charlesh97/electric-longboard-bms/Graphics/ESC3.png

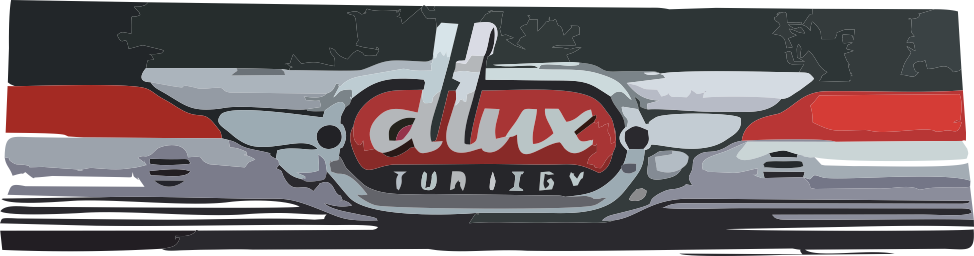
Graphics/ESC3.png
