charlesh97/electric-longboard-bms/Graphics/20160611_144058.jpg

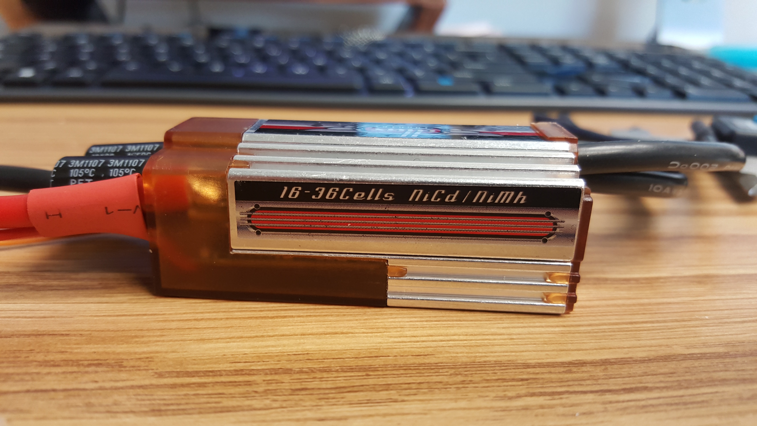
Graphics/20160611_144058.jpg
