charlesh97/electric-longboard-bms/README.md

# Electric Longboard

Archived project. 

Latest revision PDFs
[Schematic](https://gitlab.com/chood2/electric-longboard-bms/-/blob/main/HW/LongboardGaugev2%20SCH.pdf)
[PCB](https://gitlab.com/chood2/electric-longboard-bms/-/blob/main/HW/LongboardGaugev2%20PCB.pdf)
