charlesh97/electric-longboard-bms/Graphics/20160610_125514.jpg

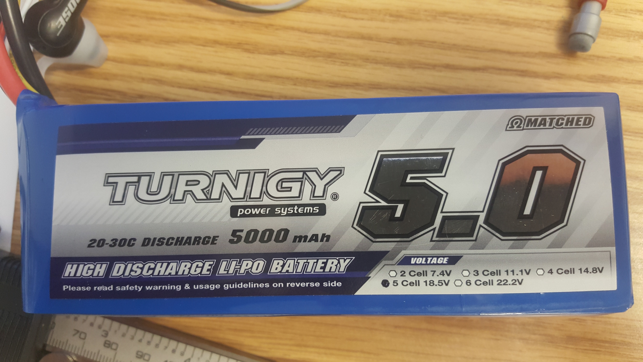
Graphics/20160610_125514.jpg
