charlesh97/electric-longboard-bms/Graphics/20160611_144035.jpg

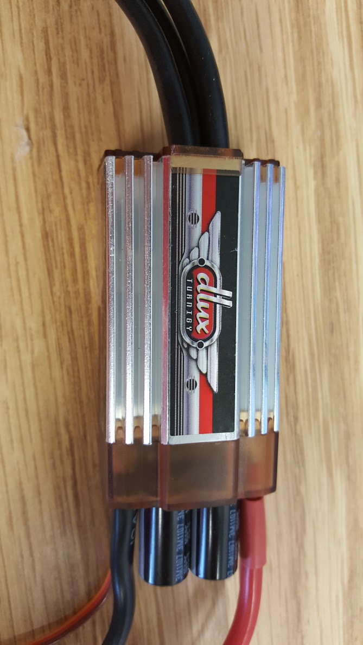
Graphics/20160611_144035.jpg
