charlesh97/electric-longboard-bms/Graphics/20160611_144050.jpg

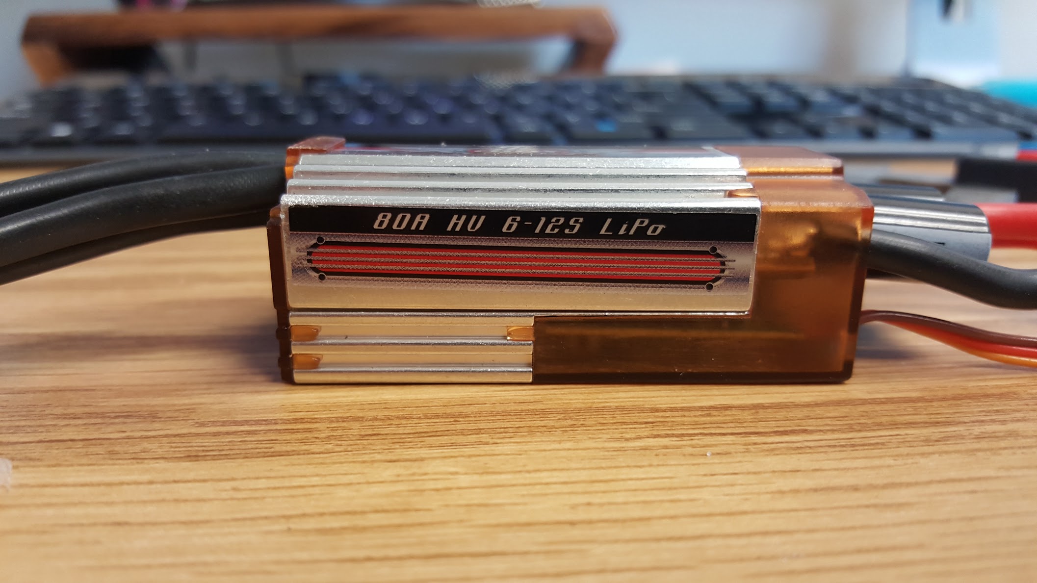
Graphics/20160611_144050.jpg
