charlesh97/electric-longboard-bms/Graphics/ESC1.png

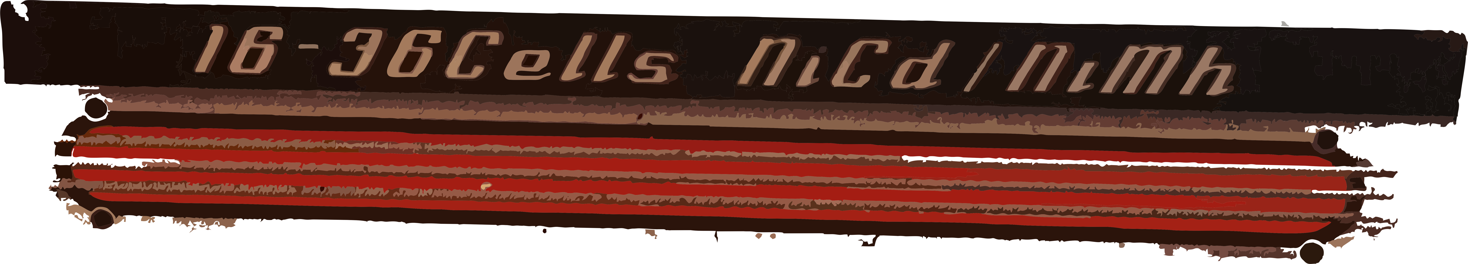
Graphics/ESC1.png
