charlesh97/electric-longboard-bms/Graphics/TurnigyBatteryGraphic.png

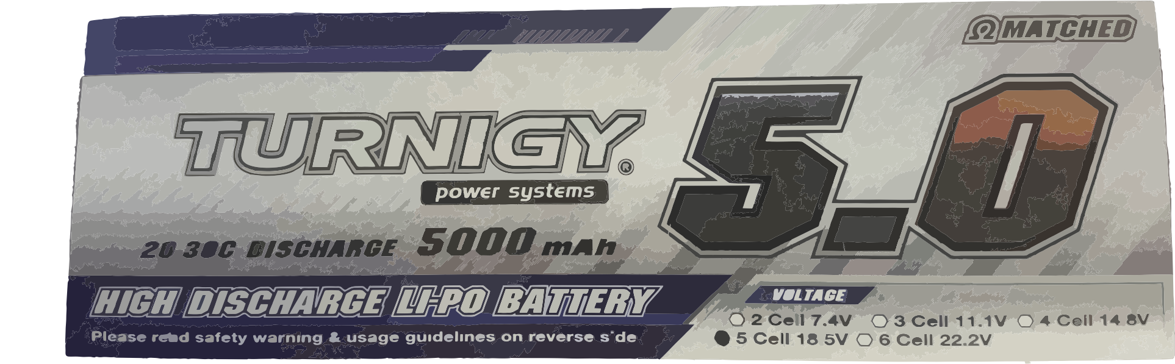
Graphics/TurnigyBatteryGraphic.png
