charlesh97/electric-longboard-bms/ElectricLongboardBOM.xlsx

Sheet: Sheet1
Part | Website | Quantity | Price | Subtotal | Notes | Bought?
Board | http://www.customskateboards.com/Blank-Podium | 1 | $48.00 | $48.00 |  | Y
Hardware | http://www.thelongboardstore.com/trucks/complete-kits/hardware-premium-assembly-kit/ | 1 | $20.00 | $20.00 |  | Y
Grip Tape | http://www.thelongboardstore.com/grip-tape/jessup/black-grip-tape-11-quot/ | 4 | $3.00 | $12.00 |  | Y
Speed Washers | http://www.thelongboardstore.com/hardware/speed-washers/speed-washers-8mm-black/ | 1 | $4.00 | $4.00 |  | Y
Trucks | http://www.amazon.com/Caliber-Fifty-Satin-Red-Trucks/dp/B00M6RWYB8?s=sporting-goods | 1 | $50.00 | $50.00 |  | Y
Wheels | http://www.amazon.com/Orangatang-Kegel-Orange-Longboard-Wheels/dp/B00EYDHWTQ | 1 | $60.00 | $60.00 | $194.00 | Y
Turnigy Aerodrive SK3 - 149kv | http://www.hobbyking.com/hobbyking/store/uh_viewItem.asp?idProduct=71864 | 1 | $67.70 | $45.92 |  | Y
80A ESC | http://www.hobbyking.com/hobbyking/store/__71036__Turnigy_dlux_80A_HV_Brushless_Speed_Controller_OPTO_AR_Warehouse_.html | 1 | $79.73 | $79.73 |  | Y
Shipping |  |  |  | $22.83 | $148.48 | Y
Gear (5mm Flange HTD 14tooth) | http://shop.sdp-si.com/catalog/product/?id=A_6A25M014DF1506 | 1 | $11.52 | $11.52
Gear (5mm HTD 36tooth) | http://shop.sdp-si.com/catalog/product/?id=A_6A25M036NF1510 | 1 | $21.47 | $21.47
Belt (15mm 49tooth 5mm HTD) | http://shop.sdp-si.com/catalog/product/?id=A_6R25M049150 | 1 | $11.16 | $11.16 | $44.15
Rubber Strip (2"x36"x3/16") 60A | https://www.grainger.com/product/GRAINGER-APPROVED-Rubber-Strip-WP165787/_/N-c1z?s_pp=false | 1 | $6.67 | $6.67
Braided Cable Sleeve (1/4"x10') | https://www.grainger.com/product/TECHFLEX-Expandable-Polyethylene-Terephthalate-WP5398576/_/N-rl1?s_pp=false | 1 | $3.92 | $3.92
Aluminum Plate (1/2"x6"x12") | https://www.grainger.com/product/GRAINGER-APPROVED-Bar-Stock-1ZCT6?functionCode=P2IDP2PCP | 1 | $23.05 | $23.05
Socket M10 20mm (pk of 10) Sale | https://www.grainger.com/product/GRAINGER-APPROVED-Metric-Socket-Head-Cap-Screw-6DA67?functionCode=P2IDP2PCP | 2 | $3.00 | $6.00
ABS Sheet 1/8"x48"x12" | http://www.grainger.com/product/GRAINGER-APPROVED-ABS-Sheet-Stock-WP143594/_/N-c1p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 | 2 | $13.54 | $27.08
Battery (Option 1: 5s 5Ah 20C) | http://www.hobbyking.com/hobbyking/store/uh_viewItem.asp?idProduct=9174 | 2 | $39.78 | $79.56
Compact Charger | http://www.hobbyking.com/hobbyking/store/__92016__Turnigy_B6_Compact_50W_5A_Automatic_Balance_Charger_2_6S_Lipoly_US_Warehouse_.html | 1 | $14.78 | $14.78
Turnigy Battery Charger 80W | http://www.hobbyking.com/hobbyking/store/__56900__Turnigy_Double_Tap_7A_80Wx2_6S_Balance_Charger_Discharger_US_Warehouse_.html | 1 | $61.06 | $61.06 | $155.40
El Wire | http://www.amazon.com/Blue-Neon-Glowing-Strobing-Electroluminescent/dp/B003J99JW4 | 1 | $3.78 | $3.78
LEDs | https://www.digikey.com/product-detail/en/cree-inc/XPEBTT-01-0000-00V80/XPEBTT-01-0000-00V80CT-ND/5725124 | 5 | $1.22 | $6.10
Components & PCB |  | 1 | $50.00 | $50.00
 |  |  |  | $618.63 | <--Total
Alternative
Gear (5mm Flange HTD 12tooth) | http://shop.sdp-si.com/catalog/product/?id=A_6A25M012DF1506 | 1 | $11.24
Gear (5mm HTD 40tooth) | http://shop.sdp-si.com/catalog/product/?id=A_6A25M040NF1510 | 1 | $24.95 | $24.95 | Tooth number TBD
Motor 236kV | http://www.hobbyking.com/hobbyking/store/__71859__Turnigy_Aerodrive_SK3_5065_236kv_Brushless_Outrunner_Motor_AR_Warehouse_.html | 1 | $58.14
LG HD2 18650 3.7V 2Ah 25A Cell | https://www.imrbatteries.com/lg-hd2-18650-2000mah-25a-flat-top-battery/ | 30 | $5.00 |  | $24.95
100A ESC | http://www.hobbyking.com/hobbyking/store/__38787__Turnigy_Sentilon_V4_100A_5_12s_HV_Bulletproof_Speed_Controller_w_RPM_Sensor.html | 1 | $85.58
Battery 10Ah | http://batterybuilding.en.made-in-china.com/product/eKEQsmVAvxpC/China-Rechargeable-LiFePO4-Prismatic-Battery-Pack-3-2V-20ah-for-EV-or-Power-Tools.html | 10 | $1.00
Sony VTC5 2600mAh 30A | http://www.dhgate.com/product/100-authentic-original-18650-rechargeable/214526805.html | 30 | $3.81
Sony VTC5 | http://www.aliexpress.com/item/16Pcs-Original-US18650VTC5-3-7V-2600mAh-18650-high-drain-30A-vtc5-battery-for-Sony-electonic-cigarette/32607288152.html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 | 1 | $94.63 | $154.63
Motor 192kV | http://www.hobbyking.com/hobbyking/store/__18129__Turnigy_Aerodrive_SK3_6374_192kv_Brushless_Outrunner_Motor.html
Power Plug (Female) | http://www.digikey.com/product-detail/en/switchcraft-inc/L712RAS/SC1394-ND/2238437 | 1 | $6.88 | $6.88
Cell Terminal Clip | http://www.digikey.com/product-detail/en/keystone-electronics/5231/36-5231-ND/316380 | 60 | $0.20 | $12.12
BQ76940 | http://www.digikey.com/product-detail/en/texas-instruments/BQ7694003DBT/296-37789-5-ND/4842191 | 1 | $10.15 | $10.15
BQ78350 | http://www.digikey.com/product-detail/en/texas-instruments/BQ78350DBT/296-38026-5-ND/4959466 | 1 | $6.45 | $6.45
Extra Circuit Components |  | 1 | $50.00 | $50.00 | Guess-timation
PCB |  | 1 | $15.00 | $15.00 | Might get free

Sheet: Sheet2
Index | Quantity | Part Number | Manufacturer Part Number | Description | Customer Reference | Backorder | Unit Price | Extended Price
1 | 10 | 490-12344-1-ND | GRT21BC81C106ME01L | CAP CER 10UF 16V X6S 0805 |  | 0 | 0.146 | $1.46
2 | 10 | 490-3338-1-ND | GRM21BR61C475KA88L | CAP CER 4.7UF 16V X5R 0805 |  | 0 | 0.12 | $1.20
3 | 50 | 1276-6495-1-ND | CL21F105ZBFNNNG | CAP CER 1UF 50V Y5V 0805 |  | 0 | 0.022 | $1.10
4 | 50 | 1276-1003-1-ND | CL21B104KBCNNNC | CAP CER 0.1UF 50V X7R 0805 |  | 0 | 0.026 | $1.30
5 | 10 | 490-1308-1-ND | GRM155R71H472KA01D | CAP CER 4700PF 50V X7R 0402 |  | 0 | 0.011 | $0.11
6 | 10 | 490-3248-1-ND | GRM155R71H332KA01D | CAP CER 3300PF 50V X7R 0402 |  | 0 | 0.011 | $0.11
7 | 10 | 490-1297-1-ND | GRM1555C1H471JA01D | CAP CER 470PF 50V NP0 0402 |  | 0 | 0.026 | $0.26
8 | 50 | P1.00MFCT-ND | ERJ-8ENF1004V | RES SMD 1M OHM 1% 1/4W 1206 |  | 0 | 0.0282 | $1.41
9 | 3 | P300KDACT-ND | ERA-6AEB304V | RES SMD 300K OHM 0.1% 1/8W 0805 |  | 0 | 0.63 | $1.89
10 | 50 | P221KCCT-ND | ERJ-6ENF2213V | RES SMD 221K OHM 1% 1/8W 0805 |  | 0 | 0.022 | $1.10
11 | 50 | P100KCCT-ND | ERJ-6ENF1003V | RES SMD 100K OHM 1% 1/8W 0805 |  | 0 | 0.022 | $1.10
12 | 3 | P13.7KDACT-ND | ERA-6AEB1372V | RES SMD 13.7K OHM 0.1% 1/8W 0805 |  | 0 | 0.63 | $1.89
13 | 50 | P3.01KCCT-ND | ERJ-6ENF3011V | RES SMD 3.01K OHM 1% 1/8W 0805 |  | 0 | 0.022 | $1.10
14 | 4 | 541-1.00KAFCT-ND | CRCW25121K00FKEG | RES SMD 1K OHM 1% 1W 2512 |  | 0 | 0.36 | $1.44
15 | 50 | P1.00KCCT-ND | ERJ-6ENF1001V | RES SMD 1K OHM 1% 1/8W 0805 |  | 0 | 0.022 | $1.10
16 | 50 | 1276-5671-1-ND | RC3216F101CS | RES SMD 100 OHM 1% 1/4W 1206 |  | 0 | 0.0184 | $0.92
17 | 50 | P100CCT-ND | ERJ-6ENF1000V | RES SMD 100 OHM 1% 1/8W 0805 |  | 0 | 0.022 | $1.10
18 | 10 | 490-4801-1-ND | NCP15XH103F03RC | THERMISTOR 10K OHM NTC 0402 SMD |  | 0 | 0.107 | $1.07
19 | 2 | SMCJ28AFSCT-ND | SMCJ28A | TVS DIODE 28VWM 45.4VC SMC |  | 0 | 0.46 | $0.92
20 | 10 | 1N4148W-FDICT-ND | 1N4148W-7-F | DIODE GEN PURP 100V 300MA SOD123 |  | 0 | 0.149 | $1.49
21 | 2 | MURS360T3GOSCT-ND | MURS360T3G | DIODE GEN PURP 600V 3A SMC |  | 0 | 0.65 | $1.30
22 | 10 | MMSZ5232BS-FDICT-ND | MMSZ5232BS-7-F | DIODE ZENER 5.6V 200MW SOD323 |  | 0 | 0.247 | $2.47
23 | 4 | MMSZ5246B-FDICT-ND | MMSZ5246B-7-F | DIODE ZENER 16V 500MW SOD123 |  | 0 | 0.2 | $0.80
24 | 2 | SMBJ30A-FDICT-ND | SMBJ30A-13-F | TVS DIODE 30VWM 48.4VC SMB |  | 0 | 0.36 | $0.72
25 | 2 | MUR860GOS-ND | MUR860G | DIODE GEN PURP 600V 8A TO220AC |  | 0 | 0.9 | $1.80
26 | 4 | 296-30572-1-ND | CSD18504Q5A | MOSFET N-CH 40V 8SON |  | 0 | 1.53 | $6.12
27 | 10 | BSS138CT-ND | BSS138 | MOSFET N-CH 50V 220MA SOT-23 |  | 0 | 0.178 | $1.78
28 | 10 | BSS84PH6433XTMA1CT-ND | BSS84PH6433XTMA1 | MOSFET P-CH 60V 170MA SOT-23 |  | 0 | 0.167 | $1.67
29 | 4 | MMBT3906FSCT-ND | MMBT3906 | TRANS PNP 40V 0.2A SOT-23 |  | 0 | 0.2 | $0.80
30 | 1 | SC1396-ND | JCAP | POWER JACK SEAL CAP |  | 0 | 1.65 | $1.65
31 | 1 | SC1390-ND | L712AS | CONN PWR JACK 2.5MM SEALED |  | 0 | 6.55 | $6.55
32 | 10 | 455-2271-ND | B6B-XH-A(LF)(SN) | CONN HEADER XH TOP 6POS 2.5MM |  | 0 | 0.258 | $2.58
33 | 2 | 497-13798-1-ND | STCC2540IQTR | IC USB CHARGING CTLR SW 16VFQFPN |  | 0 | 1.09 | $2.18
34 | 50 | P10.0KCCT-ND | ERJ-6ENF1002V | RES SMD 10K OHM 1% 1/8W 0805 |  | 0 | 0.022 | $1.10
35 | 50 | P499KCCT-ND | ERJ-6ENF4993V | RES SMD 499K OHM 1% 1/8W 0805 |  | 0 | 0.022 | $1.10
36 | 2 | 296-43798-1-ND | LDC0851HDSGT | INDUCTIVE PROXIMITY SWITCH 8WSON |  | 0 | 1.34 | $2.68
 |  |  |  |  |  |  | Subtotal | $57.37
