charlesh97/electric-longboard-bms/CAD/handheld_.SLDPRT

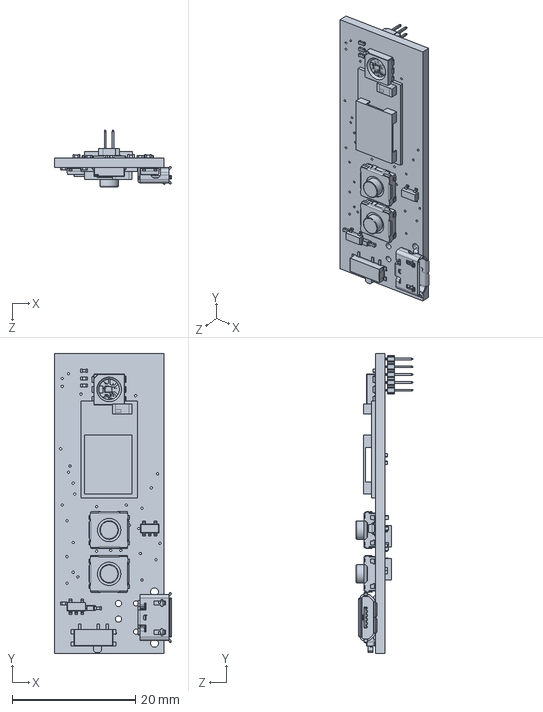
[picture p8: CAD file, 2022-02-06]
CAD/handheld_.SLDPRT
19.0 x 48.8 x 9.20 mm
