charlesh97/electric-longboard-bms/CAD/STP/34tooth.stp

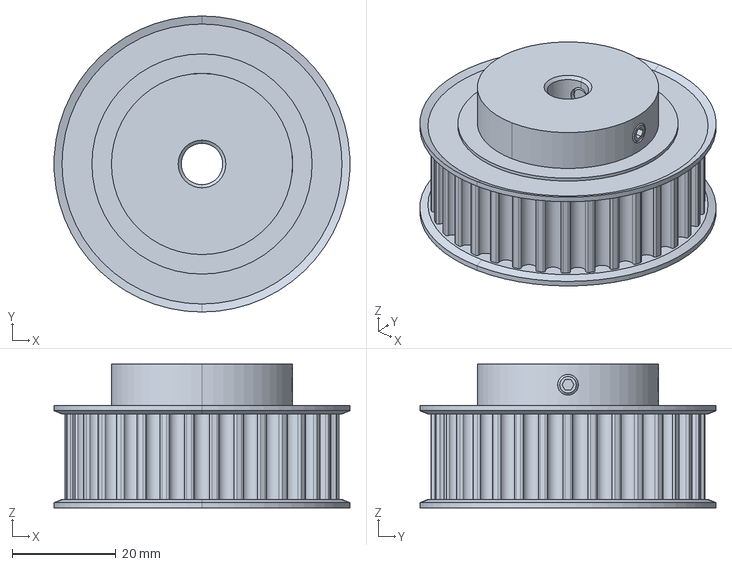
[picture p9: CAD file, 2022-02-06]
CAD/STP/34tooth.stp
57.1 x 57.2 x 27.8 mm
