charlesh97/electric-longboard-bms/HW/OldBoards/Breakout/test2.SLDASM

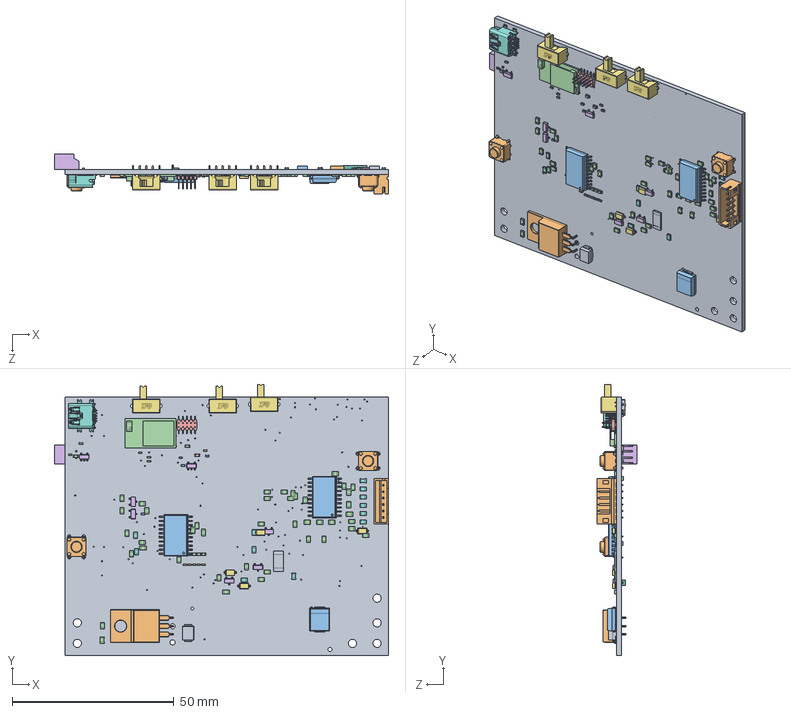
[picture p10: CAD file, 2022-02-06, an earlier design]
HW/OldBoards/Breakout/test2.SLDASM
103.3 x 83.9 x 12.4 mm
test2
Header Socket 2_0 6x
0402c_2320560 x 14
JST SxB-PH-K-S (RIGHT ANGLE)
SOD123 x 4
SOD 123 x 4
Diod SMD 10BF10
TO-220
SMC
SMD_LED_0603 x 7
STEP-WL-SMCW-0603-rev1
SOT 23 x 5
0402r_1430758 x 14
Resistor 0805 x 13
Tact DIP 6x6 x 2
SO_IC20 x 2
BLE113 v0
AmphenolConnHeader
SOT 23-5 x 2
CKN9559-ND x 3
USB_Mini_B_SMD_buchse
KXCJ9_KXCJ9
FXAS21002_FXAS21002
MLP3115A2_MLP3115A2
