charlesh97/electric-longboard-bms/HW/LongboardGaugev2 PCB.pdf

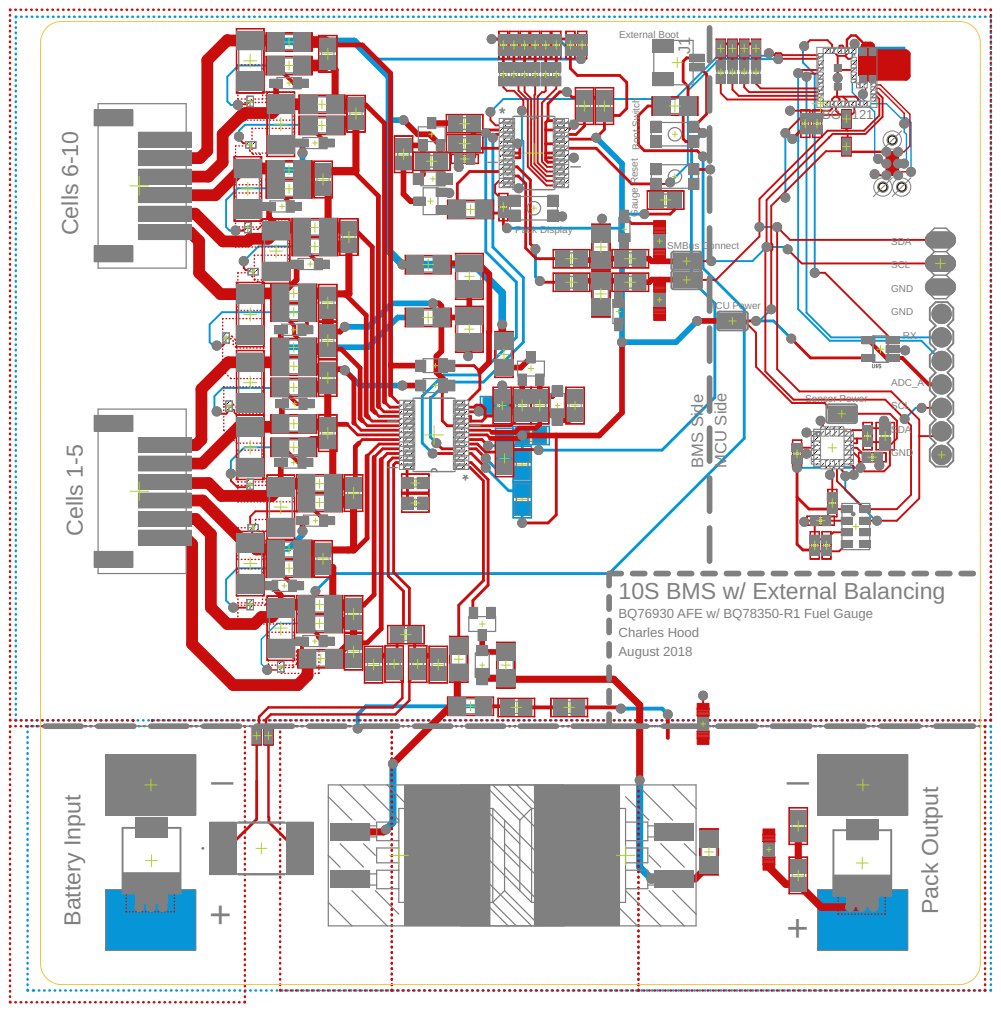
[picture p11: page 1]

Cells 1-5 Cells 6-10 10S BMS w/ External Balancing BQ76930 AFE w/ BQ78350-R1 Fuel Gauge Charles Hood August 2018 Battery Input Pack Output + _ _+ MCU Side BMS Side Gauge Reset Boot Switch External Boot Pack Display SDA SCL GND GNDRX ADC_A SCL SDA GND Sensor Power MCU Power SMBus Connect * -HEATSINK- -HEATSINK- * BGM121 J1 * *
