charlesh97/electric-longboard-bms/HW/LongboardGaugev2 SCH.pdf

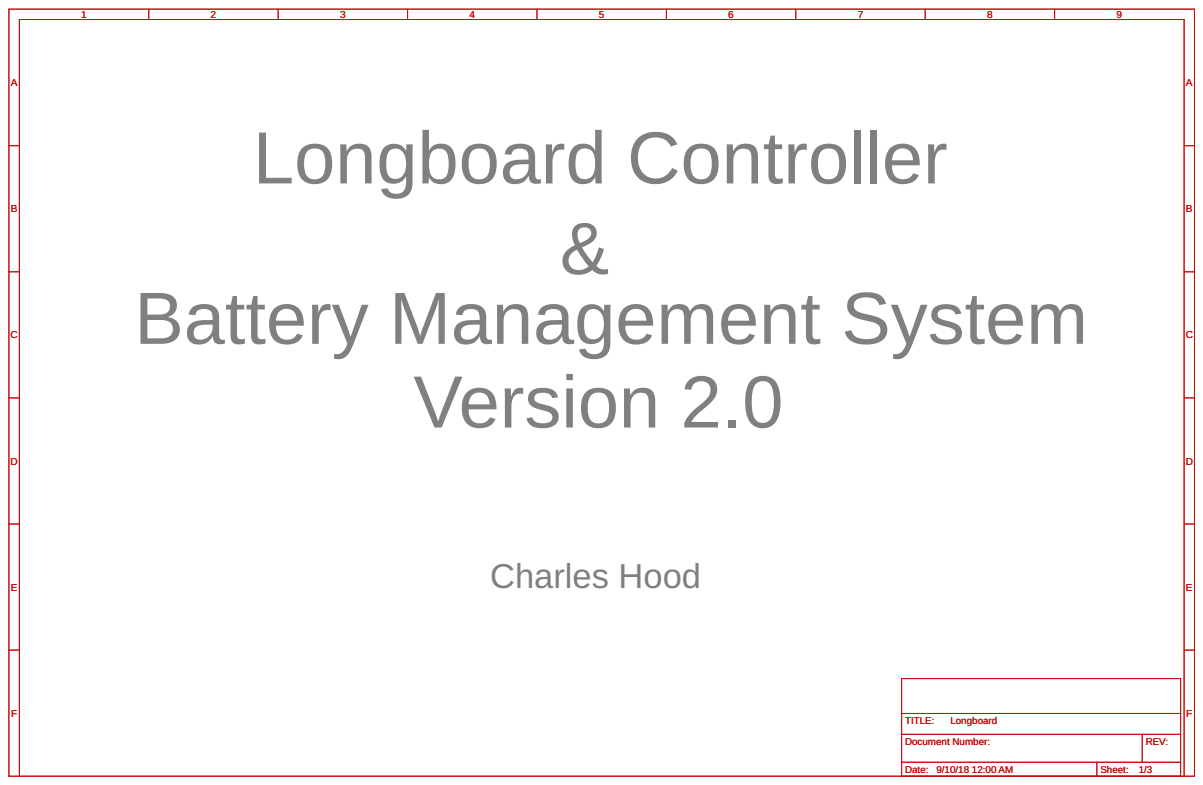
[picture p12: page 1]

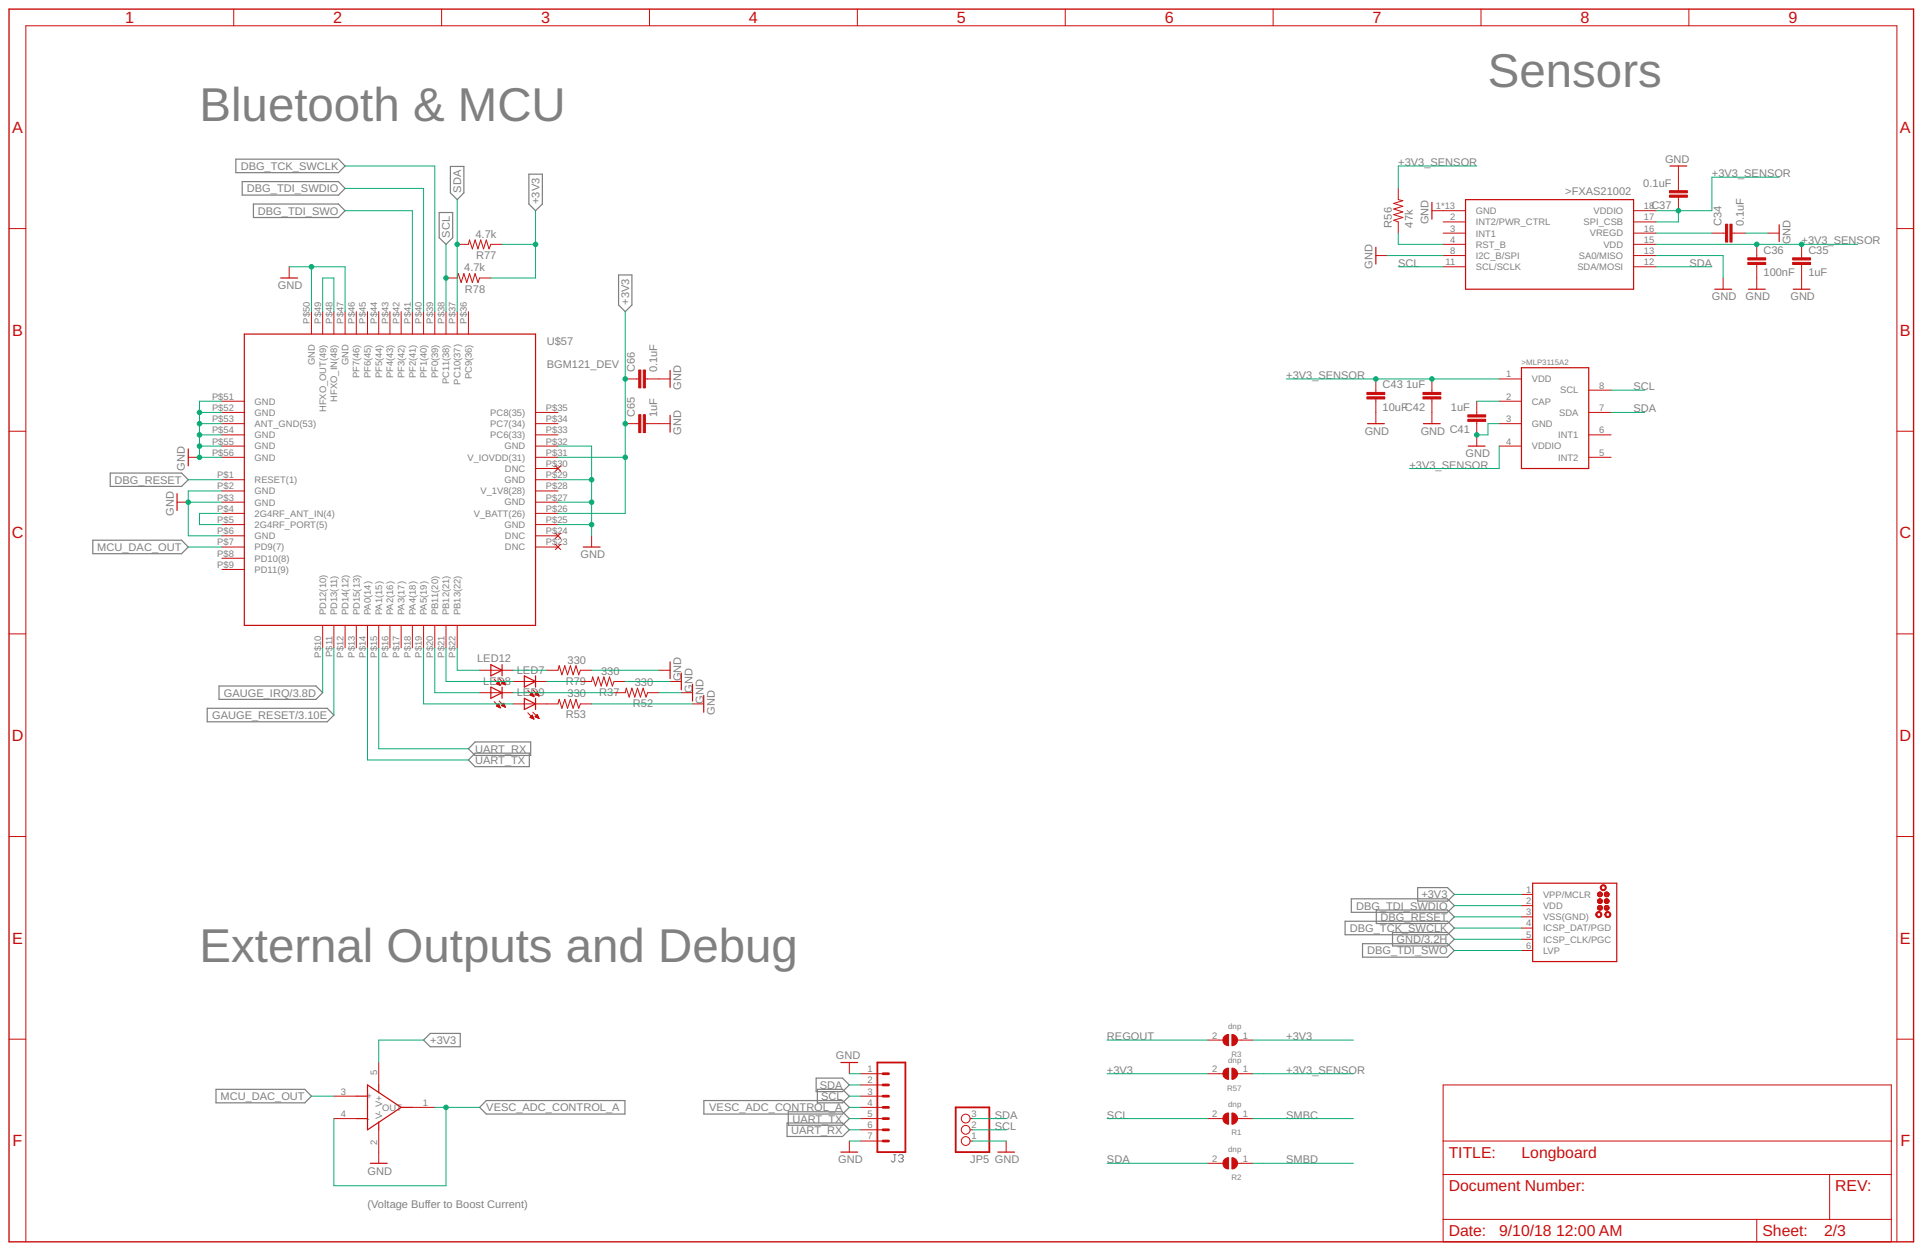
[picture p13: page 2]

External Outputs and Debug

(Voltage Buffer to Boost Current)

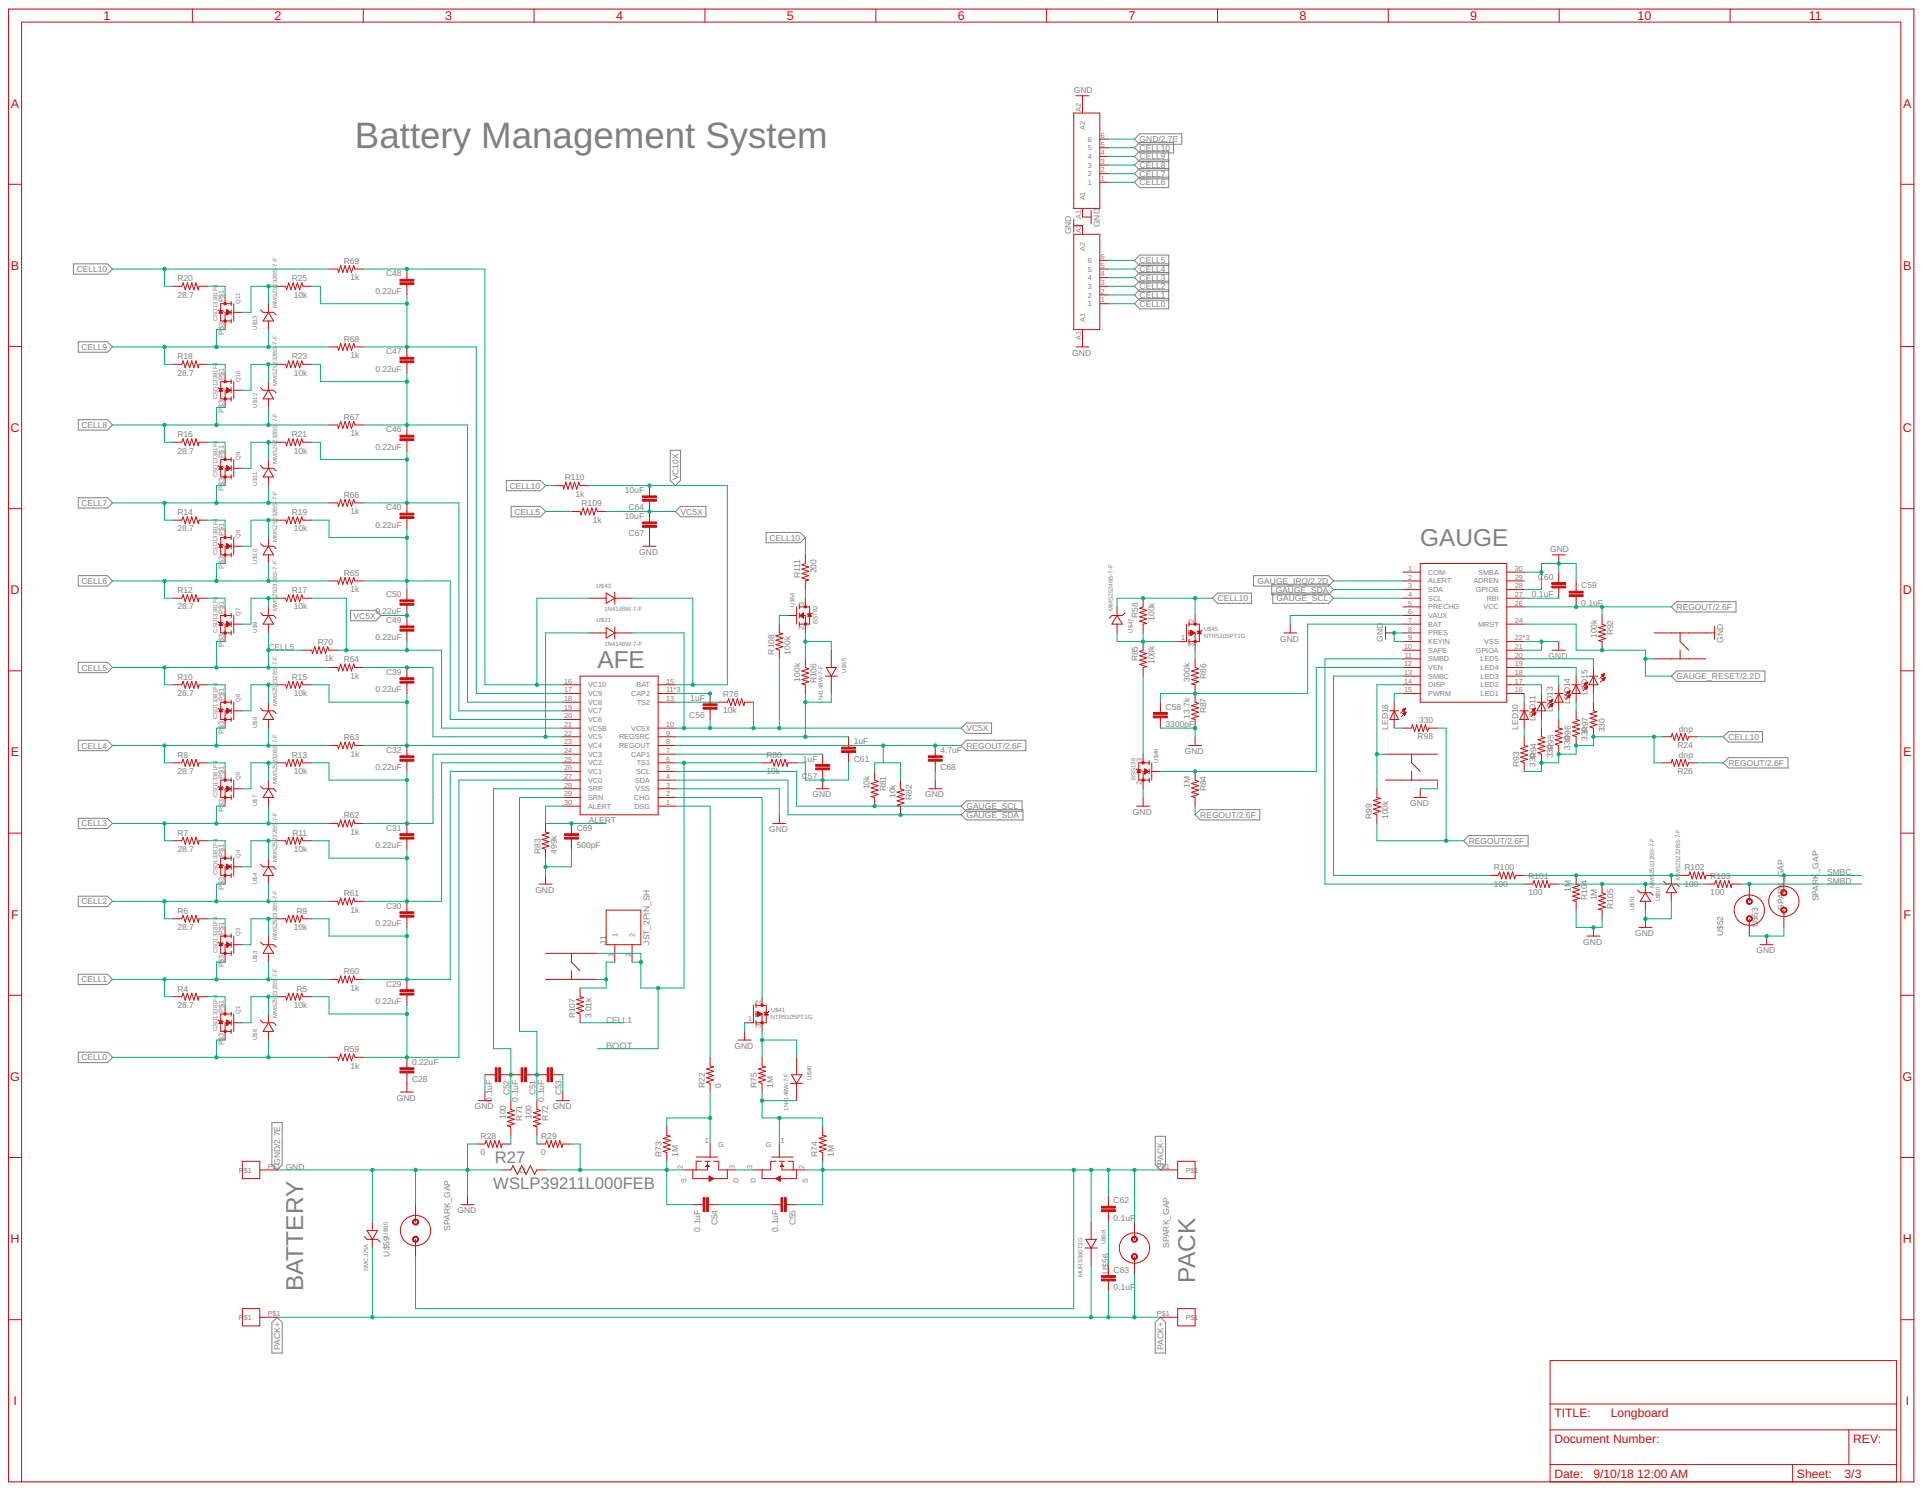
[picture p14: page 3]

BATTERY PACK GAUGE AFE Battery Management System BOOT 100k 1k 0.22uF 0.22uF 0.22uF 0.22uF 0.22uF 0.22uF 0.22uF 0.22uF 0.22uF 0.22uF 1k1k1k1k1k1k1k1k1k1k 0.22uF 1k 0.22uF 1N4148W-7-F 0.1uF 0.1uF 0.1uF GND GND 100 100 0.1uF 0.1uF 1M1M 1N4148W-7-F 1M NTR5105PT1G GND GND 1N4148W-7-F 1uF 10k 1uFGND 10k 10k 10k GND 499k GND NTR5105PT1G BSS138 1M GND 100k 300k 13.7k 3300pFGND MMSZ5246B-7-F GND 0.1uF 0.1uF 100k GND 33033033033033330 0 100kGND GND GND 100 100 100 100 1M 1M MMSZ5232BS-7-F MMSZ5232BS-7-F GND GND GND 1uF BST82 1N4148W-7-F 100k 3.01k 0.1uF 0.1uF MURS360T3G SMCJ75A 100k 1k 10uF 10uFGND 1k 200 4.7uF GND 500pF 10k GND 10k 10k 10k 10k 10k 10k 10k 10k 10k MMSZ5232BS-7-F CSD13381F4 CSD13381F4 CSD13381F4 CSD13381F4 CSD13381F4 CSD13381F4 CSD13381F4 CSD13381F4 CSD13381F4 CSD13381F4 28.7 28.7 MMSZ5232BS-7-F 28.7 MMSZ5232BS-7-F 28.7 MMSZ5232BS-7-F 28.7 MMSZ5232BS-7-F 28.7 MMSZ5232BS-7-F 28.7 MMSZ5232BS-7-F 28.7 MMSZ5232BS-7-F MMSZ5232BS-7-F MMSZ5232BS-7-F 28.7 28.7 0 dnp dnp GND WSLP39211L000FEB GND GNDGND GND 0 0 DSG 1 CHG 2 VSS 3 SDA 4 SCL 5 TS1 6 CAP1 7 REGOUT 8 REGSRC 9 VC5X 10 TS2 13 CAP2 11*3 BAT 15 VC10 16 VC9 17 VC8 18 VC7 19 VC6 20 VC5B 21 VC5 22 VC4 23 VC3 24 VC2 25 VC1 26 VC0 27 SRP 28 SRN 29 ALERT 30 R58 R59 C28 C29 C30 C31 C32 C39 C40 C46 C47 C48 R60 R61 R62 R63 R64 R65 R66 R67 R68 R69 C49 R70 C50 U$21 C51 C52 C53 R71 R72 D 3 S 2 G 1 D 3 S 2 G 1 C54 C55 R73 R74 U$40 R75 1 3 2 U$41 U$43 C56 R76 C57 R80 R81 R82 R83 COM 1 ALERT 2 SDA 3 SCL 4 PRECHG 5 VAUX 6 BAT 7 PRES 8 KEYIN 9 SAFE 10 SMBD 11 VEN 12 SMBC 13 DISP 14 PWRM 15 LED1 16 LED2 17 LED3 18 LED4 19 LED5 20 GPIOA 21 VSS 22*3 MRST 24 VCC 26 RBI 27 GPIOB 28 ADREN 29 SMBA 30 1 3 2 U$45 2 3U$46 R84 R85 R86 R87 C58 U$47 C59 C60 R92 LED10 LED11 LED13 LED14 LED15 R93R94R95R96R97 LED16 R98 R99 R100 R101 R102 R103 R104 R105 U$50 U$51 U$52 SPARK_GAP U$53 SPARK_GAP C61 2 U3$54 U$55 R106 R107 U$56 SPARK_GAC62 P C63 U$58 U$59 SPARK_GAP U$60 R108 R109 C64 C67 R110 R111 C68 C69 R5 R9 R11 R13 R15 R17 R19 R21 R23 R25 U$6 P$3 P$1 Q1 P$3 P$1 Q3 P$3 P$1 Q4 P$3 P$1 Q5 P$3 P$1 Q6 P$3 P$1 Q7 P$3 P$1 Q8 P$3 P$1 Q9 P$3 P$1 Q10 P$3 P$1 Q11 R4 R6 U$3 R7 U$4 R8 U$7 R10 U$8 R12 U$9 R14 U$10 R16 U$11 U$12 U$13 R18 R20 R22 R24 R26 1 1 2 2 J1JST_2PIN_SH P$1 P$1 P$1 P$1 P$1 P$1 P$1 P$1 11 R27 1 1 2 2 3 3 4 4 5 5 6 6 A1 A1 A2 A2 1 1 2 2 3 3 4 4 5 5 6 6 A1 A1 A2 A2 R28 R29 GND GND/2.7E GND/2.7E CELL1 CELL1 CELL1 CELL4 CELL4 CELL5 CELL5 CELL5 CELL5 CELL6 CELL6 CELL7 CELL7 CELL8 CELL8 CELL9 CELL9 VC5X VC5X VC5X PACK- VC10X REGOUT/2.6F REGOUT/2.6F REGOUT/2.6F REGOUT/2.6F REGOUT/2.6F ALERT CELL10 CELL10 CELL10 CELL10 CELL10 CELL10 GAUGE_RESET/2.2D SMBC SMBD PACK+ PACK+ GAUGE_SDA GAUGE_SDA GAUGE_SCL GAUGE_SCL GAUGE_IRQ/2.2D CELL2 CELL2 CELL3 CELL3 CELL0 CELL0 ABCDEFGHI ABCDEFGHI 1 2 3 4 5 6 7 8 9 10 11 Date: Sheet: REV: TITLE: Document Number: 9/10/18 12:00 AM 3/3 Longboard
