charlesh97/electric-longboard-bms/HW/OldBoards/Longboard AFE/AFE_Only_ReplacedDischarge.brd

## EAGLE design HW/OldBoards/Longboard AFE/AFE_Only_ReplacedDischarge.brd (2022-02-06, an earlier design)

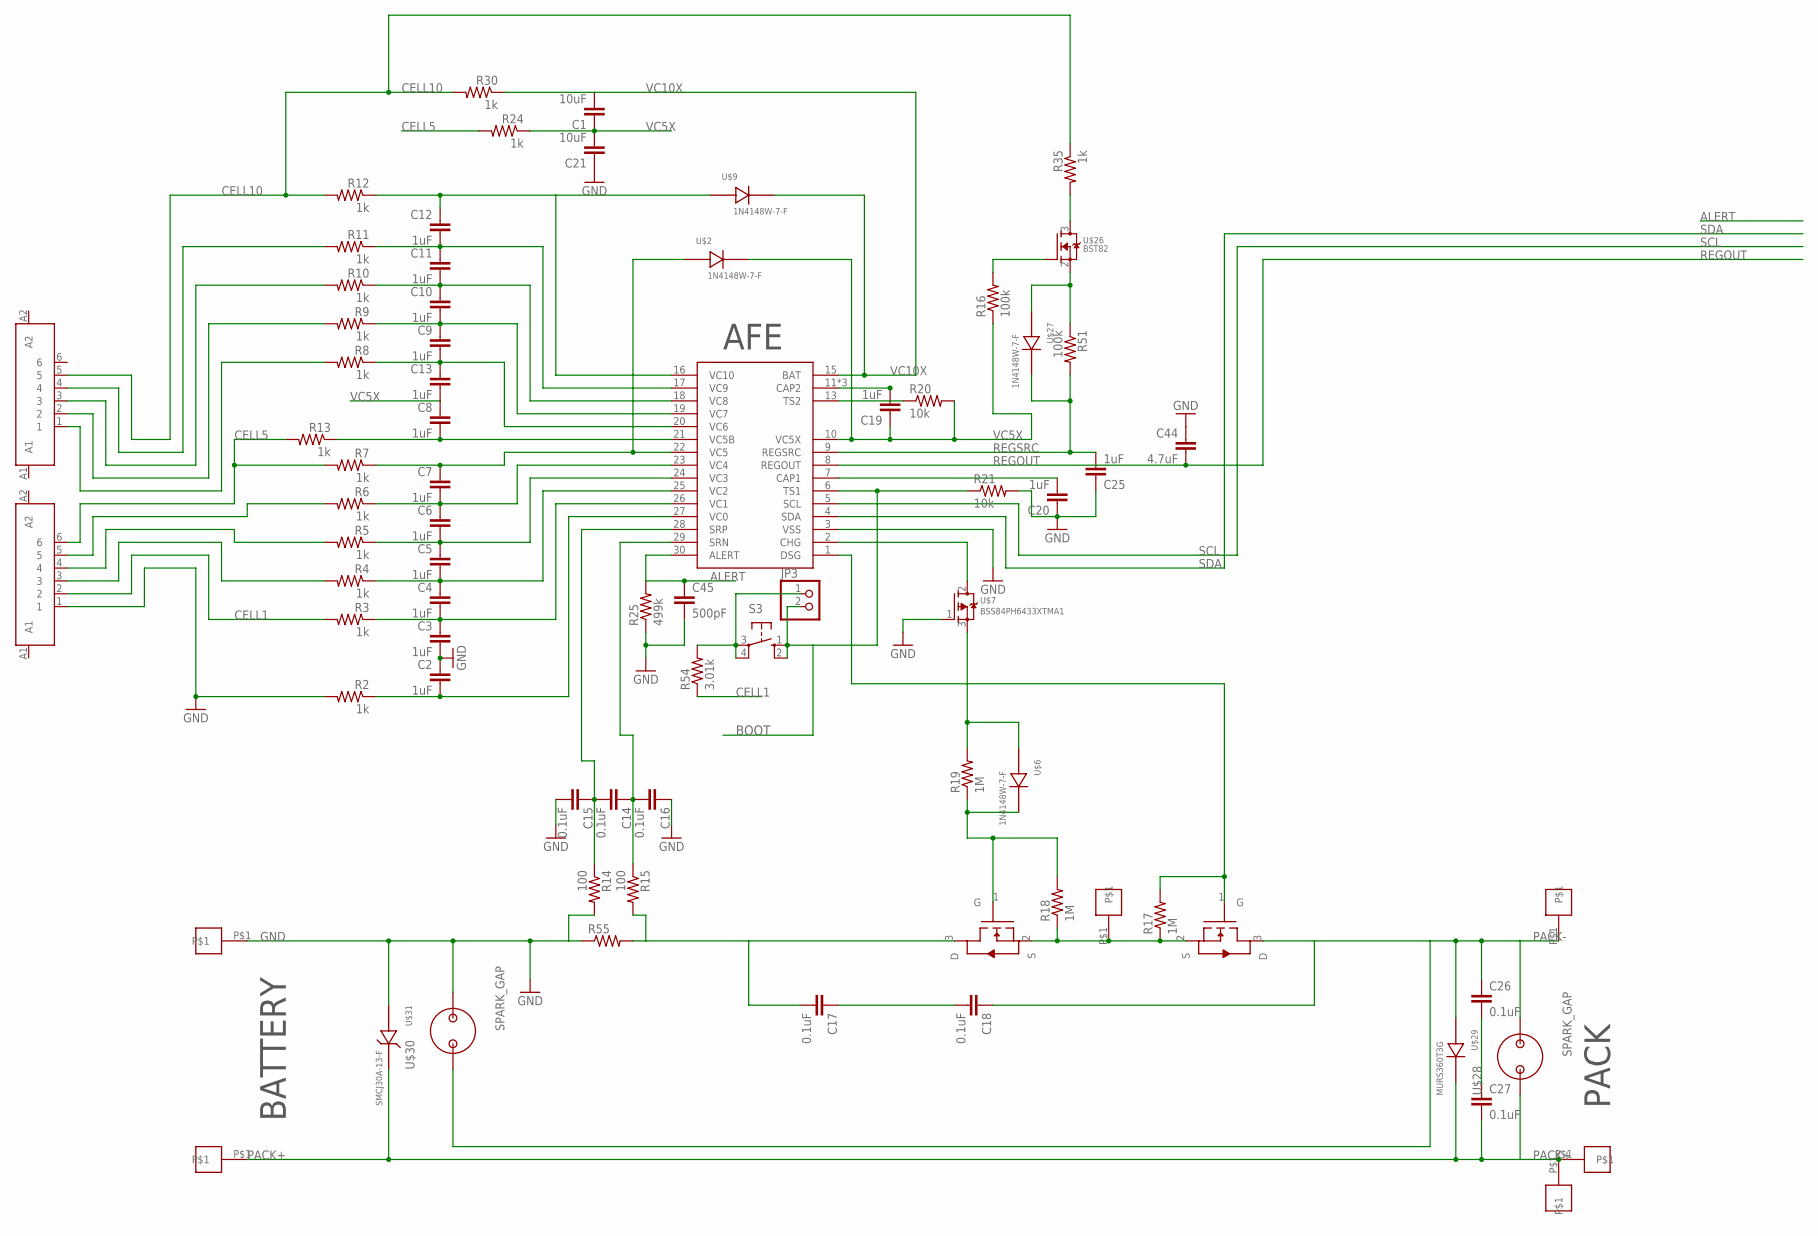
[picture p15: schematic AFE_Only_ReplacedDischarge.sch, sheet 1]

Parts:
C1, C21: 10uF; C1210
C2, C3, C4, C5, C6, C7, C8, C9, C10, C11, C12, C13, C19, C20, C25: 1uF; C0805
C14, C15, C16, C17, C18, C26, C27: 0.1uF; C0805
C44: 4.7uF; C0805
C45: 500pF; C0603
JP3: PINHD-1X2; 1X02
R2, R3, R4, R5, R6, R7, R8, R9, R10, R11, R12, R13, R24, R30, R35: 1k; R1206
R14, R15: 100; R0805
R16, R51: 100k; R0805
R17, R18, R19: 1M; R1206
R20, R21: 10k; R0805
R25: 499k; R0603
R54: 3.01k; R1206
R55: R-US_R2512; R2512
S3: 10-XX; B3F-10XX
U$1: BQ76930; SOIC-30
U$2, U$6, U$9, U$27: 1N4148W-7-F; SOD-123
U$3, U$35, U$36, U$37, U$38, U$39: PAD
U$4, U$5: AOB290L; TO-263
U$7: BSS84PH6433XTMA1; SOT23-3
U$24, U$33: JST_6PIN
U$26: BST82; SOT23-3
U$28, U$30: SPARK_GAP
U$29: MURS360T3G; SMC(DO-214AB)
U$31: SMCJ30A-13-F; SMB(DO-214AA)

Connections:
ALERT: C45.1, R25.2, U$1.30 (ALERT); also elsewhere on the board
BOOT: JP3.2, R21.1, S3.1 (S), S3.2 (S1), U$1.6 (TS1)
CELL1: R3.2, R54.1, U$33.2
CELL5: R7.2, R13.2, R24.2, U$33.6
CELL10: R12.2, R30.2, R35.1, U$24.5
CHARGE-: R17.1, R18.1, U$4.2 (S), U$5.2 (S), U$37.P$1
GND: C2.1, C3.2, C15.2, C16.1, C20.1, C21.1, C25.1, C44.1, C45.2, R2.2, R14.2, R21.2, R25.1, R55.1, U$1.3 (VSS), U$3.P$1, U$7.1 (G), U$30.P$2, U$31.P$1 (1), U$33.1; also elsewhere on the board
unnamed: C3.1, C4.2, R3.1, U$1.26 (VC1)
unnamed: C4.1, C5.2, R4.1, U$1.25 (VC2)
unnamed: C5.1, C6.2, R5.1, U$1.24 (VC3)
unnamed: C6.1, C7.2, R6.1, U$1.23 (VC4)
unnamed: C7.1, R7.1, U$1.22 (VC5), U$2.P$1
unnamed: C8.2, R13.1, U$1.21 (VC5B)
unnamed: C9.1, C10.2, R9.1, U$1.19 (VC7)
unnamed: C10.1, C11.2, R10.1, U$1.18 (VC8)
unnamed: C11.1, C12.2, R11.1, U$1.17 (VC9)
unnamed: C12.1, R12.1, U$1.16 (VC10), U$9.P$1
unnamed: R5.2, U$33.4
unnamed: C2.2, R2.1, U$1.27 (VC0)
unnamed: C26.2, C27.1
unnamed: R4.2, U$33.3
unnamed: R6.2, U$33.5
unnamed: R8.2, U$24.1
unnamed: R9.2, U$24.2
unnamed: R10.2, U$24.3
unnamed: R11.2, U$24.4
unnamed: C9.2, C13.1, R8.1, U$1.20 (VC6)
unnamed: R16.2, U$26.1 (G)
unnamed: C20.2, U$1.7 (CAP1)
unnamed: C14.1, C16.2, R15.1, U$1.29 (SRN)
unnamed: JP3.1, R54.2, S3.3, S3.4 (P1)
unnamed: C14.2, C15.1, R14.1, U$1.28 (SRP)
unnamed: R18.2, R19.1, U$5.1 (G), U$6.P$2
unnamed: R19.2, U$6.P$1, U$7.3 (D)
unnamed: U$1.2 (CHG), U$7.2 (S)
unnamed: C17.1, C18.2
unnamed: C19.2, U$1.11 (CAP2), U$1.12 (CAP2), U$1.14 (CAP2)
unnamed: R20.1, U$1.13 (TS2)
unnamed: C17.2, R15.2, R55.2, U$5.3 (D)
unnamed: R17.2, U$1.1 (DSG), U$4.1 (G)
unnamed: R51.1, U$26.2 (S), U$27.P$1
unnamed: R35.2, U$26.3 (D)
PACK+: C27.2, U$28.P$1, U$29.2, U$31.P$2 (2), U$35.P$1, U$36.P$1, U$39.P$1
PACK-: C18.1, C26.1, U$4.3 (D), U$28.P$2, U$29.1, U$30.P$1, U$38.P$1
REGOUT: C44.2, U$1.8 (REGOUT); also elsewhere on the board
REGSRC: C25.2, R51.2, U$1.9 (REGSRC), U$27.P$2
SCL: U$1.5 (SCL); also elsewhere on the board
SDA: U$1.4 (SDA); also elsewhere on the board
VC5X: C1.1, C8.1, C13.2, C19.1, C21.2, R16.1, R20.2, R24.1, U$1.10 (VC5X), U$2.P$2
VC10X: C1.2, R30.1, U$1.15 (BAT), U$9.P$2

Notes on the sheet:
BATTERY
PACK
AFE

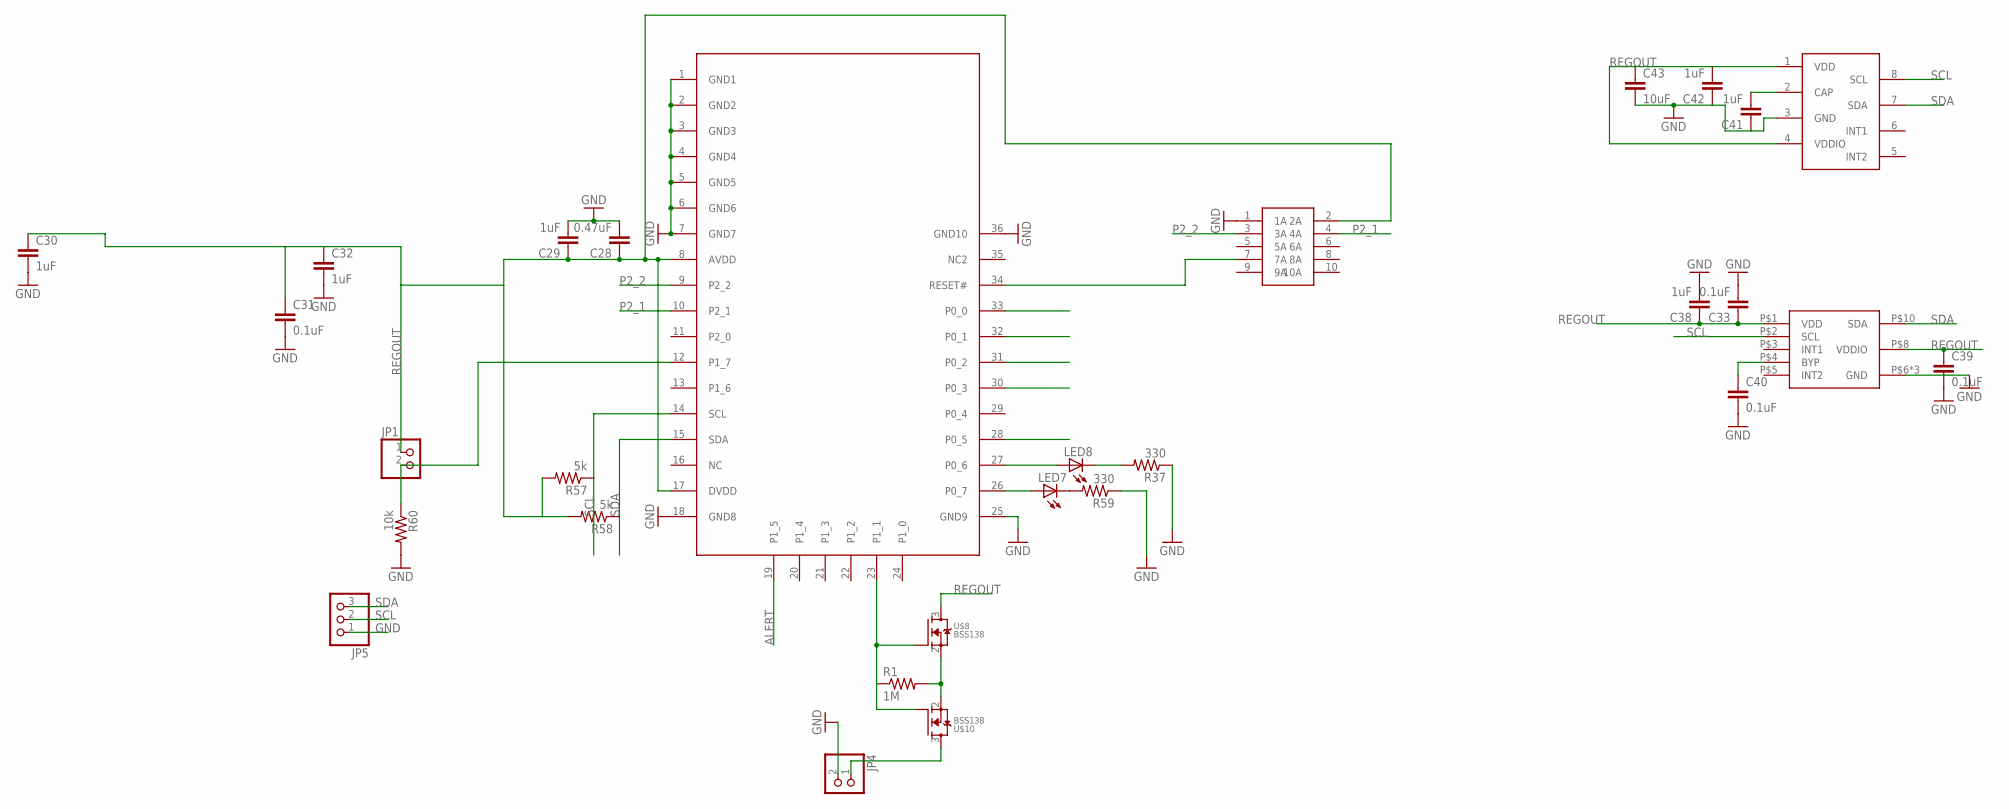
[picture p16: schematic AFE_Only_ReplacedDischarge.sch, sheet 2]

Parts:
C28: 0.47uF; C0402
C29, C30, C32, C38, C41, C42: 1uF; C0402
C31, C33, C39, C40: 0.1uF; C0402
C43: 10uF; C0603
JP1, JP4: PINHD-1X2; 1X02
JP5: PINHD-1X3; 1X03
LED7, LED8: LEDCHIP-LED0603; CHIP-LED0603
R1: 1M; R0402
R37, R59: 330; R0402
R57, R58: 5k; R0402
R60: 10k; R0402
U$8, U$10: BSS138; SOT23-3
U$20: BLE113; BLUEGIGA
U$22: RIBBON_10POS_MALE
U$25: MLP3115A2
U$32: MMA8653FC; 10-DFN2X2

Connections:
ALERT: U$20.19 (P1_5); also elsewhere on the board
CARD2: U$20.32 (P0_1)
CD: U$20.33 (P0_0)
CLK: U$20.28 (P0_5)
GND: C28.2, C29.2, C30.2, C31.2, C32.2, C33.2, C38.2, C39.2, C40.2, C41.1, C42.1, C43.2, JP4.2, JP5.1, R37.1, R59.1, R60.2, U$20.1 (GND1), U$20.2 (GND2), U$20.3 (GND3), U$20.4 (GND4), U$20.5 (GND5), U$20.6 (GND6), U$20.7 (GND7), U$20.18 (GND8), U$20.25 (GND9), U$20.36 (GND10), U$22.1 (1A), U$25.3 (GND), U$32.P$6 (GND), U$32.P$7 (GND), U$32.P$9 (GND); also elsewhere on the board
MISO: U$20.31 (P0_2)
MOSI: U$20.30 (P0_3)
unnamed: LED8.A, U$20.27 (P0_6)
unnamed: LED8.C, R37.2
unnamed: R1.1, U$8.1 (G), U$10.1 (G), U$20.23 (P1_1)
unnamed: JP4.1, U$10.3 (D)
unnamed: R1.2, U$8.2 (S), U$10.2 (S)
unnamed: LED7.A, U$20.26 (P0_7)
unnamed: JP1.2, R60.1, U$20.12 (P1_7)
unnamed: LED7.C, R59.2
unnamed: U$20.34 (RESET#), U$22.7 (7A)
unnamed: C41.2, U$25.2 (CAP)
unnamed: C40.1, U$32.P$4 (BYP)
P2_1: U$20.10 (P2_1), U$22.4 (4A)
P2_2: U$20.9 (P2_2), U$22.3 (3A)
REGOUT: C28.1, C29.1, C30.1, C31.1, C32.1, C33.1, C38.1, C39.1, C42.2, C43.1, JP1.1, R57.2, R58.2, U$8.3 (D), U$20.8 (AVDD), U$20.17 (DVDD), U$22.2 (2A), U$25.1 (VDD), U$25.4 (VDDIO), U$32.P$1 (VDD), U$32.P$8 (VDDIO); also elsewhere on the board
SCL: JP5.2, R57.1, U$20.14 (SCL), U$25.8 (SCL), U$32.P$2 (SCL); also elsewhere on the board
SDA: JP5.3, R58.1, U$20.15 (SDA), U$25.7 (SDA), U$32.P$10 (SDA); also elsewhere on the board

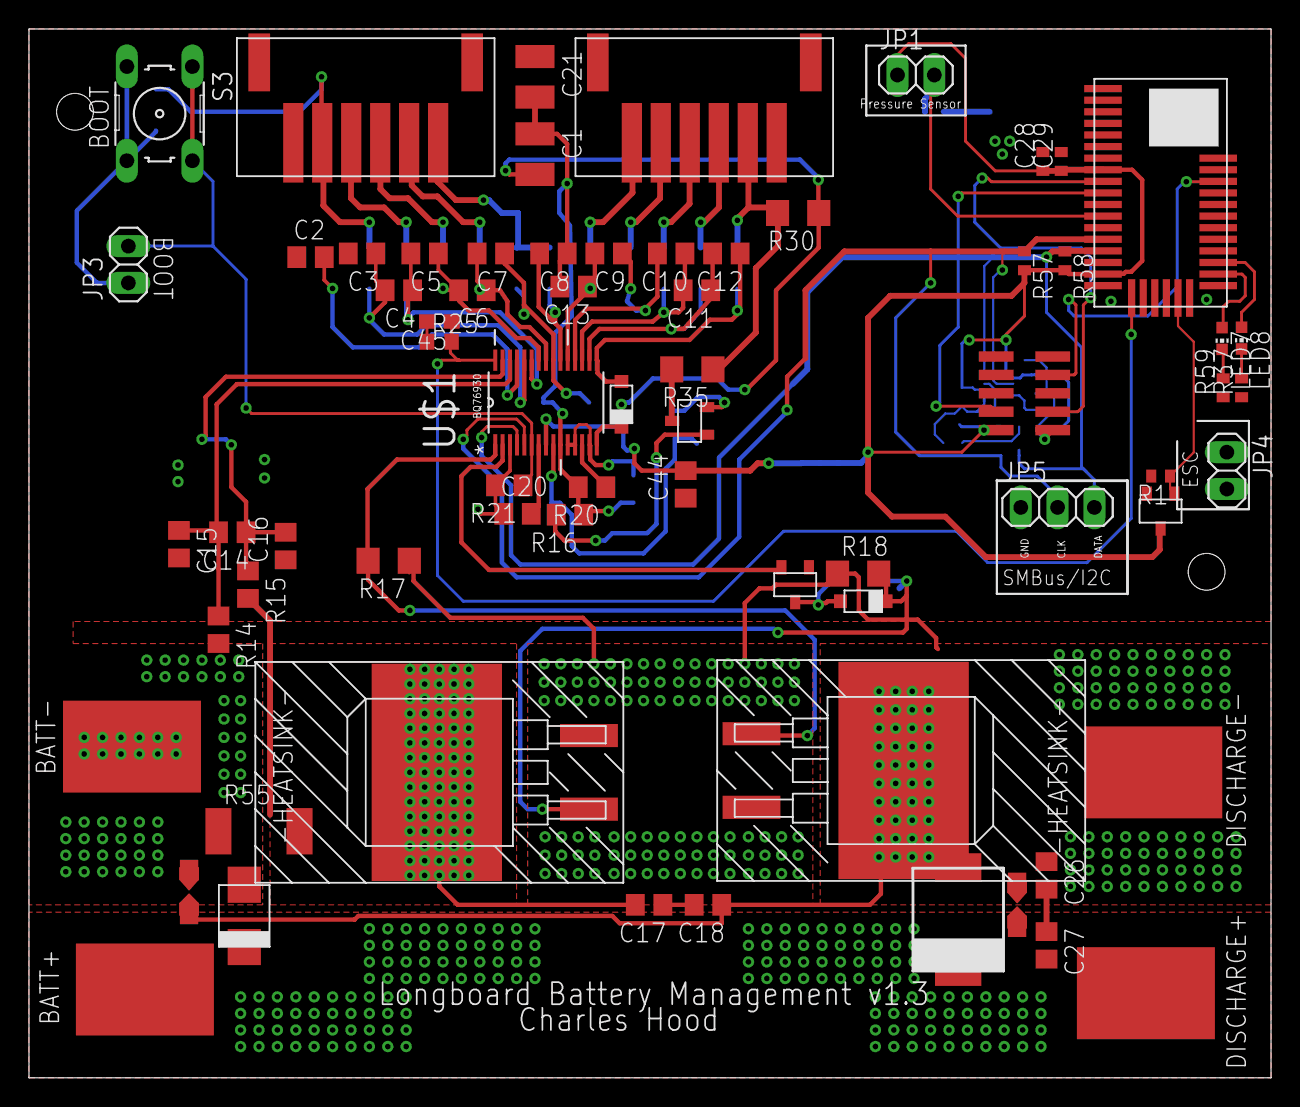
[picture p17: board AFE_Only_ReplacedDischarge.brd from above]

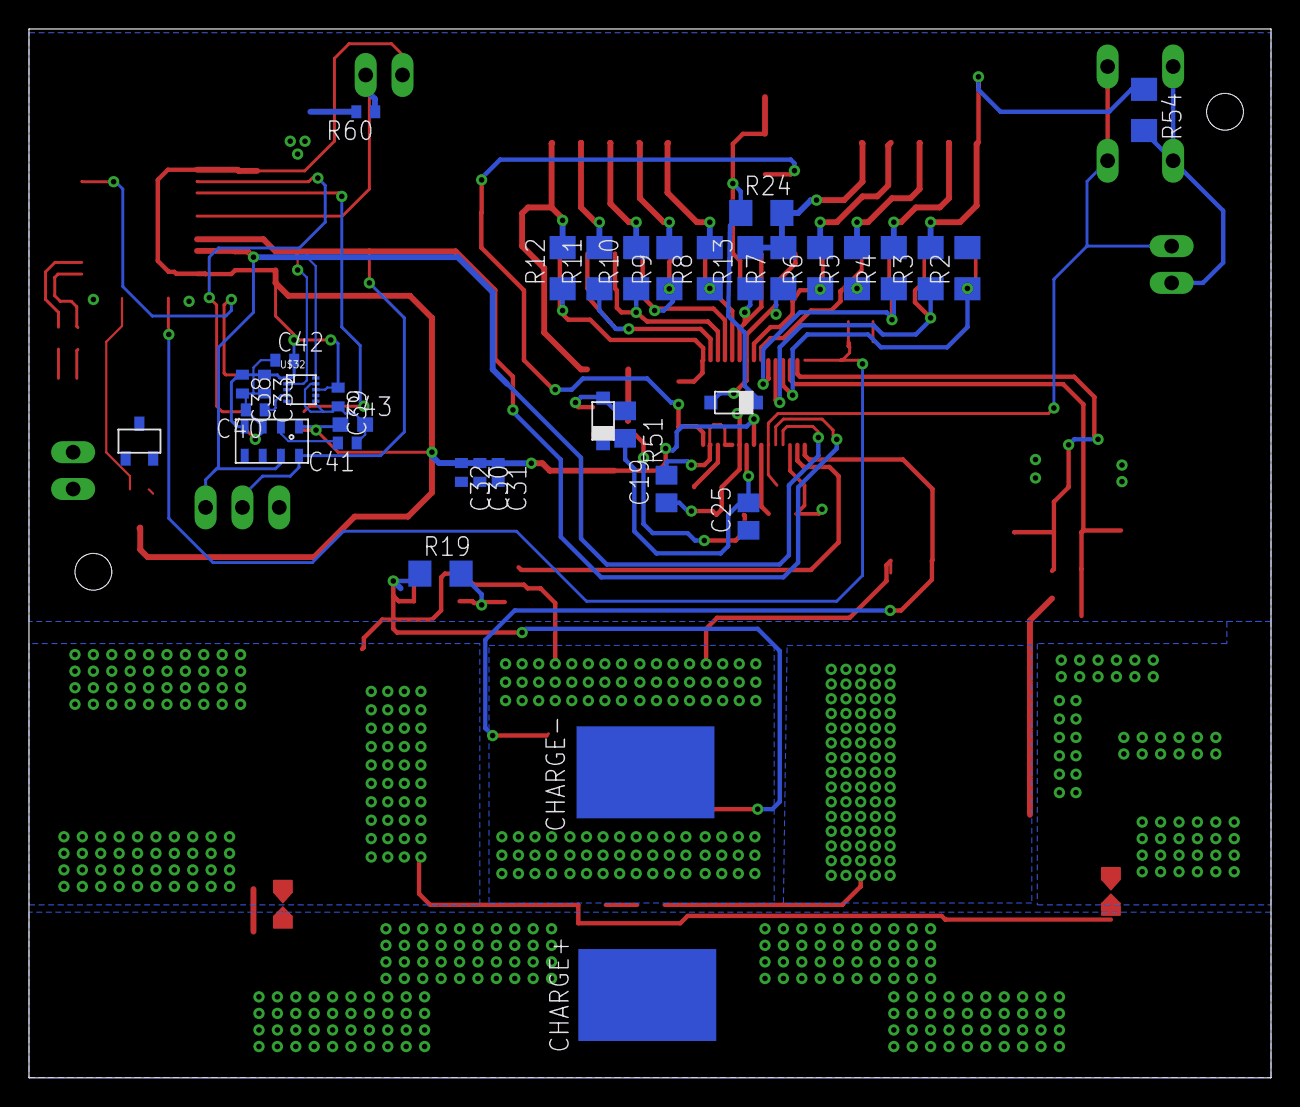
[picture p18: board AFE_Only_ReplacedDischarge.brd from below]

Board: 2 copper layers, 85.7 x 72.4 mm, 105 parts (36 on the bottom side), 63 nets.
