charlesh97/electric-longboard-bms/HW/OldBoards/Breakout/Test1.brd

## EAGLE design HW/OldBoards/Breakout/Test1.brd (2022-02-06, an earlier design)

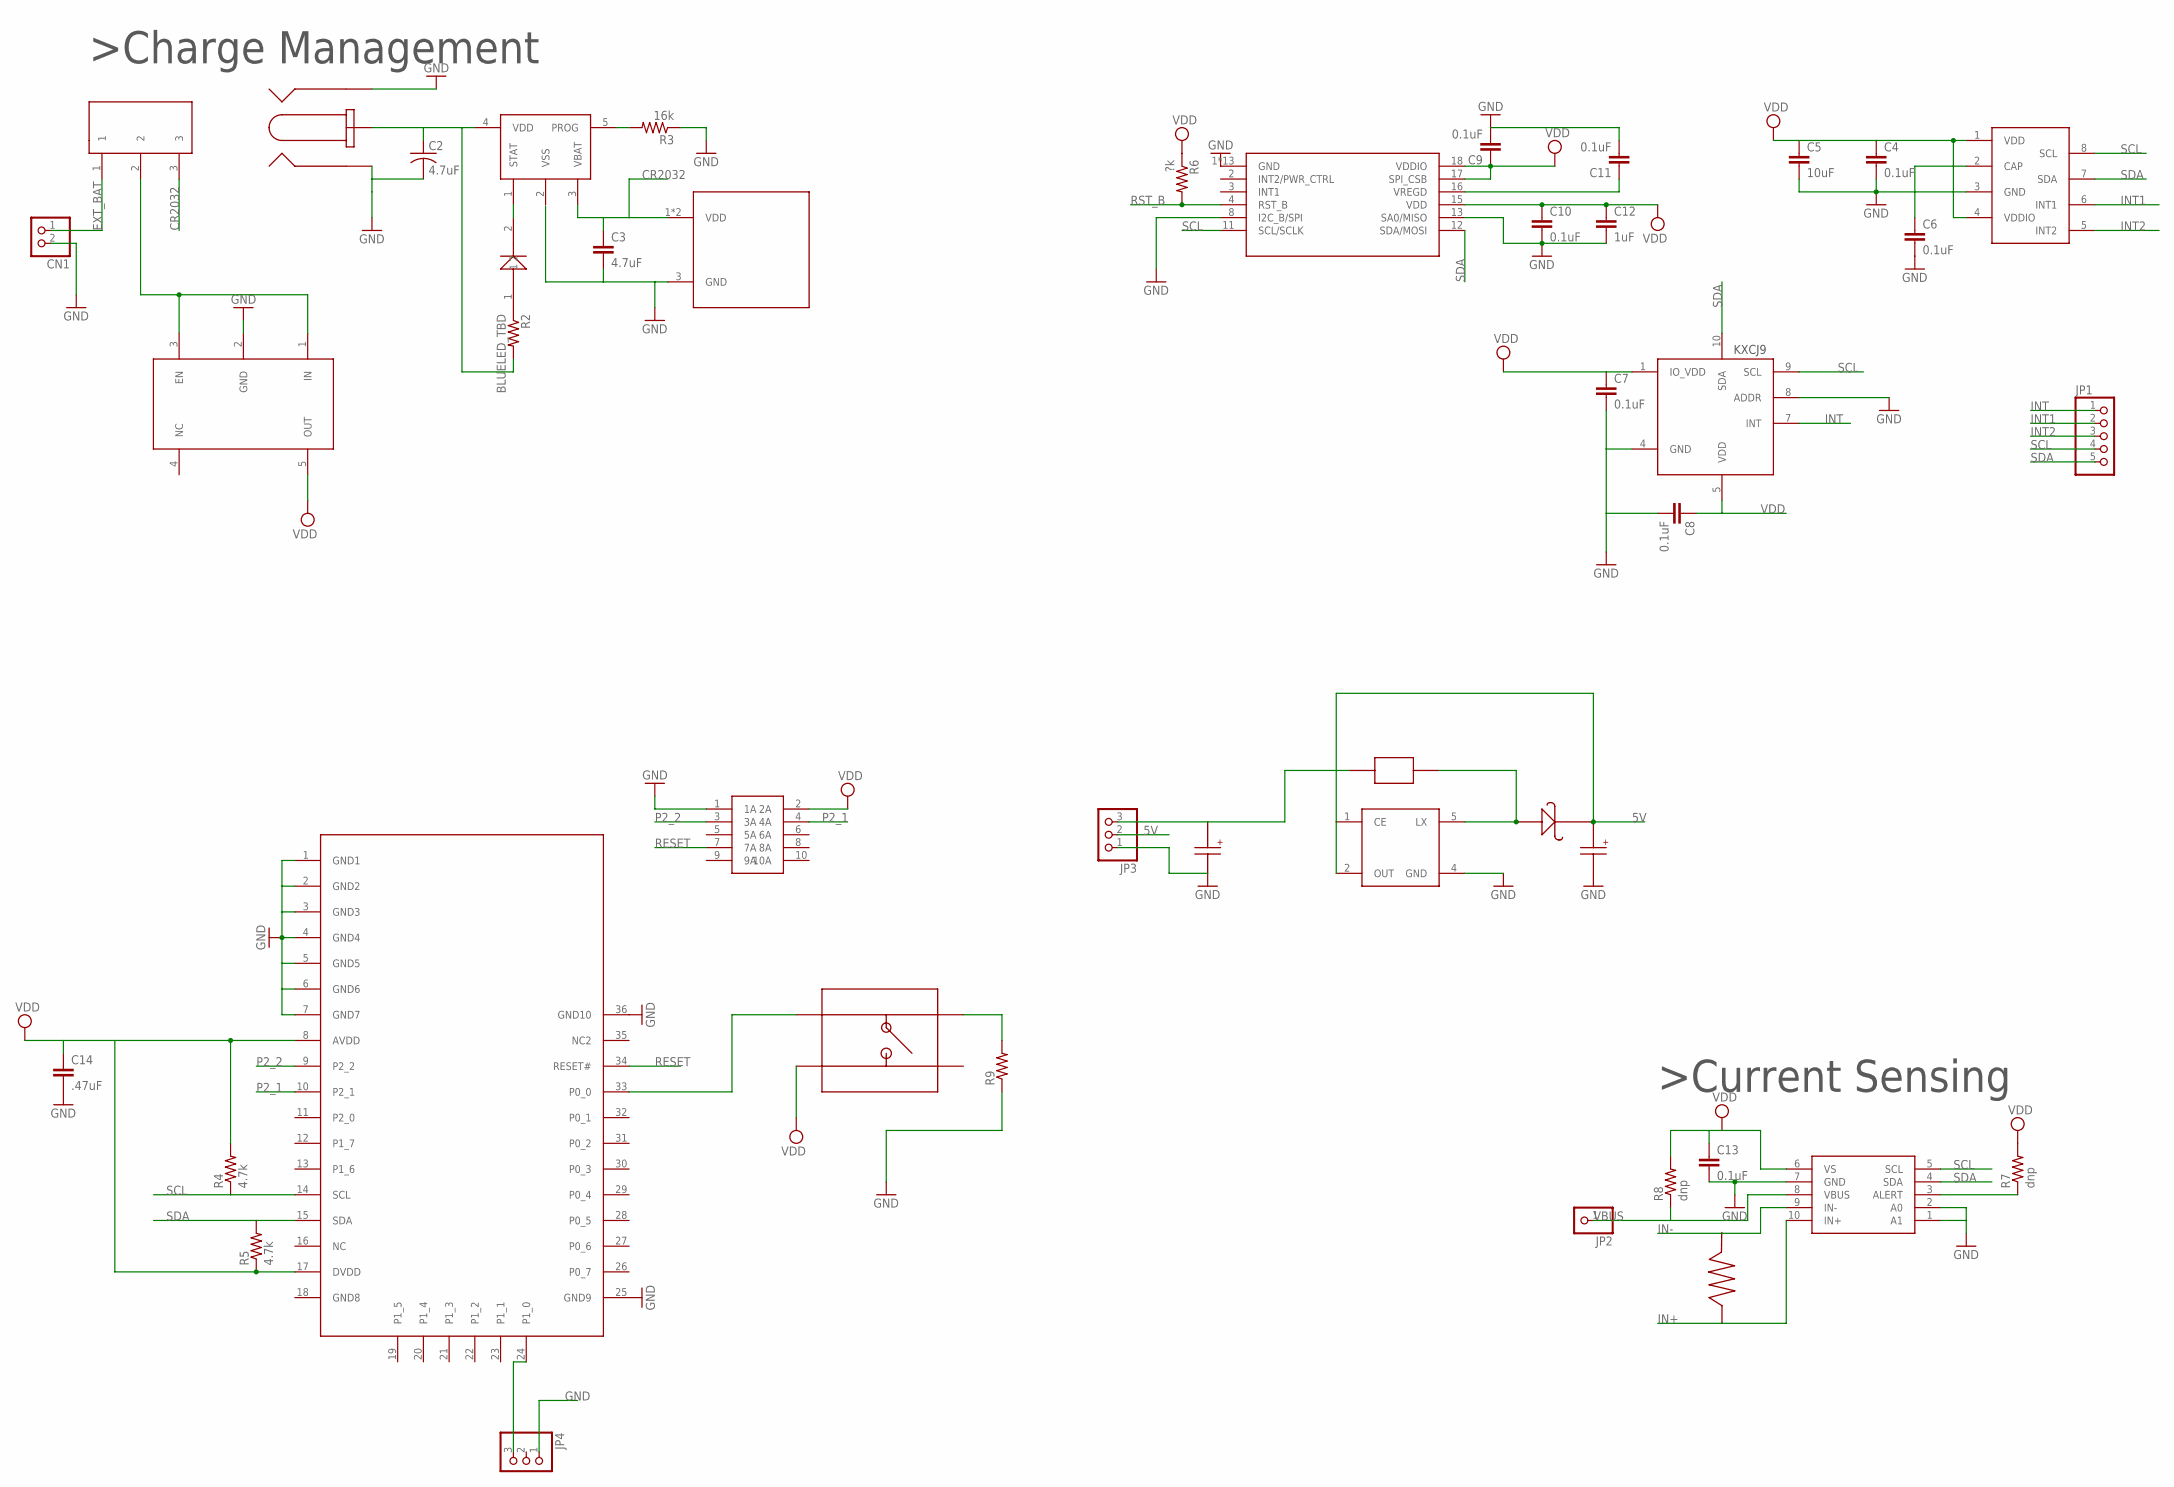
[picture p19: schematic Test1.sch]

Parts:
C2: 4.7uF; C0603
C3: 4.7uF; C0402
C4, C6, C7, C8, C9, C10, C11, C13: 0.1uF; C0402
C5: 10uF; C0402
C12: 1uF; C0402
C14: .47uF; C0402
CN1: JST_2PIN-THM; JST-PH-2-THM
JP1: PINHD-1X5; 1X05
JP2: PINHD-1X1; 1X01
JP3: PINHD-1X3; 1X03
JP4: PINHD-1X3/90; 1X03/90
R2: BLUELED_TBD; R0402
R3: 16k; R0402
R4, R5: 4.7k; R0402
R6: ?k; R0402
R7, R8: dnp; R0402
R9: R-US_R0402; R0402
U$1: BAT-HLD-001
U$2: INA226
U$3: FXAS21002
U$4: PJ-040
U$5: PTS840
U$6: CD54NP-470LC
U$7: MRB0520LT1G; SOD-323F
U$8: MIC5203; SOT23-5L
U$9: MLP3115A2
U$10: RIBBON_10POS_MALE
U$11: BLE113; BLUEGIGA
U$12: SPDT_THRU
U$13: KXCJ9
U$14: LTST-C190KRKT
U$15: ERJ-MS6SFM50U
U$16: MCP73831
U$17: NCP1402; SOT23-5L
U$18: 10uF; C2413
U$19: 68uF; C2413

Connections:
5V: JP3.2, U$7.2, U$17.1 (CE), U$17.2 (OUT), U$19.1
CR2032: C3.1, U$1.1 (VDD), U$1.2 (VDD), U$12.3, U$16.3 (VBAT)
EXT_BAT: CN1.1 (2), U$12.1
GND: C2.2, C3.2, C4.2, C5.2, C6.2, C7.2, C8.2, C9.2, C10.2, C11.2, C12.2, C13.2, C14.2, CN1.2 (1), JP3.1, JP4.1, R3.1, R9.1, U$1.3 (GND), U$2.1 (A1), U$2.2 (A0), U$2.7 (GND), U$3.1 (GND), U$3.5 (GND), U$3.6 (GND), U$3.7 (GND), U$3.8 (I2C_B/SPI), U$3.9 (GND), U$3.10 (GND), U$3.13 (SA0/MISO), U$3.14 (GND), U$3.19 (GND), U$3.20 (GND), U$3.21 (GND), U$3.22 (GND), U$3.23 (GND), U$3.24 (GND), U$4.2, U$4.3, U$8.2 (GND), U$9.3 (GND), U$10.1 (1A), U$11.1 (GND1), U$11.2 (GND2), U$11.3 (GND3), U$11.4 (GND4), U$11.5 (GND5), U$11.6 (GND6), U$11.7 (GND7), U$11.25 (GND9), U$11.36 (GND10), U$13.4 (GND), U$13.8 (ADDR), U$17.4 (GND), U$18.2, U$19.2
IN+: U$2.10 (IN+), U$15.1
IN-: U$2.9 (IN-), U$15.2
INT: JP1.1, U$13.7 (INT)
INT1: JP1.2, U$9.6 (INT1)
INT2: JP1.3, U$9.5 (INT2)
unnamed: JP4.3, U$11.24 (P1_0)
unnamed: C2.1, R2.2, U$4.1, U$16.4 (VDD)
unnamed: U$14.2, U$16.1 (STAT)
unnamed: R2.1, U$14.1
unnamed: R3.2, U$16.5 (PROG)
unnamed: C6.1, U$9.2 (CAP)
unnamed: C11.1, U$3.16 (VREGD)
unnamed: U$8.1 (IN), U$8.3 (EN), U$12.2
unnamed: U$5.4, U$11.33 (P0_0)
unnamed: R9.2, U$5.3
unnamed: R7.1, U$2.3 (ALERT)
unnamed: JP3.3, U$6.1, U$18.1
unnamed: U$6.2, U$7.1, U$17.5 (LX)
P2_1: U$10.4 (4A), U$11.10 (P2_1)
P2_2: U$10.3 (3A), U$11.9 (P2_2)
RESET: U$10.7 (7A), U$11.34 (RESET#)
RST_B: R6.2, U$3.4 (RST_B)
SCL: JP1.4, R4.1, U$2.5 (SCL), U$3.11 (SCL/SCLK), U$9.8 (SCL), U$11.14 (SCL), U$13.9 (SCL)
SDA: JP1.5, R5.2, U$2.4 (SDA), U$3.12 (SDA/MOSI), U$9.7 (SDA), U$11.15 (SDA), U$13.10 (SDA)
VBUS: JP2.1, R8.1, U$2.8 (VBUS)
VDD: C4.1, C5.1, C7.1, C8.1, C9.1, C10.1, C12.1, C13.1, C14.1, R4.2, R5.1, R6.1, R7.2, R8.2, U$2.6 (VS), U$3.15 (VDD), U$3.17 (SPI_CSB), U$3.18 (VDDIO), U$5.2, U$8.5 (OUT), U$9.1 (VDD), U$9.4 (VDDIO), U$10.2 (2A), U$11.8 (AVDD), U$11.17 (DVDD), U$13.1 (IO_VDD), U$13.5 (VDD)

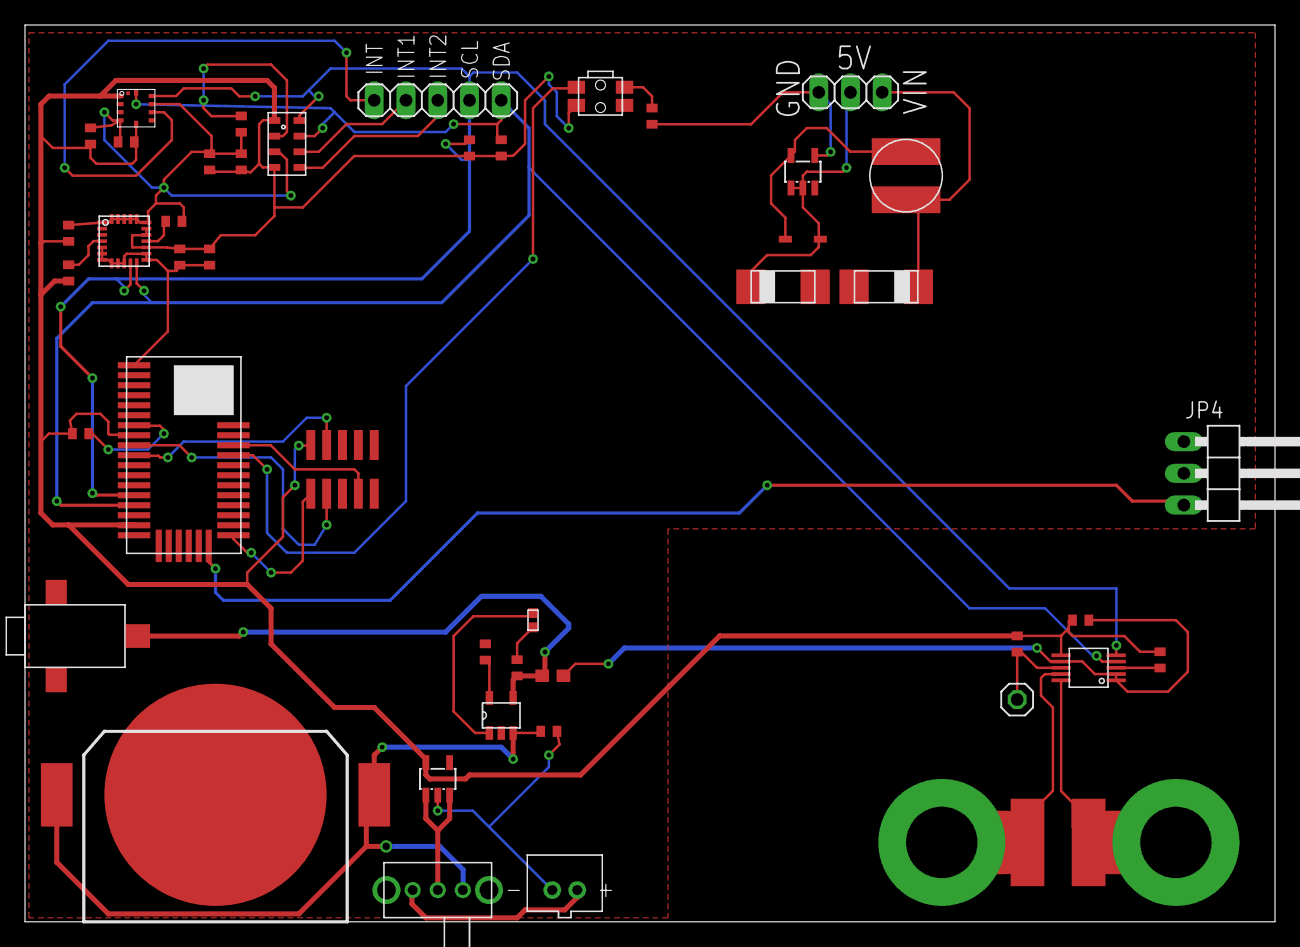
[picture p20: board Test1.brd from above]

Board: 2 copper layers, 100.0 x 71.7 mm, 45 parts (0 on the bottom side), 30 nets.
