charlesh97/electric-longboard-bms/HW/OldBoards/SensorBoard/Sensor.brd

## EAGLE design HW/OldBoards/SensorBoard/Sensor.brd (2022-02-06, an earlier design)

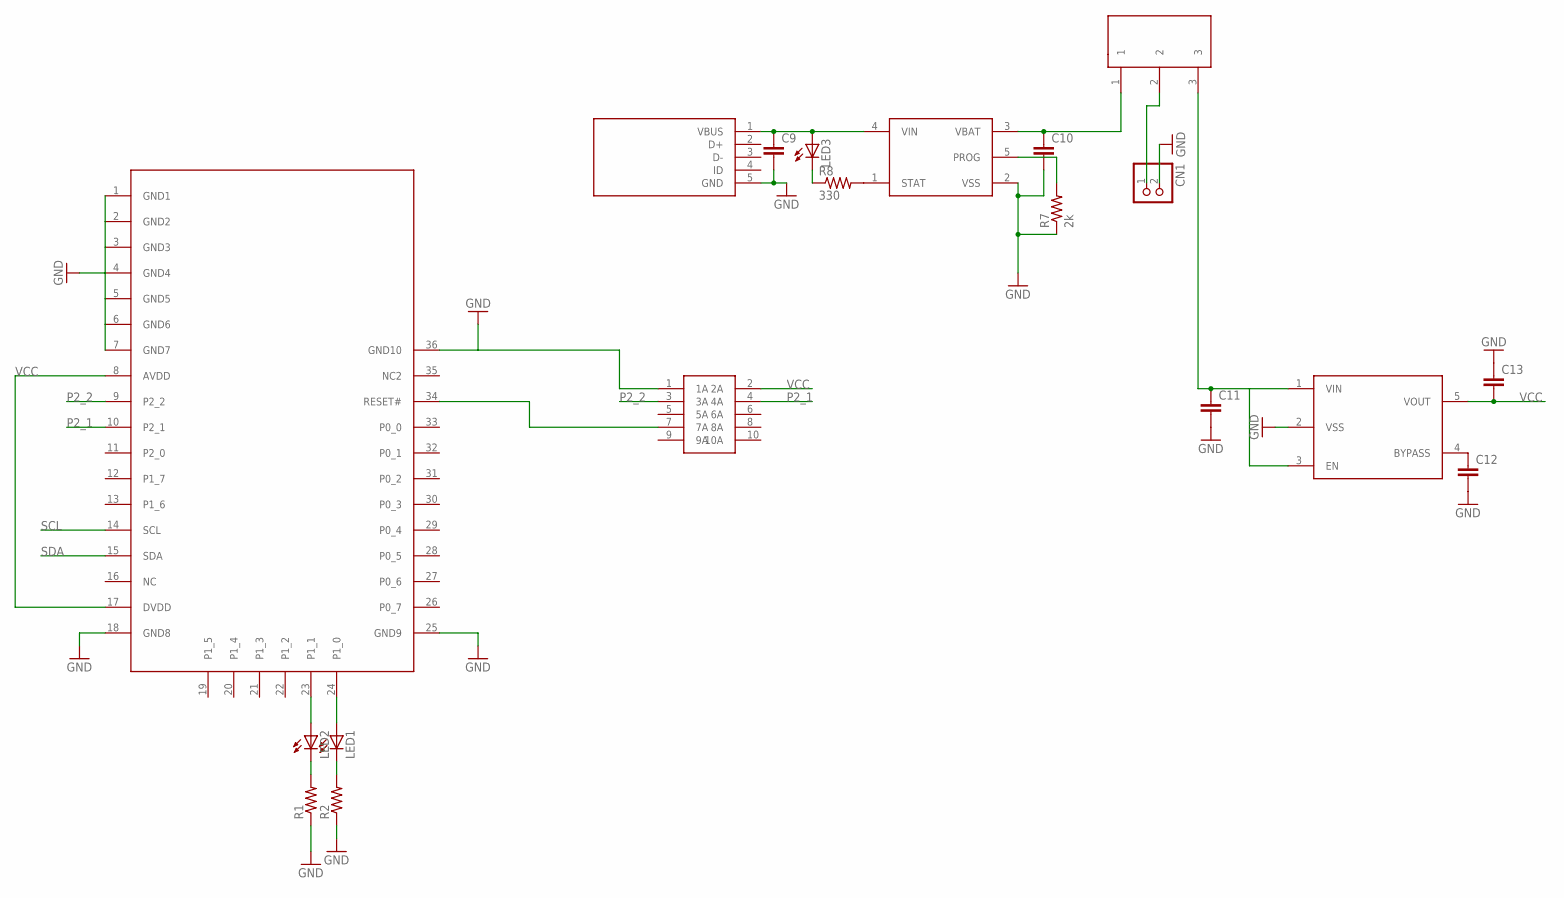
[picture p21: schematic Sensor.sch, sheet 1]

Parts:
C9, C10, C11, C12, C13: C-EUC0402; C0402
CN1: JST_2PIN-THM; JST-PH-2-THM
LED1, LED2, LED3: LEDCHIP-LED0805; CHIP-LED0805
R1, R2: R-US_R0402; R0402
R7: 2k; R0402
R8: 330; R0402
U$1: BLE113; BLUEGIGA
U$2: MCP73831; SOT23-5L
U$8: RIBBON_10POS_MALE
U$9: SPDT_THRU
U$10: USB_MINI
U$11: LP3985; SOT23-5L

Connections:
GND: C9.2, C10.2, C11.2, C12.2, C13.1, CN1.2 (1), R1.1, R2.1, R7.1, U$1.1 (GND1), U$1.2 (GND2), U$1.3 (GND3), U$1.4 (GND4), U$1.5 (GND5), U$1.6 (GND6), U$1.7 (GND7), U$1.18 (GND8), U$1.25 (GND9), U$1.36 (GND10), U$2.2 (VSS), U$8.1 (1A), U$10.5 (GND), U$11.2 (VSS); also elsewhere on the board
unnamed: C9.1, LED3.A, U$2.4 (VIN), U$10.1 (VBUS)
unnamed: C10.1, U$2.3 (VBAT), U$9.1
unnamed: C11.1, U$9.3, U$11.1 (VIN), U$11.3 (EN)
unnamed: U$1.34 (RESET#), U$8.7 (7A)
unnamed: LED2.C, R1.2
unnamed: LED1.C, R2.2
unnamed: LED1.A, U$1.24 (P1_0)
unnamed: LED2.A, U$1.23 (P1_1)
unnamed: CN1.1 (2), U$9.2
unnamed: R7.2, U$2.5 (PROG)
unnamed: C12.1, U$11.4 (BYPASS)
unnamed: R8.2, U$2.1 (STAT)
unnamed: LED3.C, R8.1
P2_1: U$1.10 (P2_1), U$8.4 (4A)
P2_2: U$1.9 (P2_2), U$8.3 (3A)
SCL: U$1.14 (SCL); also elsewhere on the board
SDA: U$1.15 (SDA); also elsewhere on the board
VCC: C13.2, U$1.8 (AVDD), U$1.17 (DVDD), U$8.2 (2A), U$11.5 (VOUT); also elsewhere on the board

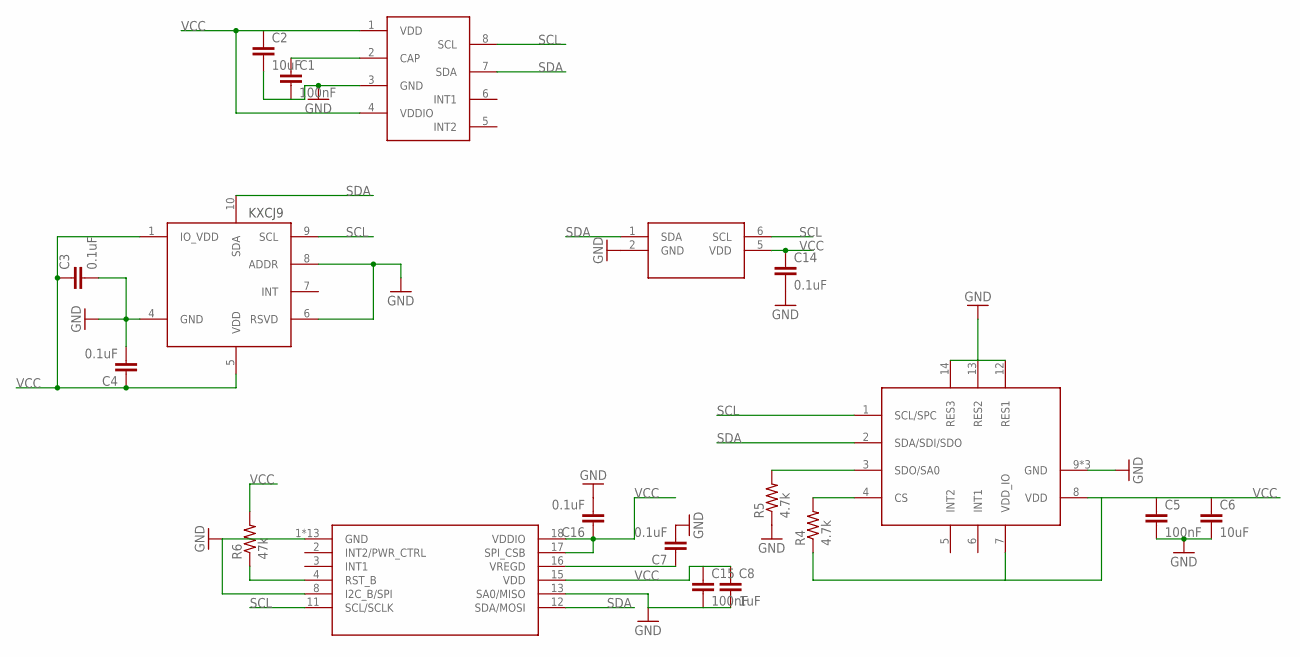
[picture p22: schematic Sensor.sch, sheet 2]

Parts:
ACCEL_16: LISDH_16G; LGA14_2X2
C1, C5, C15: 100nF; C0402
C2, C6: 10uF; C0402
C3, C4, C7, C14, C16: 0.1uF; C0402
C8: 1uF; C0402
R4, R5: 4.7k; R0402
R6: 47k; R0402
U$12: KXCJ9
U$13: MLP3115A2
U$14: FXAS21002
U$15: SI7021-A20

Connections:
GND: ACCEL_16.9 (GND), ACCEL_16.10 (GND), ACCEL_16.11 (GND), ACCEL_16.12 (RES1), ACCEL_16.13 (RES2), ACCEL_16.14 (RES3), C1.2, C2.2, C3.2, C4.2, C5.2, C6.2, C7.2, C8.2, C14.2, C15.2, C16.2, R5.1, U$12.4 (GND), U$12.6 (RSVD), U$12.8 (ADDR), U$13.3 (GND), U$14.1 (GND), U$14.5 (GND), U$14.6 (GND), U$14.7 (GND), U$14.8 (I2C_B/SPI), U$14.9 (GND), U$14.10 (GND), U$14.13 (SA0/MISO), U$14.14 (GND), U$14.19 (GND), U$14.20 (GND), U$14.21 (GND), U$14.22 (GND), U$14.23 (GND), U$14.24 (GND), U$15.2 (GND); also elsewhere on the board
unnamed: C1.1, U$13.2 (CAP)
unnamed: ACCEL_16.4 (CS), R4.2
unnamed: ACCEL_16.3 (SDO/SA0), R5.2
unnamed: R6.1, U$14.4 (RST_B)
unnamed: C7.1, U$14.16 (VREGD)
SCL: ACCEL_16.1 (SCL/SPC), U$12.9 (SCL), U$13.8 (SCL), U$14.11 (SCL/SCLK), U$15.6 (SCL); also elsewhere on the board
SDA: ACCEL_16.2 (SDA/SDI/SDO), U$12.10 (SDA), U$13.7 (SDA), U$14.12 (SDA/MOSI), U$15.1 (SDA); also elsewhere on the board
VCC: ACCEL_16.7 (VDD_IO), ACCEL_16.8 (VDD), C2.1, C3.1, C4.1, C5.1, C6.1, C8.1, C14.1, C15.1, C16.1, R4.1, R6.2, U$12.1 (IO_VDD), U$12.5 (VDD), U$13.1 (VDD), U$13.4 (VDDIO), U$14.15 (VDD), U$14.17 (SPI_CSB), U$14.18 (VDDIO), U$15.5 (VDD); also elsewhere on the board

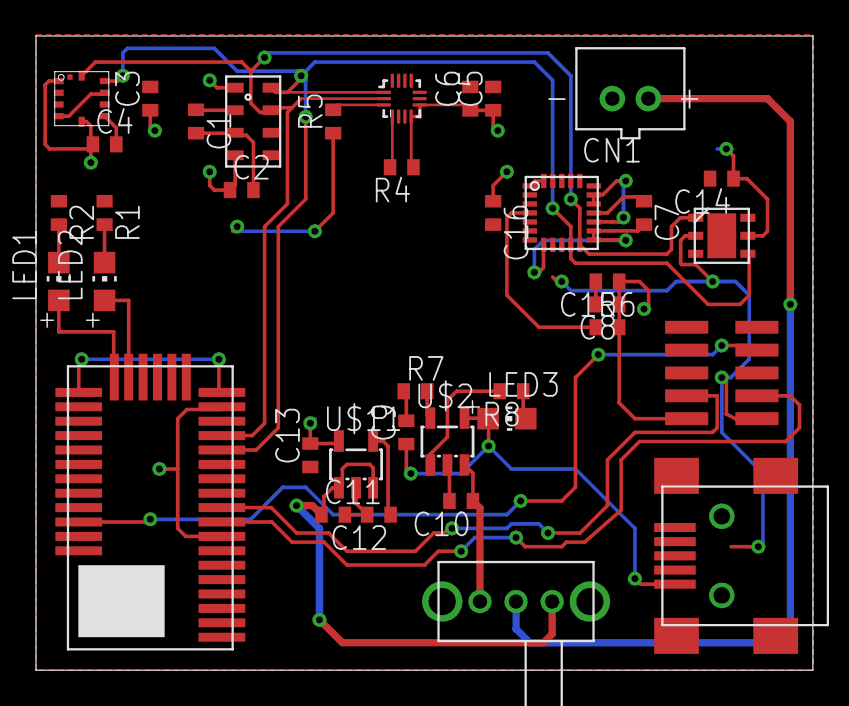
[picture p23: board Sensor.brd from above]

Board: 2 copper layers, 43.2 x 35.2 mm, 38 parts (0 on the bottom side), 24 nets.
