charlesh97/electric-longboard-bms/HW/Optoisolator/Isolator.brd

## EAGLE design HW/Optoisolator/Isolator.brd (2022-02-06)

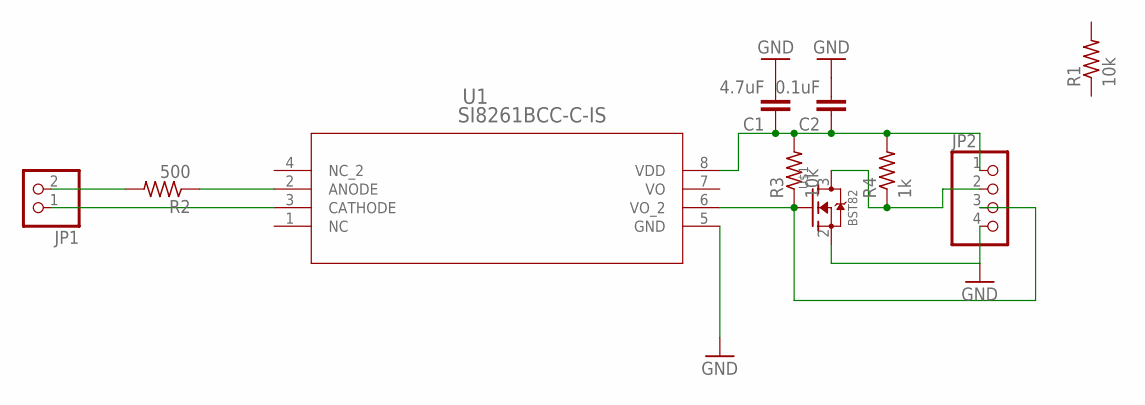
[picture p24: schematic Isolator.sch]

Parts:
C1: 4.7uF; C0402
C2: 0.1uF; C0402
JP1: PINHD-1X2; 1X02
JP2: PINHD-1X4; 1X04
R1, R3: 10k; R0402
R2: 500; R0402
R4: 1k; R0402
U1: SI8261BCC-C-IS; SOIC_8_127MM
U$1: BST82; SOT23-3

Connections:
GND: C1.2, C2.2, JP2.4, U1.5 (GND), U$1.2 (S)
unnamed: C1.1, C2.1, JP2.1, R3.2, R4.2, U1.8 (VDD)
unnamed: JP2.3, R3.1, U1.6 (VO_2), U$1.1 (G)
unnamed: JP1.2, R2.2
unnamed: JP2.2, R4.1, U$1.3 (D)
unnamed: R2.1, U1.2 (ANODE)
unnamed: JP1.1, U1.3 (CATHODE)

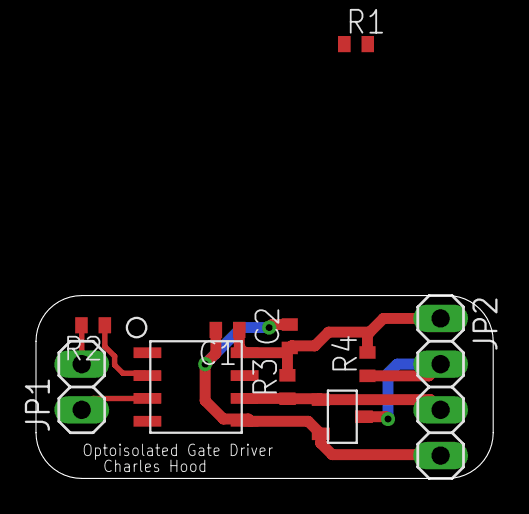
[picture p25: board Isolator.brd from above]

Board: 2 copper layers, 25.4 x 10.2 mm, 10 parts (0 on the bottom side), 7 nets.
