charlesh97/electric-longboard-bms/HW/Longboard w: Gauge/v2/Longboard.brd

## EAGLE design HW/Longboard w: Gauge/v2/Longboard.brd (2022-02-06)

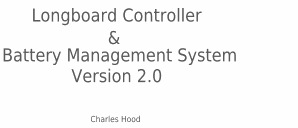
[picture p26: schematic Longboard.sch, sheet 1]

Notes on the sheet:
Longboard Controller
Battery Management System
Version 2.0
Charles Hood
