charlesh97/electric-longboard-bms/HW/Longboard w: Gauge/v2/Longboard.brd

## EAGLE design HW/Longboard w: Gauge/v2/Longboard.brd (continued)

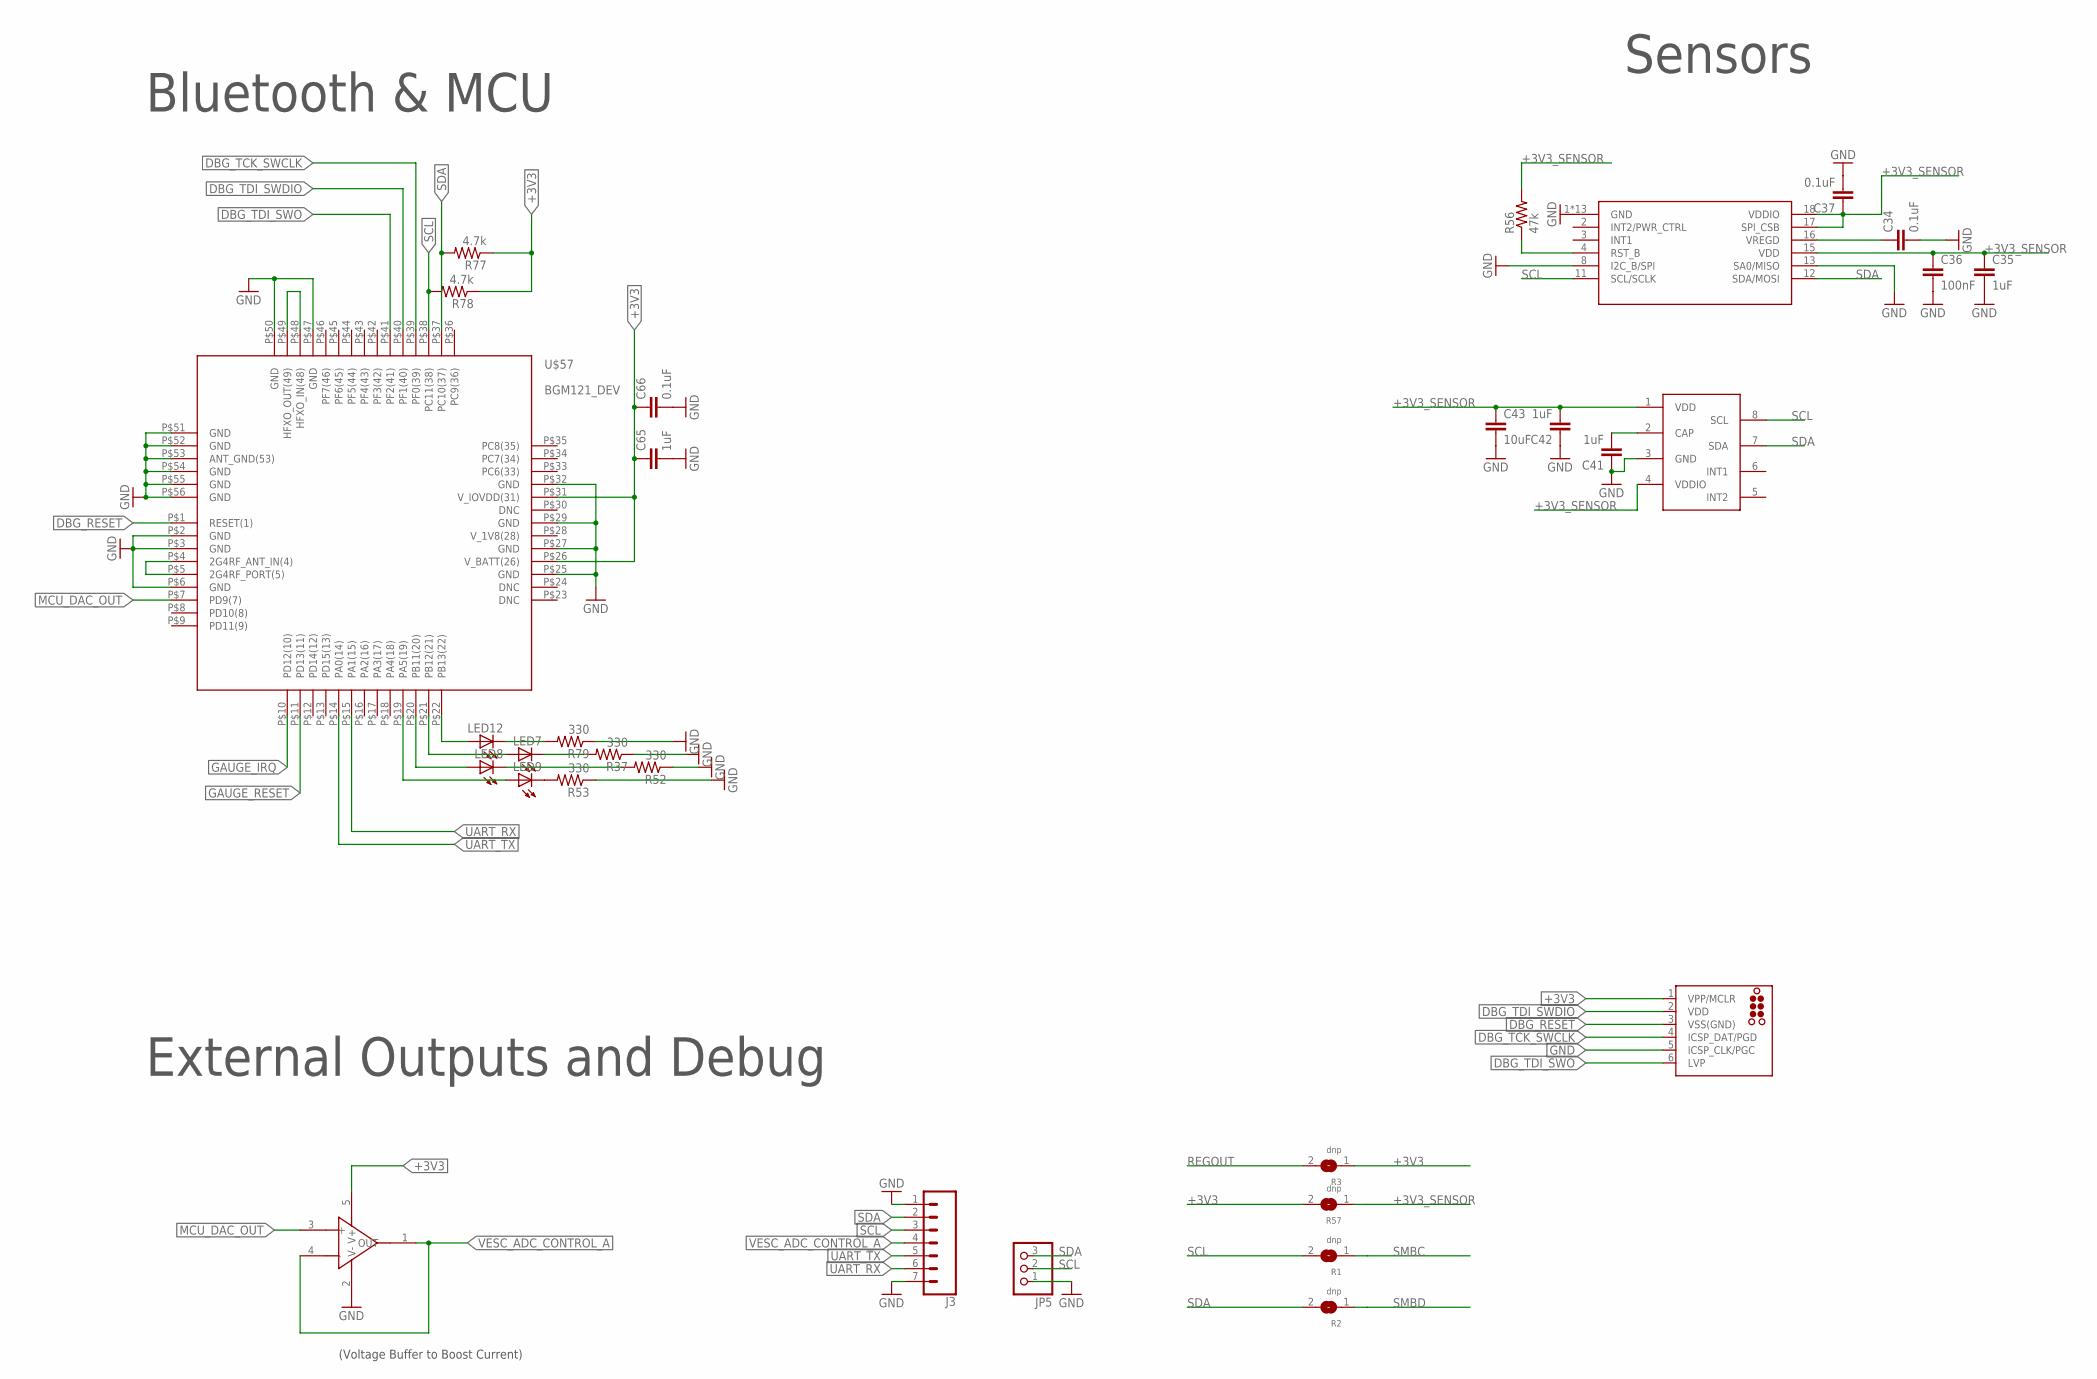
[picture p27: schematic Longboard.sch, sheet 2]

Parts:
C34, C37, C66: 0.1uF; C0402
C35, C41, C42, C65: 1uF; C0402
C36: 100nF; C0402
C43: 10uF; C0603
J2: TC2030-MCP-NL
J3: CONN_07; 1X07
JP5: PINHD-1X3; 1X03
LED7, LED8, LED9, LED12: LEDCHIP-LED0603; CHIP-LED0603
R1, R2, R3, R57: dnp; SOLDERJUMPER_ARROW_NOPASTE
R37, R52, R53, R79: 330; R0402
R56: 47k; R0402
R77, R78: 4.7k; R0402
U$5: MCP6001; SOT23-5L
U$25: MLP3115A2
U$34: FXAS21002
U$57: BGM121_DEV; BGM121_PAC

Connections:
+3V3: C65.1, C66.1, J2.1 (VPP/MCLR), R3.1, R57.2, R77.1, R78.1, U$5.5 (V+), U$57.P$26 (V_BATT(26)), U$57.P$31 (V_IOVDD(31))
+3V3_SENSOR: C35.1, C36.1, C37.1, C42.2, C43.1, R56.2, R57.1, U$25.1 (VDD), U$25.4 (VDDIO), U$34.15 (VDD), U$34.17 (SPI_CSB), U$34.18 (VDDIO)
DBG_RESET: J2.3 (VSS(GND)), U$57.P$1 (RESET(1))
DBG_TCK_SWCLK: J2.4 (ICSP_DAT/PGD), U$57.P$39 (PF0(39))
DBG_TDI_SWDIO: J2.2 (VDD), U$57.P$40 (PF1(40))
DBG_TDI_SWO: J2.6 (LVP), U$57.P$41 (PF2(41))
GAUGE_IRQ: U$57.P$10 (PD12(10)); also elsewhere on the board
GAUGE_RESET: U$57.P$11 (PD13(11)); also elsewhere on the board
GND: C34.2, C35.2, C36.2, C37.2, C41.1, C42.1, C43.2, C65.2, C66.2, J2.5 (ICSP_CLK/PGC), J3.1, J3.7, JP5.1, R37.1, R52.1, R53.1, R79.1, U$5.2 (V-), U$25.3 (GND), U$34.1 (GND), U$34.5 (GND), U$34.6 (GND), U$34.7 (GND), U$34.9 (GND), U$34.10 (GND), U$34.13 (SA0/MISO), U$34.14 (GND), U$34.19 (GND), U$34.20 (GND), U$34.21 (GND), U$34.22 (GND), U$34.23 (GND), U$34.24 (GND), U$57.P$2 (GND), U$57.P$3 (GND), U$57.P$6 (GND), U$57.P$25 (GND), U$57.P$27 (GND), U$57.P$29 (GND), U$57.P$32 (GND), U$57.P$47 (GND), U$57.P$50 (GND), U$57.P$51 (GND), U$57.P$52 (GND), U$57.P$53 (ANT_GND(53)), U$57.P$54 (GND), U$57.P$55 (GND), U$57.P$56 (GND); also elsewhere on the board
MCU_DAC_OUT: U$5.3 (+), U$57.P$7 (PD9(7))
unnamed: LED12.A, U$57.P$22 (PB13(22))
unnamed: LED7.A, U$57.P$21 (PB12(21))
unnamed: LED8.A, U$57.P$20 (PB11(20))
unnamed: LED9.A, U$57.P$19 (PA5(19))
unnamed: R56.1, U$34.4 (RST_B)
unnamed: LED7.C, R37.2
unnamed: LED8.C, R52.2
unnamed: LED9.C, R53.2
unnamed: C34.1, U$34.16 (VREGD)
unnamed: C41.2, U$25.2 (CAP)
unnamed: U$57.P$4 (2G4RF_ANT_IN(4)), U$57.P$5 (2G4RF_PORT(5))
unnamed: LED12.C, R79.2
unnamed: U$57.P$48 (HFXO_IN(48)), U$57.P$49 (HFXO_OUT(49))
REGOUT: R3.2; also elsewhere on the board
SCL: J3.3, JP5.2, R1.2, R78.2, U$25.8 (SCL), U$34.11 (SCL/SCLK), U$57.P$38 (PC11(38))
SDA: J3.2, JP5.3, R2.2, R77.2, U$25.7 (SDA), U$34.12 (SDA/MOSI), U$57.P$37 (PC10(37))
SMBC: R1.1; also elsewhere on the board
SMBD: R2.1; also elsewhere on the board
UART_RX: J3.6, U$57.P$15 (PA1(15))
UART_TX: J3.5, U$57.P$14 (PA0(14))
VESC_ADC_CONTROL_A: J3.4, U$5.1 (OUT), U$5.4 (-)
V_1V8(28): U$57.P$28 (V_1V8(28))

Notes on the sheet:
Bluetooth & MCU
Sensors
External Outputs and Debug
(Voltage Buffer to Boost Current)

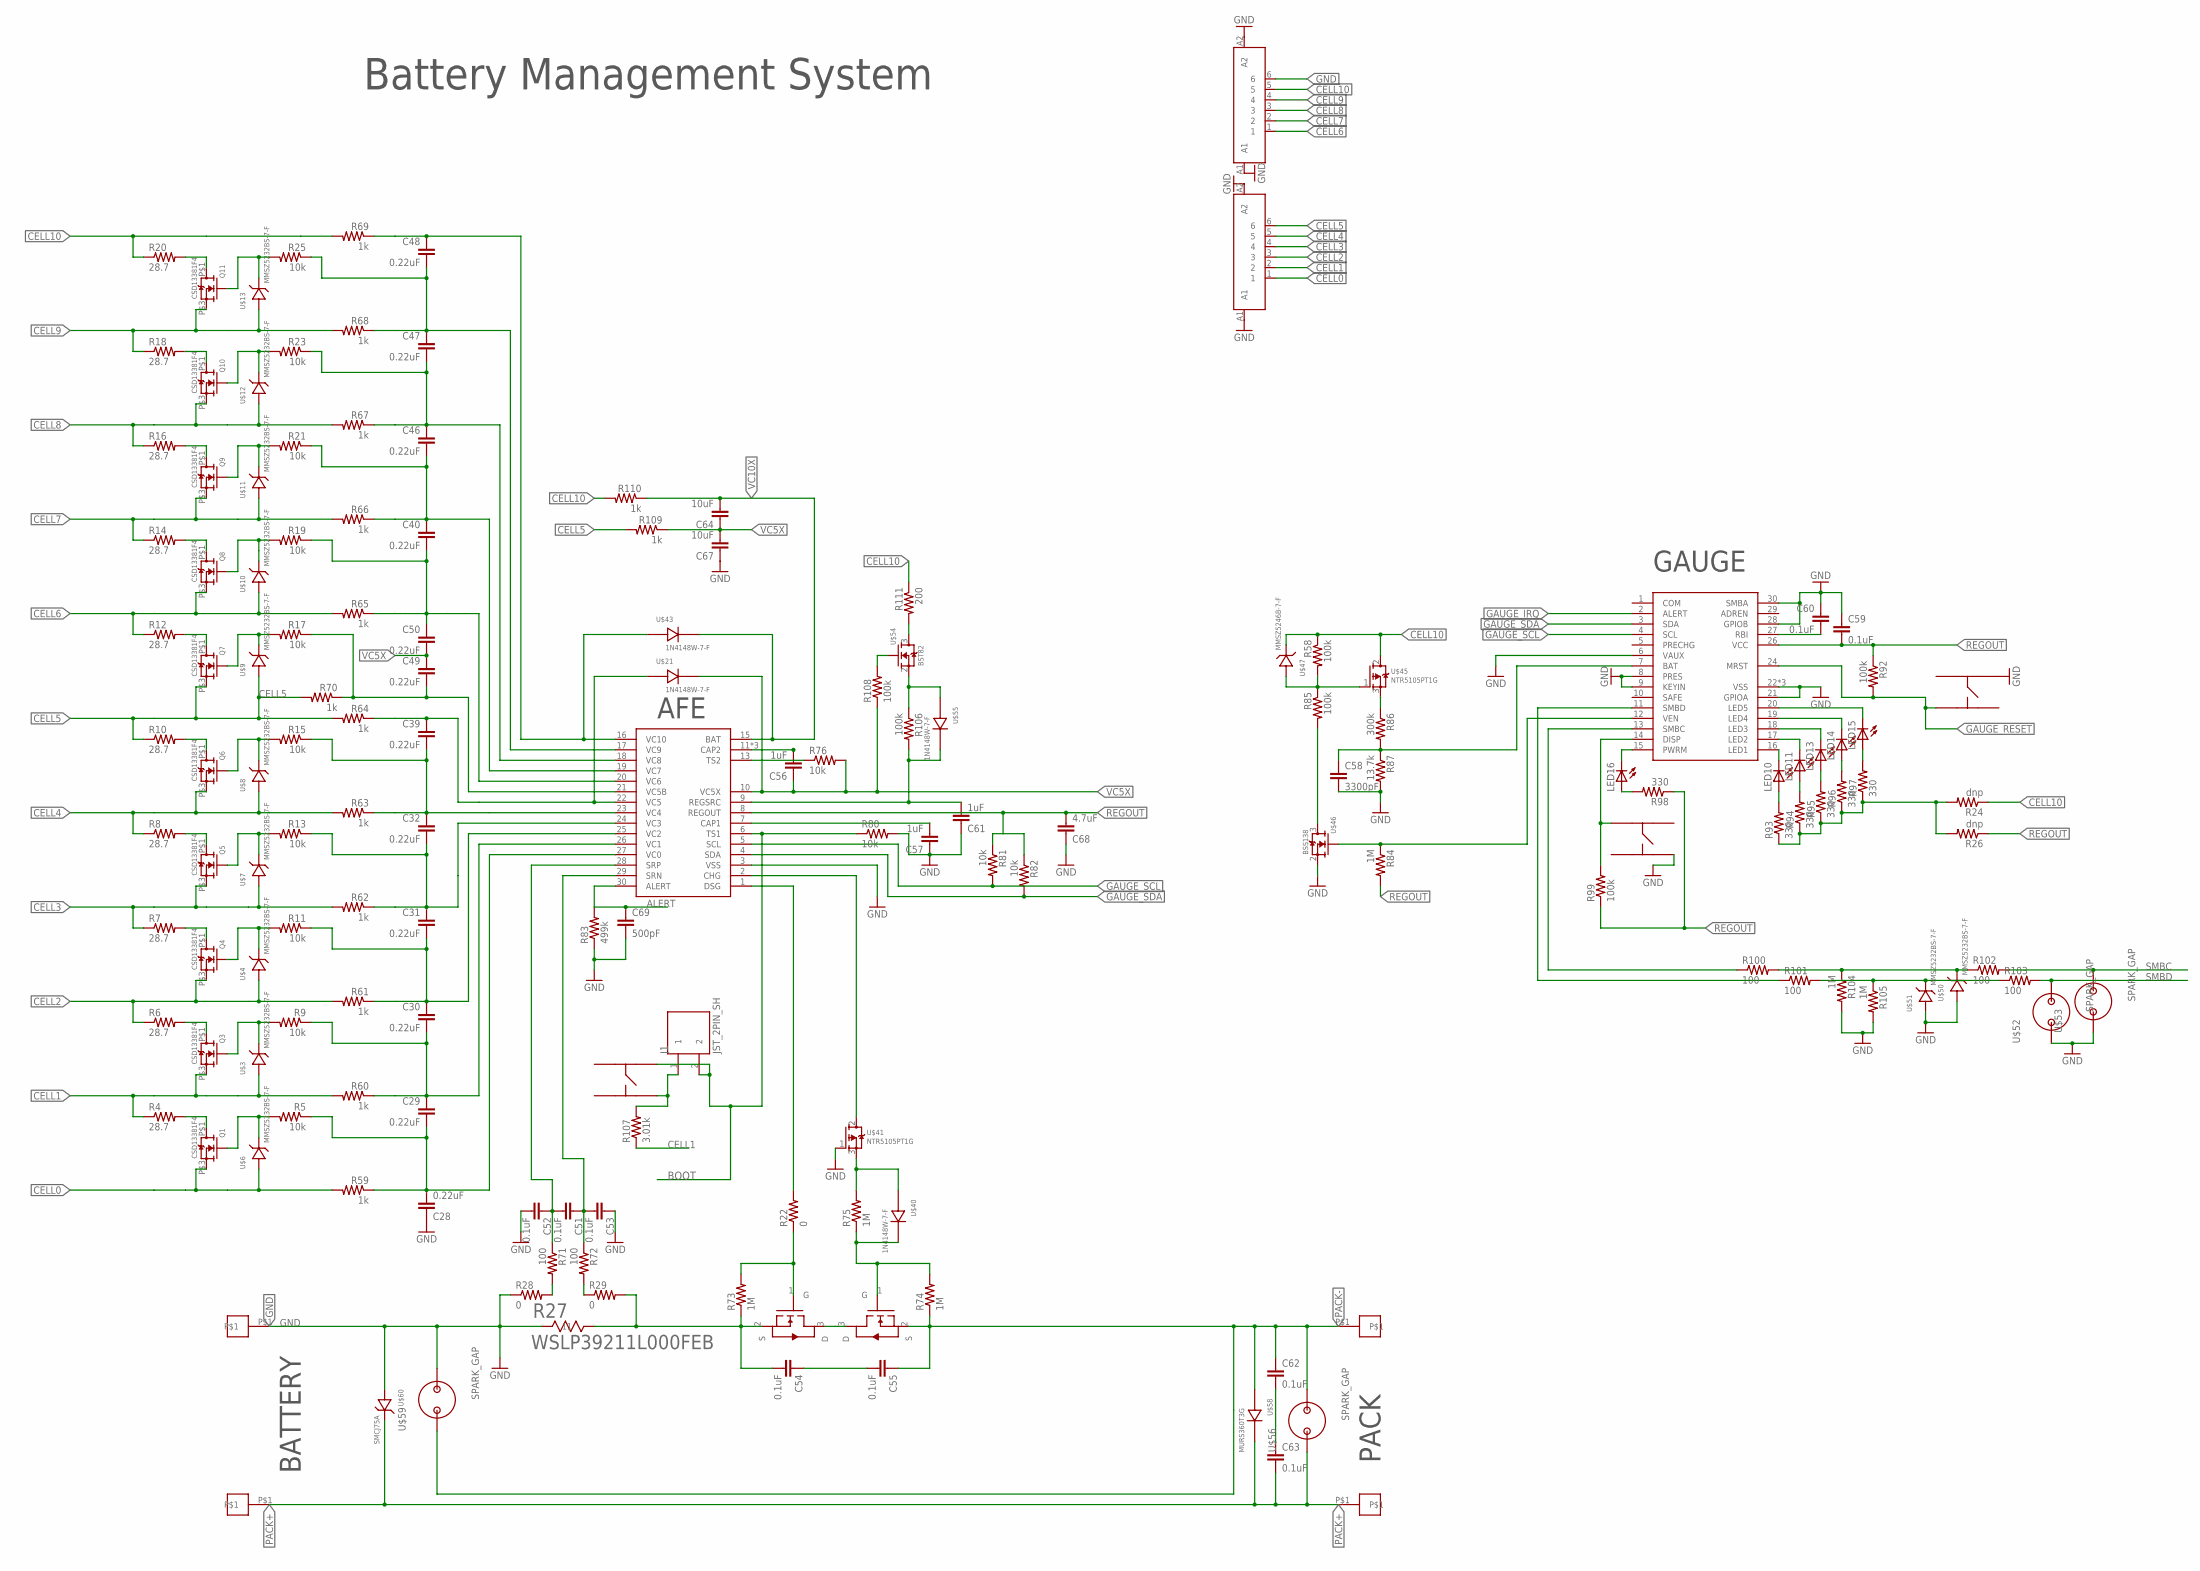
[picture p28: schematic Longboard.sch, sheet 3]

Parts:
C28, C29, C30, C31, C32, C39, C40, C46, C47, C48, C49, C50: 0.22uF; C0805
C51, C52, C53, C54, C55, C59, C60, C62, C63: 0.1uF; C0805
C56, C57, C61: 1uF; C0805
C58: 3300pF; C0402
C64, C67: 10uF; C1210
C68: 4.7uF; C0805
C69: 500pF; C0603
J1: JST_2PIN_SH
LED10, LED11, LED13, LED14, LED15, LED16: LEDCHIPLED_0603; CHIPLED_0603
Q1, Q3, Q4, Q5, Q6, Q7, Q8, Q9, Q10, Q11: CSD13381F4; 3-XFDFN
R4, R6, R7, R8, R10, R12, R14, R16, R18, R20: 28.7; R2010
R5, R9, R11, R13, R15, R17, R19, R21, R23, R25: 10k; R1206
R22: 0; R1206
R24, R26: dnp; R0402
R27: WSLP39211L000FEB; W-3921
R28, R29: 0; R0402
R58, R85, R92, R106, R108: 100k; R0805
R59, R60, R61, R62, R63, R64, R65, R66, R67, R68, R69, R70, R109, R110: 1k; R1206
R71, R72, R100, R101, R102, R103: 100; R0805
R73, R74, R75, R84, R104, R105: 1M; R1206
R76, R80, R81, R82: 10k; R0805
R83: 499k; R0603
R86: 300k; R0805
R87: 13.7k; R0805
R93, R94, R95, R96, R97, R98: 330; R0402
R99: 100k; R0402
R107: 3.01k; R1206
R111: 200; R1206
S1, S2, S3: KMR731NG
U$3, U$4, U$6, U$7, U$8, U$9, U$10, U$11, U$12, U$13, U$50, U$51: MMSZ5232BS-7-F; SOD-323F
U$14, U$15, U$16, U$17: PAD
U$18, U$19: JST_6PIN
U$20: BQ76930; SOIC-30
U$21, U$40, U$43, U$55: 1N4148W-7-F; SOD-123
U$22, U$23: AOB290L; TO-263
U$41, U$45: NTR5105PT1G; SOT23-3
U$44: BQ78350-R1; SOIC-30
U$46: BSS138; SOT23-3
U$47: MMSZ5246B-7-F; SOD-123
U$52, U$53, U$56, U$59: SPARK_GAP
U$54: BST82; SOT23-3
U$58: MURS360T3G; SMC(DO-214AB)
U$60: SMCJ75A; SMC(DO-214AB)

Connections:
ALERT: C69.1, R83.2, U$20.30 (ALERT)
BOOT: J1.2, R80.1, S1.P$2, U$20.6 (TS1)
CELL0: Q1.P$3 (S), R59.2, U$6.1, U$19.1
CELL1: Q3.P$3 (S), R4.1, R60.2, R107.1, U$3.1, U$19.2
CELL2: Q4.P$3 (S), R6.1, R61.2, U$4.1, U$19.3
CELL3: Q5.P$3 (S), R7.1, R62.2, U$7.1, U$19.4
CELL4: Q6.P$3 (S), R8.1, R63.2, U$8.1, U$19.5
CELL5: Q7.P$3 (S), R10.1, R64.2, R70.2, R109.2, U$9.1, U$19.6
CELL6: Q8.P$3 (S), R12.1, R65.2, U$10.1, U$18.1
CELL7: Q9.P$3 (S), R14.1, R66.2, U$11.1, U$18.2
CELL8: Q10.P$3 (S), R16.1, R67.2, U$12.1, U$18.3
CELL9: Q11.P$3 (S), R18.1, R68.2, U$13.1, U$18.4
CELL10: R20.1, R24.1, R58.1, R69.2, R110.2, R111.1, U$18.5, U$45.2 (S), U$47.P$2 (2)
GAUGE_IRQ: U$44.2 (ALERT); also elsewhere on the board
GAUGE_RESET: R92.2, S3.P$4, U$44.24 (MRST); also elsewhere on the board
GAUGE_SCL: R81.2, U$20.5 (SCL), U$44.4 (SCL)
GAUGE_SDA: R82.2, U$20.4 (SDA), U$44.3 (SDA)
GND: C28.1, C52.2, C53.1, C57.1, C58.2, C59.1, C60.1, C61.1, C67.1, C68.1, C69.2, R27.1 (11), R28.1, R80.2, R83.1, R87.2, R104.2, R105.2, S2.P$3, S3.P$2, U$17.P$1, U$18.6, U$18.A1, U$18.A2, U$19.A1, U$19.A2, U$20.3 (VSS), U$41.1 (G), U$44.6 (VAUX), U$44.8 (PRES), U$44.9 (KEYIN), U$44.21 (GPIOA), U$44.22 (VSS), U$44.23 (VSS), U$44.25 (VSS), U$44.28 (GPIOB), U$44.30 (SMBA), U$46.2 (S), U$50.1, U$51.1, U$52.P$1, U$53.P$1, U$59.P$2, U$60.1; also elsewhere on the board
unnamed: R28.2, R71.2
unnamed: R29.1, R72.2
unnamed: Q1.P$1 (D), R4.2
unnamed: Q8.P$2 (G), R19.2, U$10.2
unnamed: Q1.P$2 (G), R5.2, U$6.2
unnamed: Q3.P$1 (D), R6.2
unnamed: Q3.P$2 (G), R9.2, U$3.2
unnamed: R22.2, U$20.1 (DSG)
unnamed: Q5.P$1 (D), R8.2
unnamed: Q4.P$1 (D), R7.2
unnamed: Q4.P$2 (G), R11.2, U$4.2
unnamed: Q5.P$2 (G), R13.2, U$7.2
unnamed: Q6.P$2 (G), R15.2, U$8.2
unnamed: Q8.P$1 (D), R14.2
unnamed: C40.2, C50.1, R19.1, R65.1, U$20.20 (VC6)
unnamed: C49.2, R17.1, R70.1, U$20.21 (VC5B)
unnamed: R24.2, R26.2, R93.1, R94.1, R95.1, R96.1, R97.1
unnamed: Q6.P$1 (D), R10.2
unnamed: Q7.P$1 (D), R12.2
unnamed: Q7.P$2 (G), R17.2, U$9.2
unnamed: Q9.P$1 (D), R16.2
unnamed: Q10.P$1 (D), R18.2
unnamed: Q11.P$1 (D), R20.2
unnamed: Q11.P$2 (G), R25.2, U$13.2
unnamed: Q10.P$2 (G), R23.2, U$12.2
unnamed: Q9.P$2 (G), R21.2, U$11.2
unnamed: C29.1, C30.2, R9.1, R60.1, U$20.26 (VC1)
unnamed: C30.1, C31.2, R11.1, R61.1, U$20.25 (VC2)
unnamed: C31.1, C32.2, R13.1, R62.1, U$20.24 (VC3)
unnamed: C32.1, C39.2, R15.1, R63.1, U$20.23 (VC4)
unnamed: C39.1, R64.1, U$20.22 (VC5), U$21.P$1
unnamed: C40.1, C46.2, R21.1, R66.1, U$20.19 (VC7)
unnamed: C46.1, C47.2, R23.1, R67.1, U$20.18 (VC8)
unnamed: C47.1, C48.2, R25.1, R68.1, U$20.17 (VC9)
unnamed: C48.1, R69.1, U$20.16 (VC10), U$43.P$1
unnamed: C28.2, C29.2, R5.1, R59.1, U$20.27 (VC0)
unnamed: C51.1, C53.2, R72.1, U$20.29 (SRN)
unnamed: C51.2, C52.1, R71.1, U$20.28 (SRP)
unnamed: C54.2, R27.2 (22), R29.2, R73.1, U$22.2 (S)
unnamed: U$22.3 (D), U$23.3 (D)
unnamed: R74.2, R75.1, U$23.1 (G), U$40.P$2
unnamed: R75.2, U$40.P$1, U$41.3 (D)
unnamed: U$20.2 (CHG), U$41.2 (S)
unnamed: C54.1, C55.2
unnamed: C56.2, U$20.11 (CAP2), U$20.12 (CAP2), U$20.14 (CAP2)
unnamed: R76.1, U$20.13 (TS2)
unnamed: C57.2, U$20.7 (CAP1)
unnamed: R84.1, U$44.12 (VEN), U$46.1 (G)
unnamed: R85.2, U$46.3 (D)
unnamed: R58.2, R85.1, U$45.1 (G), U$47.P$1 (1)
unnamed: R86.1, U$45.3 (D)
unnamed: C58.1, R86.2, R87.1, U$44.7 (BAT)
unnamed: C60.2, U$44.27 (RBI)
unnamed: LED10.A, R93.2
unnamed: LED11.A, R94.2
unnamed: LED13.A, R95.2
unnamed: LED14.A, R96.2
unnamed: LED15.A, R97.2
unnamed: LED10.C, U$44.16 (LED1)
unnamed: LED11.C, U$44.17 (LED2)
unnamed: LED13.C, U$44.18 (LED3)
unnamed: LED14.C, U$44.19 (LED4)
unnamed: LED15.C, U$44.20 (LED5)
unnamed: LED16.A, R98.2
unnamed: R99.2, S2.P$1, U$44.14 (DISP)
unnamed: LED16.C, U$44.15 (PWRM)
unnamed: R101.1, U$44.11 (SMBD)
unnamed: R100.1, U$44.13 (SMBC)
unnamed: R100.2, R102.1, R104.1, U$50.2
unnamed: R101.2, R103.1, R105.1, U$51.2
unnamed: R106.1, U$54.2 (S), U$55.P$1
unnamed: R111.2, U$54.3 (D)
unnamed: R22.1, R73.2, U$22.1 (G)
unnamed: J1.1, R107.2, S1.P$3
unnamed: C62.2, C63.1
unnamed: R108.2, U$54.1 (G)
PACK+: C63.2, U$15.P$1, U$16.P$1, U$56.P$1, U$58.2, U$60.2
PACK-: C55.1, C62.1, R74.1, U$14.P$1, U$23.2 (S), U$56.P$2, U$58.1, U$59.P$1
REGOUT: C59.2, C68.2, R26.1, R81.1, R82.1, R84.2, R92.1, R98.1, R99.1, U$20.8 (REGOUT), U$44.26 (VCC); also elsewhere on the board
REGSRC: C61.2, R106.2, U$20.9 (REGSRC), U$55.P$2
SMBC: R102.2, U$53.P$2; also elsewhere on the board
SMBD: R103.2, U$52.P$2; also elsewhere on the board
VC5X: C49.1, C50.2, C56.1, C64.1, C67.2, R76.2, R108.1, R109.1, U$20.10 (VC5X), U$21.P$2
VC10X: C64.2, R110.1, U$20.15 (BAT), U$43.P$2

Notes on the sheet:
BATTERY
PACK
GAUGE
AFE
Battery Management System

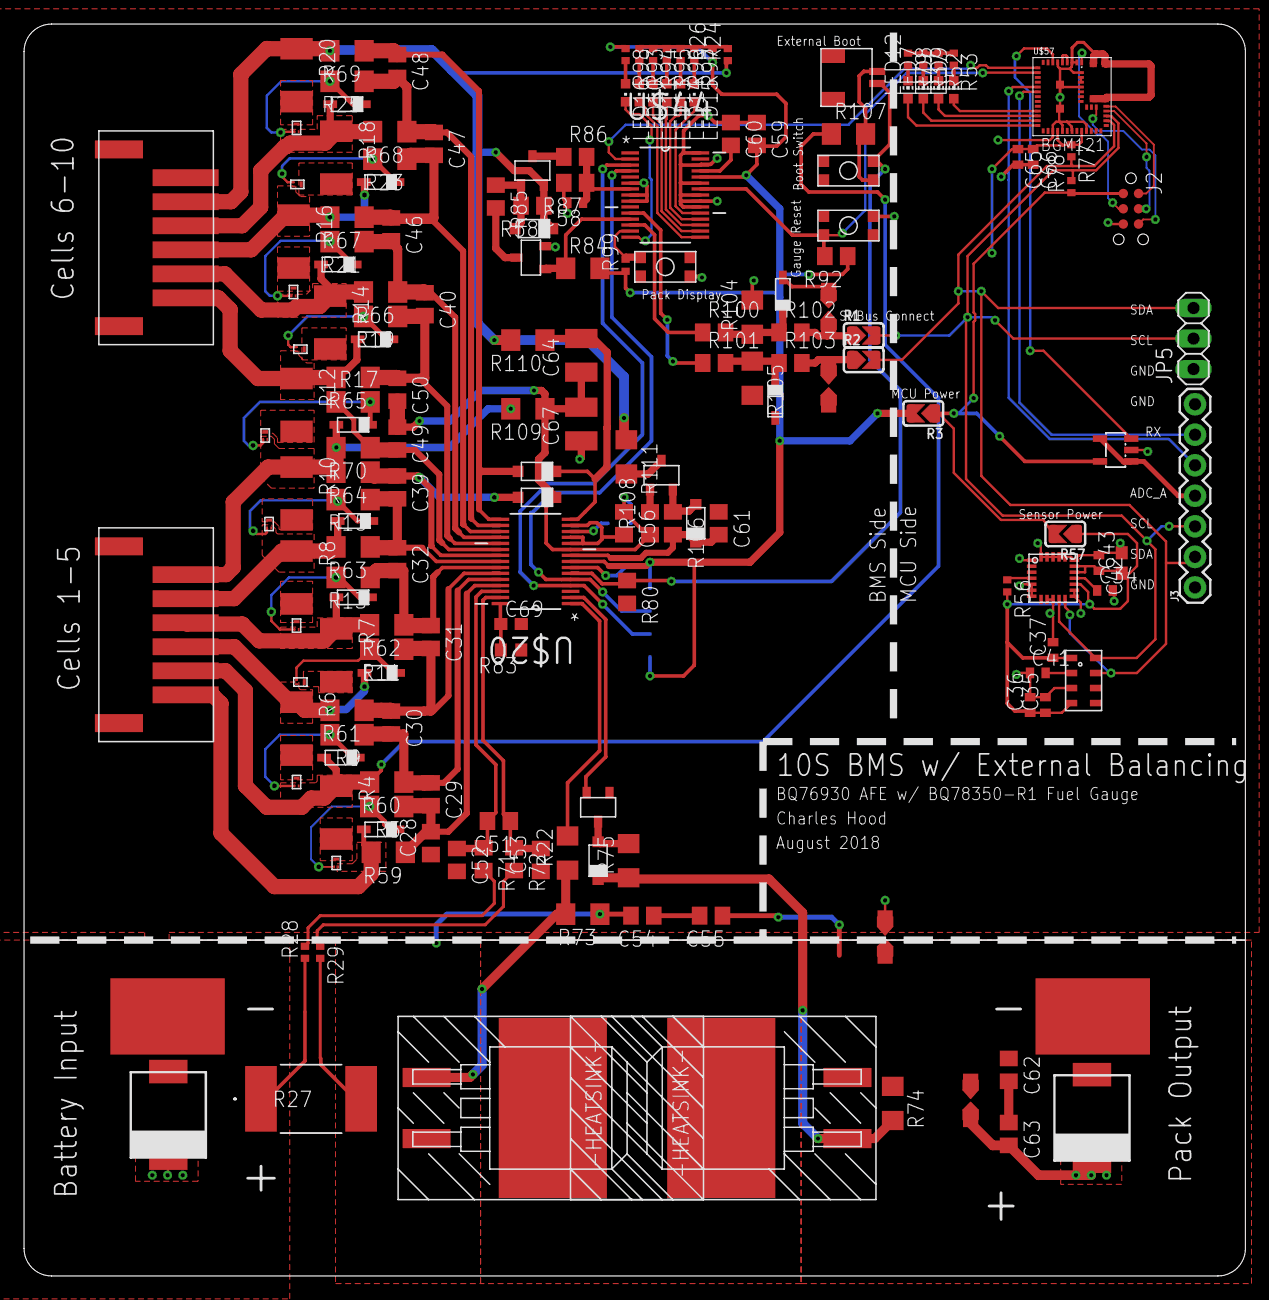
[picture p29: board Longboard.brd from above]

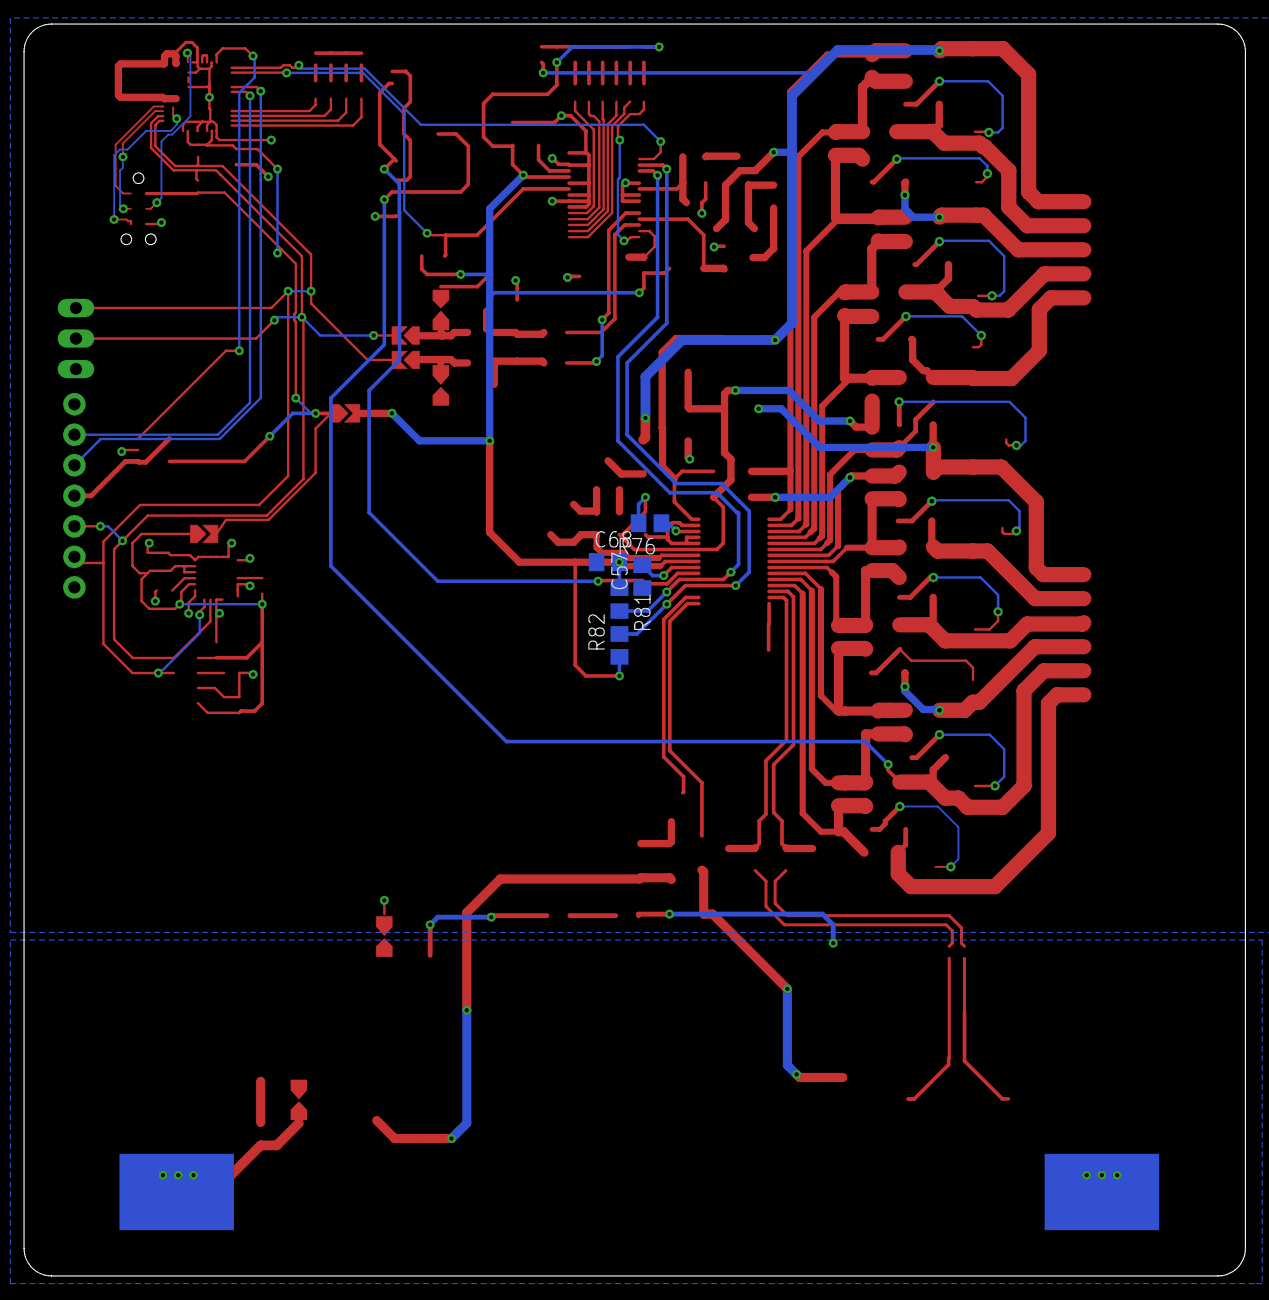
[picture p30: board Longboard.brd from below]

Board: 2 copper layers, 101.6 x 104.1 mm, 190 parts (7 on the bottom side), 127 nets.
