charlesh97/electric-longboard-bms/HW/Handheld Controller/v1/Handheld.brd

## EAGLE design HW/Handheld Controller/v1/Handheld.brd (2022-02-06, an earlier design)

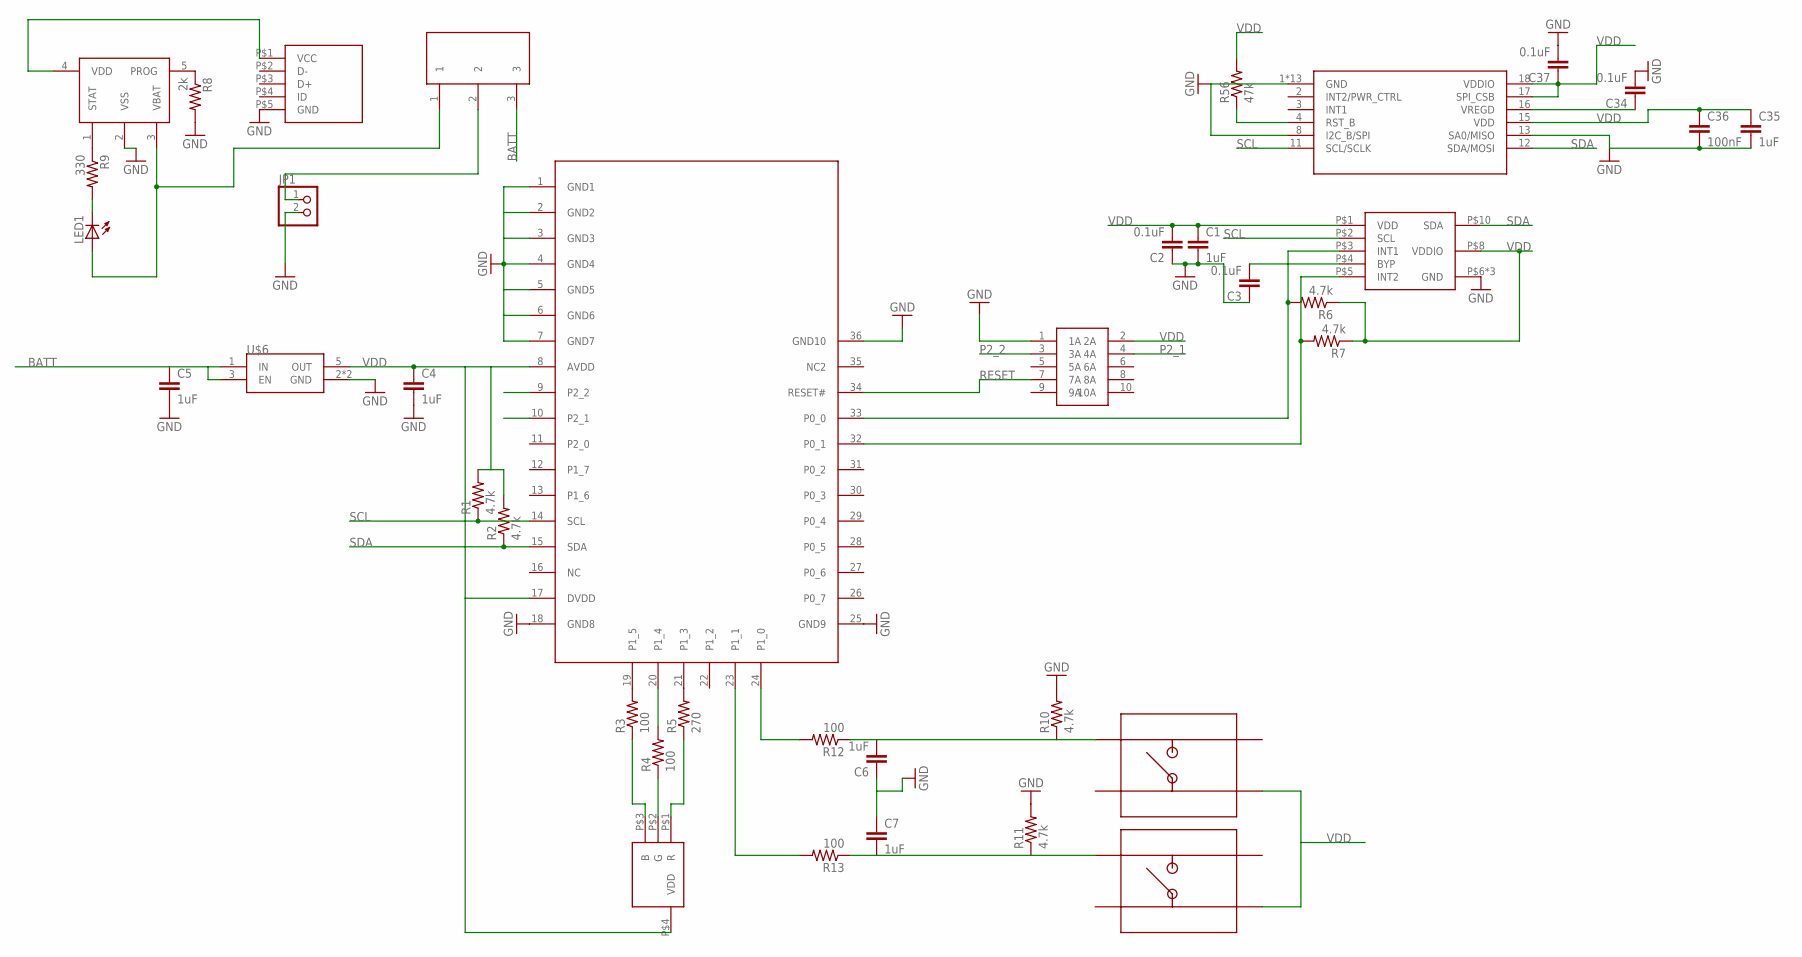
[picture p31: schematic Handheld.sch]

Parts:
C1, C4, C5, C6, C7, C35: 1uF; C0402
C2, C3, C34, C37: 0.1uF; C0402
C36: 100nF; C0402
JP1: PINHD-1X2; 1X02
LED1: LEDCHIPLED_0805; CHIPLED_0805
R1, R2, R6, R7, R10, R11: 4.7k; R0402
R3, R4, R12, R13: 100; R0402
R5: 270; R0402
R8: 2k; R0402
R9: 330; R0402
R56: 47k; R0402
U$1: BLE113; BLUEGIGA
U$2: RIBBON_10POS_MALE
U$3: MMA8653FC; 10-DFN2X2
U$4: MCP73831
U$5: MICRO_USB; MOLEX_USB
U$6: TPS782XX; SOT23-5L
U$7: LTST-C19HE1WT
U$8, U$9: SMD_TACTILE; EVQ-Q2U03W
U$10: SPDT_THRU
U$34: FXAS21002

Connections:
BATT: C5.1, U$6.1 (IN), U$6.3 (EN), U$10.3
GND: C1.2, C2.1, C3.1, C4.2, C5.2, C6.1, C7.1, C34.2, C35.2, C36.2, C37.2, JP1.2, R8.2, R10.2, R11.2, U$1.1 (GND1), U$1.2 (GND2), U$1.3 (GND3), U$1.4 (GND4), U$1.5 (GND5), U$1.6 (GND6), U$1.7 (GND7), U$1.18 (GND8), U$1.25 (GND9), U$1.36 (GND10), U$2.1 (1A), U$3.P$6 (GND), U$3.P$7 (GND), U$3.P$9 (GND), U$4.2 (VSS), U$5.P$5 (GND), U$6.2 (GND), U$6.4 (GND), U$34.1 (GND), U$34.5 (GND), U$34.6 (GND), U$34.7 (GND), U$34.8 (I2C_B/SPI), U$34.9 (GND), U$34.10 (GND), U$34.13 (SA0/MISO), U$34.14 (GND), U$34.19 (GND), U$34.20 (GND), U$34.21 (GND), U$34.22 (GND), U$34.23 (GND), U$34.24 (GND)
unnamed: C7.2, R11.1, R13.1, U$9.1
unnamed: R3.2, U$1.19 (P1_5)
unnamed: C3.2, U$3.P$4 (BYP)
unnamed: R4.2, U$1.20 (P1_4)
unnamed: R5.2, U$1.21 (P1_3)
unnamed: R3.1, U$7.P$3 (B)
unnamed: R4.1, U$7.P$2 (G)
unnamed: R5.1, U$7.P$1 (R)
unnamed: R6.2, U$1.33 (P0_0), U$3.P$3 (INT1)
unnamed: R7.2, U$1.32 (P0_1), U$3.P$5 (INT2)
unnamed: R8.1, U$4.5 (PROG)
unnamed: R9.1, U$4.1 (STAT)
unnamed: LED1.C, R9.2
unnamed: LED1.A, U$4.3 (VBAT), U$10.1
unnamed: U$4.4 (VDD), U$5.P$1 (VCC)
unnamed: JP1.1, U$10.2
unnamed: R13.2, U$1.23 (P1_1)
unnamed: R12.2, U$1.24 (P1_0)
unnamed: C6.2, R10.1, R12.1, U$8.1
unnamed: R56.1, U$34.4 (RST_B)
unnamed: C34.1, U$34.16 (VREGD)
P2_1: U$2.4 (4A)
P2_2: U$2.3 (3A)
RESET: U$1.34 (RESET#), U$2.7 (7A)
SCL: R1.1, U$1.14 (SCL), U$3.P$2 (SCL), U$34.11 (SCL/SCLK)
SDA: R2.1, U$1.15 (SDA), U$3.P$10 (SDA), U$34.12 (SDA/MOSI)
VDD: C1.1, C2.2, C4.1, C35.1, C36.1, C37.1, R1.2, R2.2, R6.1, R7.1, R56.2, U$1.8 (AVDD), U$1.17 (DVDD), U$2.2 (2A), U$3.P$1 (VDD), U$3.P$8 (VDDIO), U$6.5 (OUT), U$7.P$4 (VDD), U$8.4, U$9.4, U$34.15 (VDD), U$34.17 (SPI_CSB), U$34.18 (VDDIO)

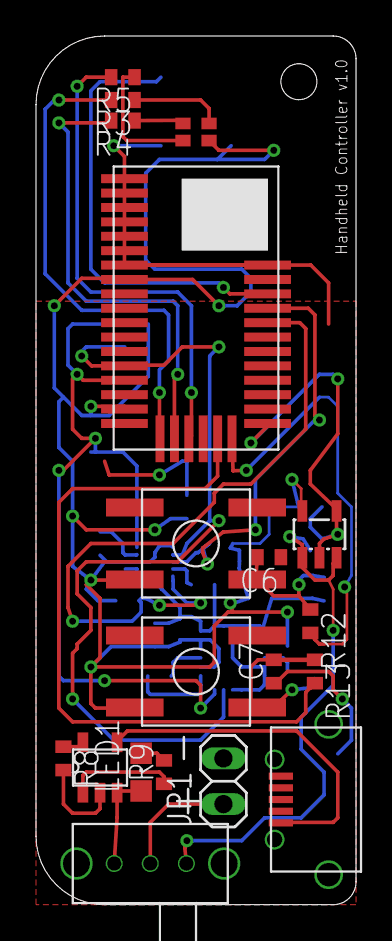
[picture p32: board Handheld.brd from above]

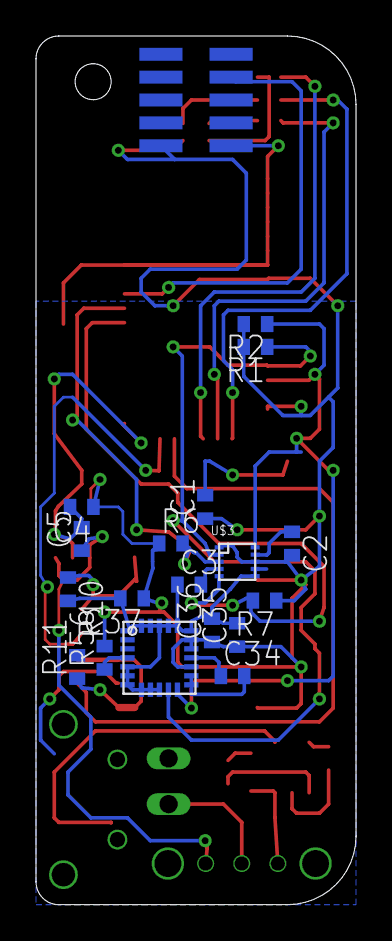
[picture p33: board Handheld.brd from below]

Board: 2 copper layers, 17.8 x 48.3 mm, 38 parts (19 on the bottom side), 27 nets.
