charlesh97/electric-longboard-bms/HW/OldBoards/Breakout/Test2.brd

## EAGLE design HW/OldBoards/Breakout/Test2.brd (2022-02-06, an earlier design)

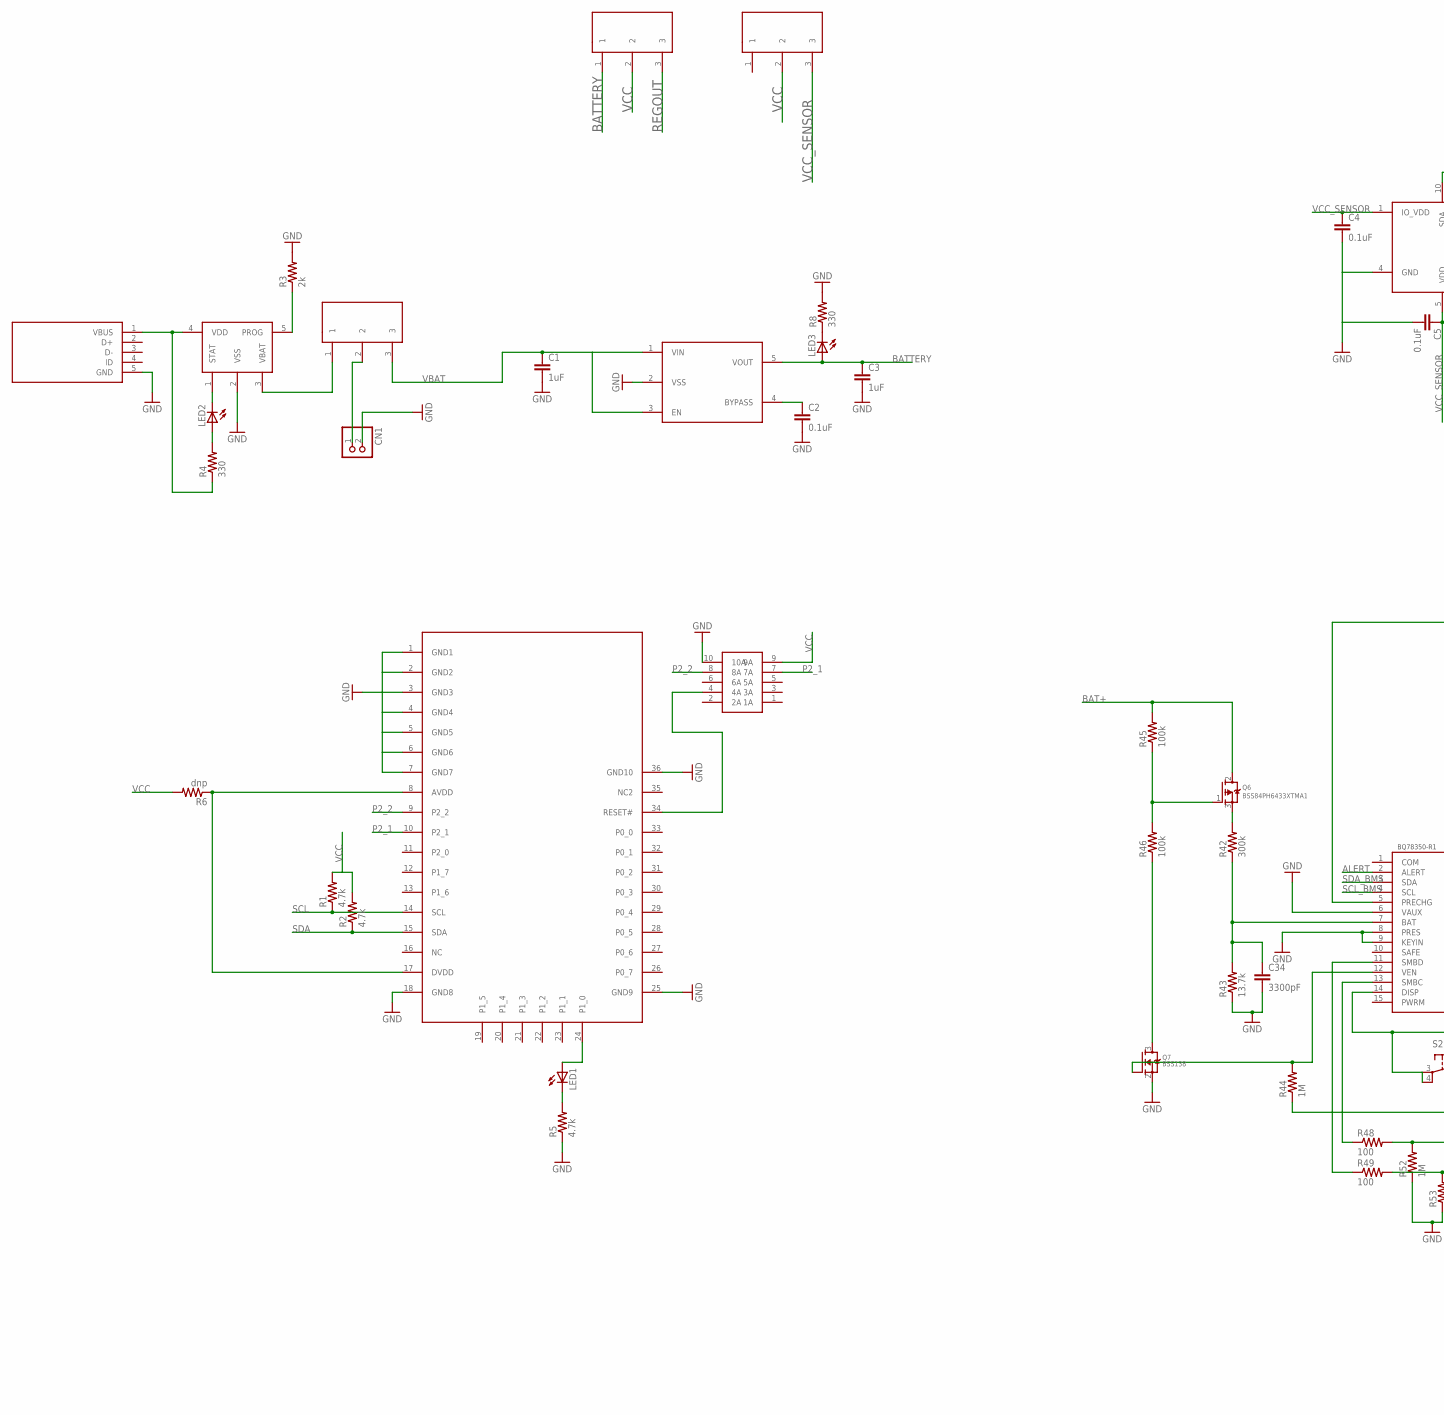
[picture p34: schematic Test2.sch, part in row 1, column 1]

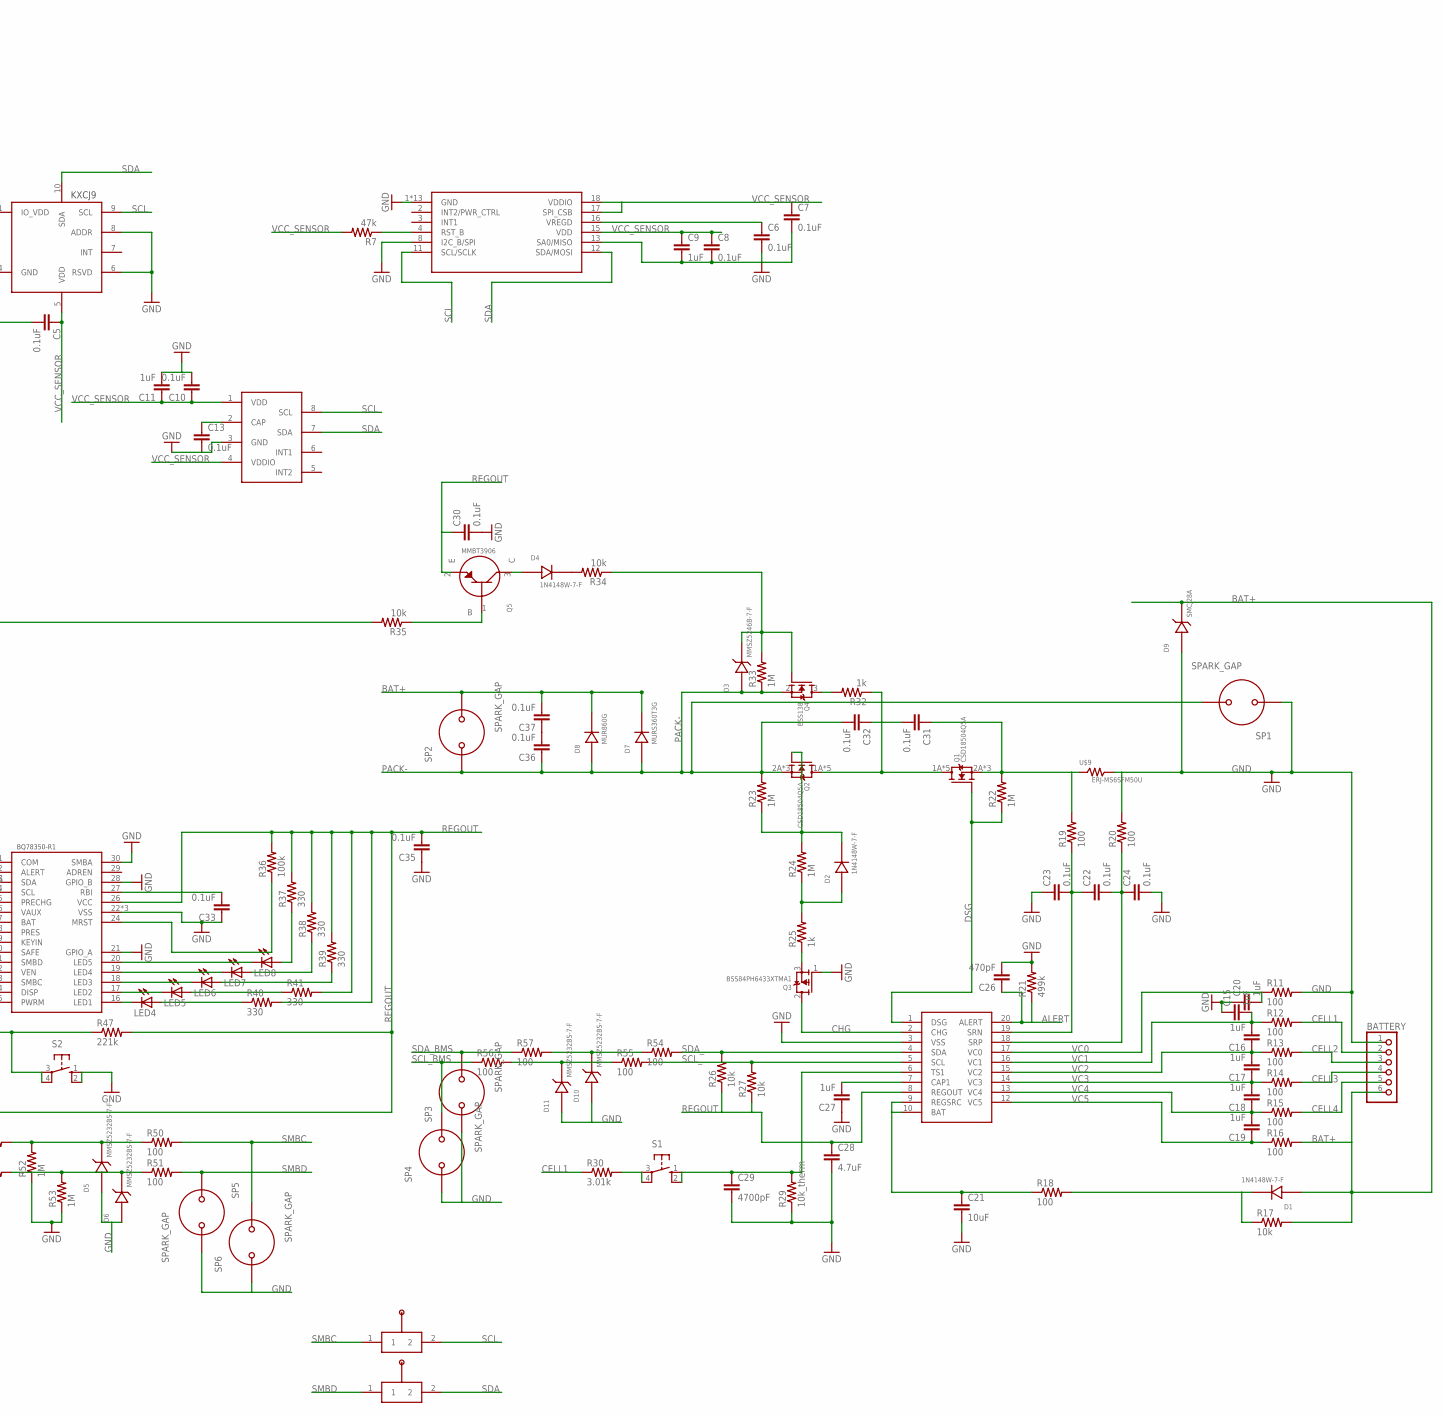
[picture p35: schematic Test2.sch, part in row 1, column 2]

Parts:
BATTERY: PINHD-1X6; 1X06
C1, C3, C9, C11: 1uF; C0402
C2, C4, C5, C6, C7, C8, C10, C13: 0.1uF; C0402
C15, C16, C17, C18, C19, C20, C27: 1uF; C0805
C21: 10uF; C1206
C22, C23, C24, C30, C31, C32, C33, C35, C36, C37: 0.1uF; C0805
C26: 470pF; C0805
C28: 4.7uF; C0805
C29: 4700pF; C0402
C34: 3300pF; C0402
CN1: JST_2PIN-SMT-RA; JST-PH-2-SMT-RA
D1, D2, D4: 1N4148W-7-F; SOD-123
D3: MMSZ5246B-7-F; SOD-123
D5, D6, D10, D11: MMSZ5232BS-7-F; SOD-323F
D7: MURS360T3G; SMC(DO-214AB)
D8: MUR860G; TO-220(2RA)
D9: SMCJ28A; SMC(DO-214AB)
LED1, LED2, LED3: LEDCHIP-LED0805; CHIP-LED0805
LED4, LED5, LED6, LED7, LED8: LEDCHIPLED_0805; CHIPLED_0805
Q1, Q2: CSD18504Q5A; Q5A
Q3, Q6: BSS84PH6433XTMA1; SOT23-3
Q4, Q7: BSS138; SOT23-3
Q5: MMBT3906; SOT23-3
R1, R2, R5: 4.7k; R0402
R3: 2k; R0402
R4, R8, R37, R38, R39, R40, R41: 330; R0402
R6: dnp; R0402
R7: 47k; R0402
R11, R12, R13, R14, R15, R16: 100; R1206
R17, R26, R27, R34, R35: 10k; R0805
R18, R19, R20, R48, R49, R50, R51, R54, R55, R56, R57: 100; R0805
R21: 499k; R0805
R22, R23, R24, R33, R44, R52, R53: 1M; R1206
R25: 1k; R0805
R29: 10k_therm; R0402
R30: 3.01k; R0805
R32: 1k; R2512
R36, R45, R46: 100k; R0805
R42: 300k; R0805
R43: 13.7k; R0805
R47: 221k; R0805
S1, S2: 10-XX; B3F-10XX
SP1, SP2, SP3, SP4, SP5, SP6: SPARK_GAP
U$1: BQ76920; SOIC-20
U$2: BLE113; BLUEGIGA
U$3: RIBBON_10POS_MALE
U$4: LP3985; SOT23-5L
U$5, U$11, U$12: SPDT_THRU
U$6: USB_MINI
U$7: KXCJ9
U$8: FXAS21002
U$9: ERJ-MS6SFM50U
U$10: BQ78350-R1; SOIC-30
U$13: MCP73831
U$14: MLP3115A2
U$16, U$17: MANUAL_SWITCH

Connections:
ALERT: C26.1, R21.1, U$1.20 (ALERT), U$10.2 (ALERT)
BAT+: BATTERY.6, C37.2, D1.P$1, D7.2, D8.P$3, D9.2, Q6.2 (S), R16.2, R17.2, R45.2, SP2.P$2
BATTERY: C3.1, LED3.A, U$4.5 (VOUT), U$11.1
CELL1: BATTERY.2, R12.2, R30.1
CELL2: BATTERY.3, R13.2
CELL3: BATTERY.4, R14.2
CELL4: BATTERY.5, R15.2
CHG: Q3.2 (S), U$1.2 (CHG)
DSG: Q1.3A (G), R22.1, U$1.1 (DSG)
GND: BATTERY.1, C1.2, C2.2, C3.2, C4.2, C5.2, C6.2, C7.2, C8.2, C9.2, C10.2, C11.2, C13.2, C15.1, C20.1, C21.2, C23.1, C24.2, C26.2, C27.1, C28.2, C29.2, C30.2, C33.1, C34.2, C35.1, CN1.2 (1), D5.1, D6.1, D9.1, D10.1, D11.1, Q3.1 (G), Q7.2 (S), R3.2, R5.1, R8.2, R11.2, R20.2, R21.2, R29.1, R43.1, R52.1, R53.1, S2.1 (S), S2.2 (S1), SP1.P$1, SP3.P$1, SP4.P$1, SP5.P$2, SP6.P$1, U$1.3 (VSS), U$2.1 (GND1), U$2.2 (GND2), U$2.3 (GND3), U$2.4 (GND4), U$2.5 (GND5), U$2.6 (GND6), U$2.7 (GND7), U$2.18 (GND8), U$2.25 (GND9), U$2.36 (GND10), U$3.10 (10A), U$4.2 (VSS), U$6.5 (GND), U$7.4 (GND), U$7.6 (RSVD), U$7.8 (ADDR), U$8.1 (GND), U$8.5 (GND), U$8.6 (GND), U$8.7 (GND), U$8.8 (I2C_B/SPI), U$8.9 (GND), U$8.10 (GND), U$8.13 (SA0/MISO), U$8.14 (GND), U$8.19 (GND), U$8.20 (GND), U$8.21 (GND), U$8.22 (GND), U$8.23 (GND), U$8.24 (GND), U$9.2, U$10.6 (VAUX), U$10.8 (PRES), U$10.9 (KEYIN), U$10.21 (GPIO_A), U$10.22 (VSS), U$10.23 (VSS), U$10.25 (VSS), U$10.28 (GPIO_B), U$10.30 (SMBA), U$13.2 (VSS), U$14.3 (GND)
unnamed: R6.1, U$2.8 (AVDD), U$2.17 (DVDD)
unnamed: CN1.1 (2), U$5.2
unnamed: U$2.34 (RESET#), U$3.4 (4A)
unnamed: R3.1, U$13.5 (PROG)
unnamed: U$5.1, U$13.3 (VBAT)
unnamed: LED2.A, R4.2
unnamed: LED2.C, U$13.1 (STAT)
unnamed: LED1.C, R5.2
unnamed: LED1.A, U$2.24 (P1_0)
unnamed: C2.1, U$4.4 (BYPASS)
unnamed: C6.1, U$8.16 (VREGD)
unnamed: C13.1, U$14.2 (CAP)
unnamed: LED3.C, R8.1
unnamed: C21.1, R18.1, U$1.9 (REGSRC), U$1.10 (BAT)
unnamed: C22.2, C24.1, R20.1, U$1.18 (SRP)
unnamed: D1.P$2, R17.1, R18.2
unnamed: D11.2, R55.1, R56.2
unnamed: C31.1, Q1.2A (S), Q1.2B (S), Q1.2C (S), R19.2, R22.2, U$9.1
unnamed: C22.1, C23.2, R19.1, U$1.19 (SRN)
unnamed: C27.2, U$1.7 (CAP1)
unnamed: Q4.3 (D), R32.2
unnamed: D4.P$2, R34.2
unnamed: D3.P$2 (2), Q4.1 (G), R33.2, R34.1
unnamed: D4.P$1, Q5.3 (C)
unnamed: D2.P$1, R24.1, R25.2
unnamed: Q1.1A (D), Q1.1B (D), Q1.1C (D), Q1.1D (D), Q1.1E (D), Q2.1A (D), Q2.1B (D), Q2.1C (D), Q2.1D (D), Q2.1E (D), R32.1
unnamed: C36.2, C37.1
unnamed: D2.P$2, Q2.3A (G), R23.1, R24.2
unnamed: Q3.3 (D), R25.1
unnamed: R30.2, S1.3, S1.4 (P1)
unnamed: C29.1, R29.2, S1.1 (S), S1.2 (S1), U$1.6 (TS1)
unnamed: Q5.1 (B), R35.1
unnamed: C31.2, C32.1
unnamed: C33.2, U$10.27 (RBI)
unnamed: R35.2, U$10.5 (PRECHG)
unnamed: R36.1, U$10.24 (MRST)
unnamed: Q7.3 (D), R46.1
unnamed: LED8.C, U$10.20 (LED5)
unnamed: LED7.C, U$10.19 (LED4)
unnamed: LED6.C, U$10.18 (LED3)
unnamed: LED5.C, U$10.17 (LED2)
unnamed: LED4.C, U$10.16 (LED1)
unnamed: LED4.A, R40.1
unnamed: LED5.A, R41.1
unnamed: LED6.A, R39.1
unnamed: LED7.A, R38.1
unnamed: LED8.A, R37.1
unnamed: C34.1, R42.1, R43.2, U$10.7 (BAT)
unnamed: Q7.1 (G), R44.2, U$10.12 (VEN)
unnamed: Q6.3 (D), R42.2
unnamed: Q6.1 (G), R45.1, R46.2
unnamed: R48.1, U$10.13 (SMBC)
unnamed: R47.1, S2.3, S2.4 (P1), U$10.14 (DISP)
unnamed: R49.1, U$10.11 (SMBD)
unnamed: D5.2, R48.2, R50.1, R52.2
unnamed: D6.2, R49.2, R51.1, R53.2
unnamed: D10.2, R54.1, R57.2
P2_1: U$2.10 (P2_1), U$3.7 (7A)
P2_2: U$2.9 (P2_2), U$3.8 (8A)
PACK-: C32.2, C36.1, D3.P$1 (1), D7.1, D8.P$1, D8.P$4, Q2.2A (S), Q2.2B (S), Q2.2C (S), Q4.2 (S), R23.2, R33.1, SP1.P$2, SP2.P$1
REGOUT: C28.1, C30.1, C35.2, Q5.2 (E), R26.1, R27.1, R36.2, R37.2, R38.2, R39.2, R40.2, R41.2, R44.1, R47.2, U$1.8 (REGOUT), U$10.26 (VCC), U$11.3
RST_B: R7.1, U$8.4 (RST_B)
SCL: R1.1, U$2.14 (SCL), U$7.9 (SCL), U$8.11 (SCL/SCLK), U$14.8 (SCL), U$16.2
SCL_: R27.2, R55.2, U$1.5 (SCL)
SCL_BMS: R56.1, SP4.P$2, U$10.4 (SCL)
SDA: R2.1, U$2.15 (SDA), U$7.10 (SDA), U$8.12 (SDA/MOSI), U$14.7 (SDA), U$17.2
SDA_: R26.2, R54.2, U$1.4 (SDA)
SDA_BMS: R57.1, SP3.P$2, U$10.3 (SDA)
SMBC: R50.2, SP6.P$2, U$16.1
SMBD: R51.2, SP5.P$1, U$17.1
VBAT: C1.1, U$4.1 (VIN), U$4.3 (EN), U$5.3
VBUS: R4.1, U$6.1 (VBUS), U$13.4 (VDD)
VC0: C20.2, R11.1, U$1.17 (VC0)
VC1: C15.2, C16.2, R12.1, U$1.16 (VC1)
VC2: C16.1, C17.2, R13.1, U$1.15 (VC2)
VC3: C17.1, C18.2, R14.1, U$1.14 (VC3)
VC4: C18.1, C19.2, R15.1, U$1.13 (VC4)
VC5: C19.1, R16.1, U$1.12 (VC5)
VCC: R1.2, R2.2, R6.2, U$3.9 (9A), U$11.2, U$12.2
VCC_SENSOR: C4.1, C5.1, C7.1, C8.1, C9.1, C10.1, C11.1, R7.2, U$7.1 (IO_VDD), U$7.5 (VDD), U$8.15 (VDD), U$8.17 (SPI_CSB), U$8.18 (VDDIO), U$12.3, U$14.1 (VDD), U$14.4 (VDDIO)

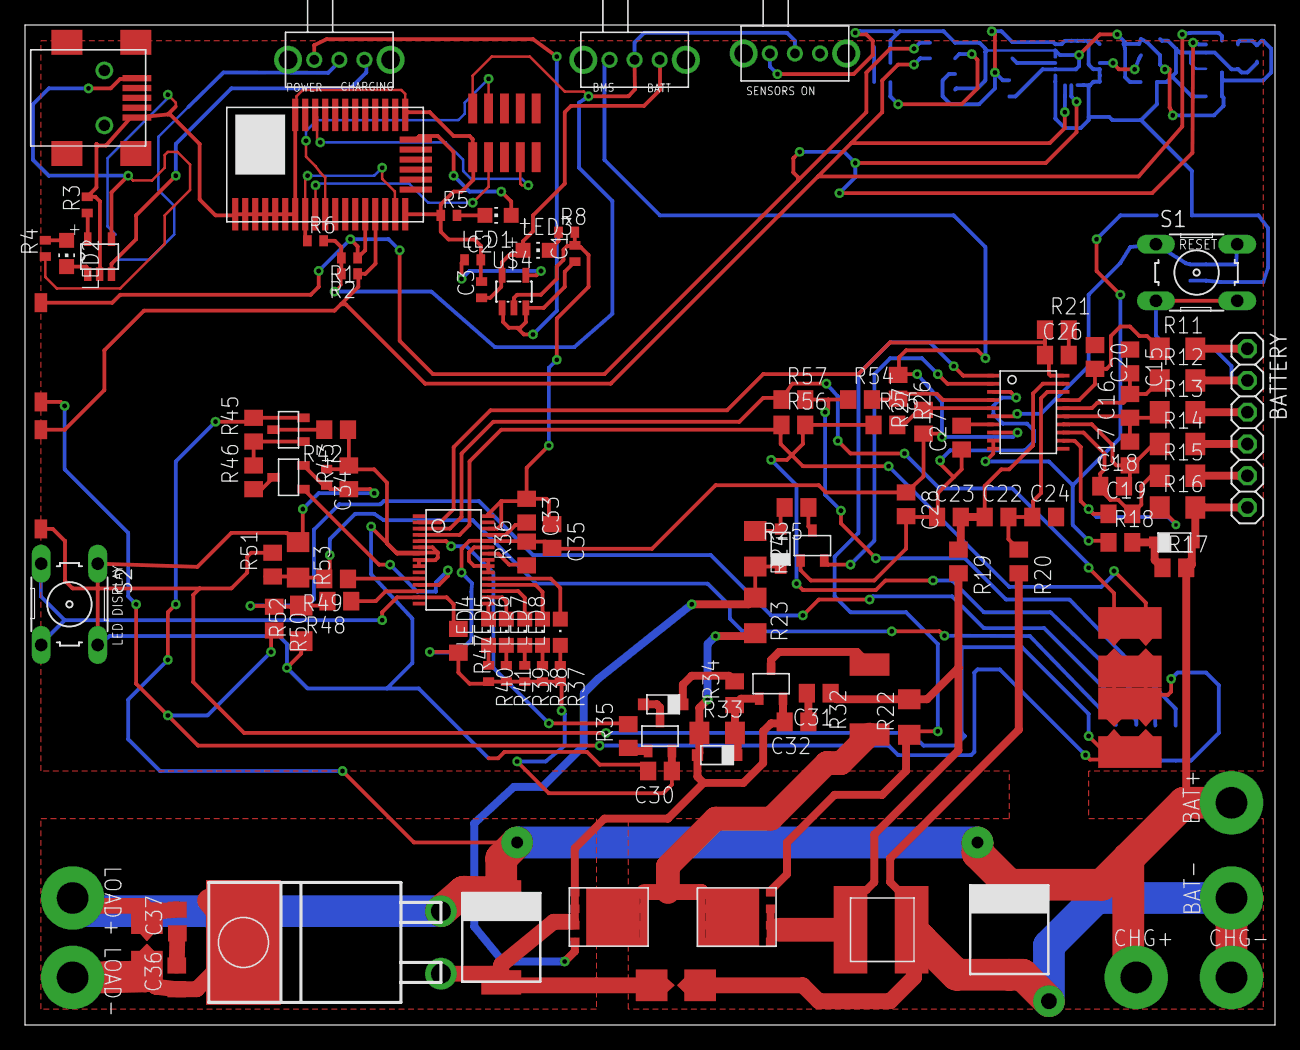
[picture p36: board Test2.brd from above]

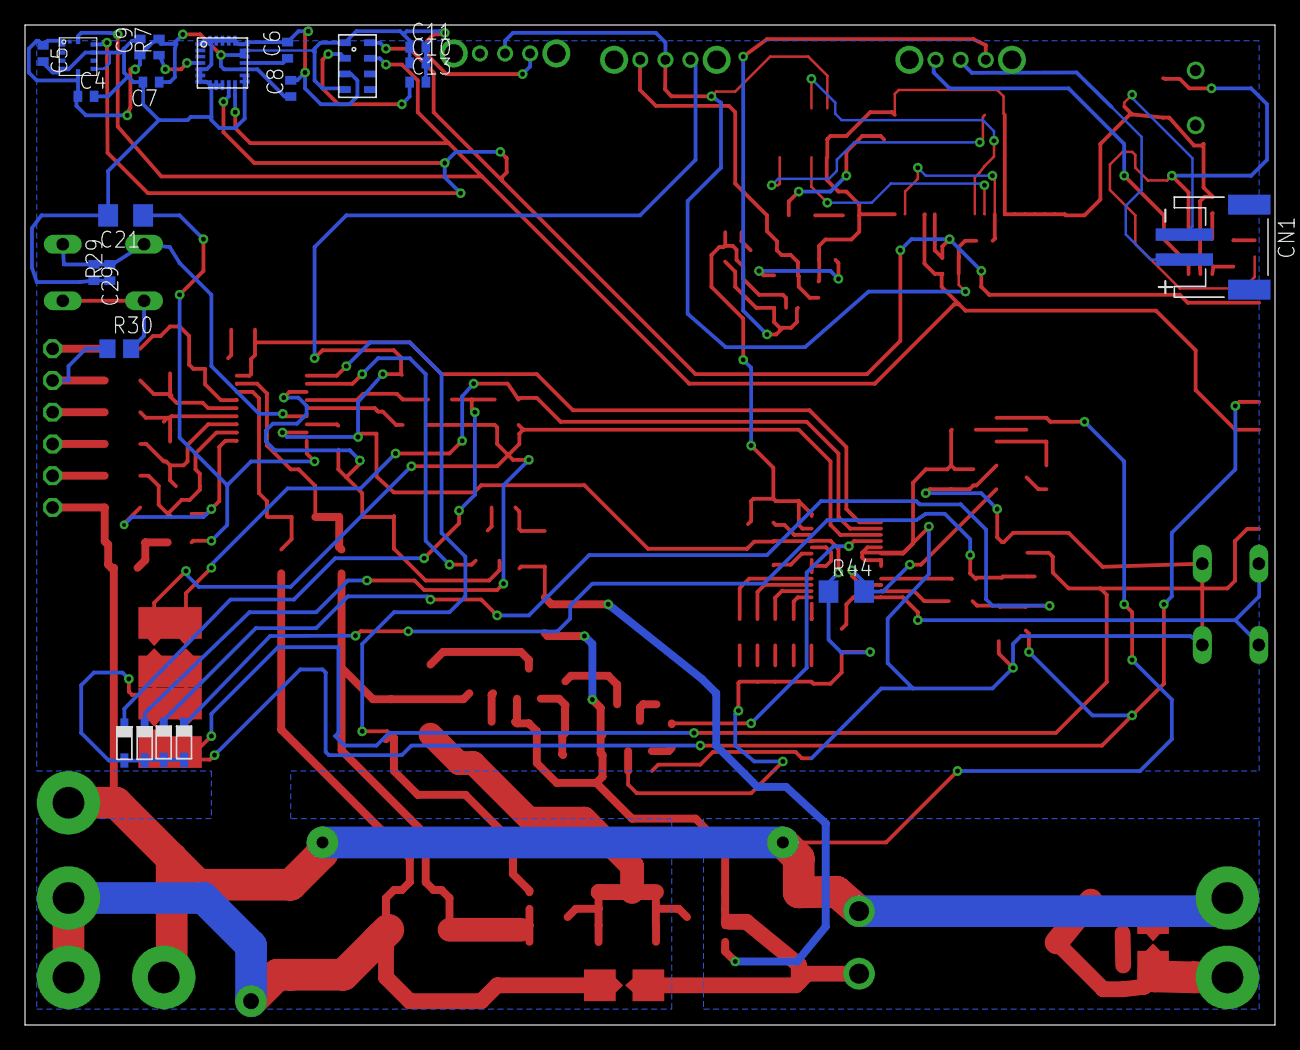
[picture p37: board Test2.brd from below]

Board: 2 copper layers, 100.0 x 80.0 mm, 139 parts (23 on the bottom side), 90 nets.
