charlesh97/electric-longboard-bms/HW/OldBoards/Breakout/LIS2DH_16g.brd

## EAGLE design HW/OldBoards/Breakout/LIS2DH_16g.brd (2022-02-06, an earlier design)

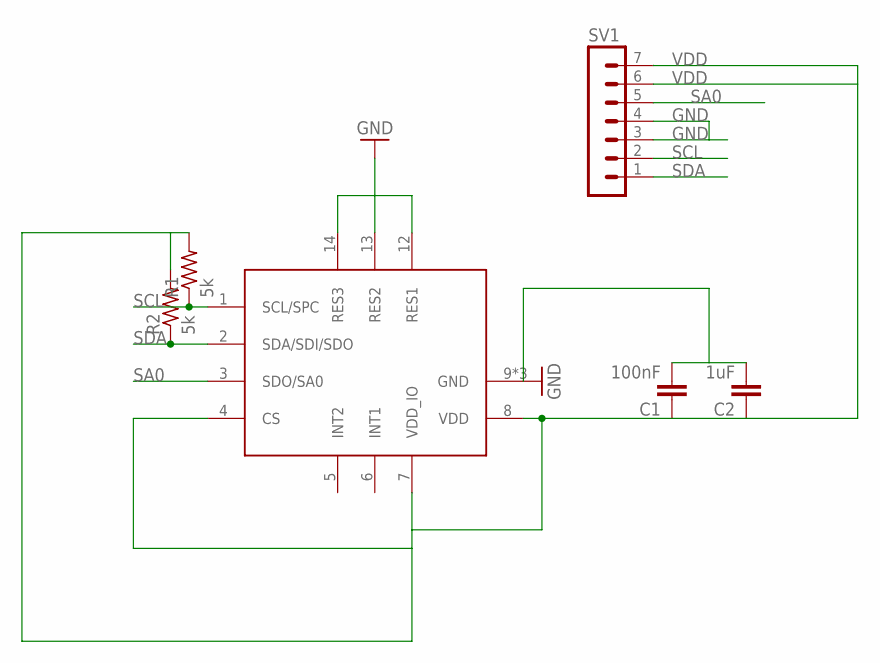
[picture p38: schematic LIS2DH_16g.sch]

Parts:
C1: 100nF; C0402
C2: 1uF; C0402
R1, R2: 5k; R0402
SV1: MA07-1
U$1: LISDH_16G; LGA14_2X2

Connections:
GND: C1.2, C2.2, SV1.3, SV1.4, U$1.9 (GND), U$1.10 (GND), U$1.11 (GND), U$1.12 (RES1), U$1.13 (RES2), U$1.14 (RES3)
SA0: SV1.5, U$1.3 (SDO/SA0)
SCL: R1.1, SV1.2, U$1.1 (SCL/SPC)
SDA: R2.1, SV1.1, U$1.2 (SDA/SDI/SDO)
VDD: C1.1, C2.1, R1.2, R2.2, SV1.6, SV1.7, U$1.4 (CS), U$1.7 (VDD_IO), U$1.8 (VDD)

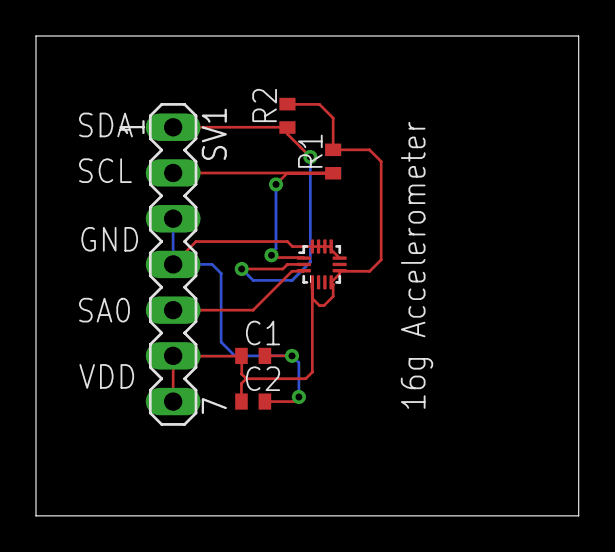
[picture p39: board LIS2DH_16g.brd from above]

Board: 2 copper layers, 30.1 x 26.7 mm, 6 parts (0 on the bottom side), 5 nets.
