charlesh97/electric-longboard-bms/HW/Handheld Controller/v2/Controllerv2.brd

## EAGLE design HW/Handheld Controller/v2/Controllerv2.brd (2022-02-06)

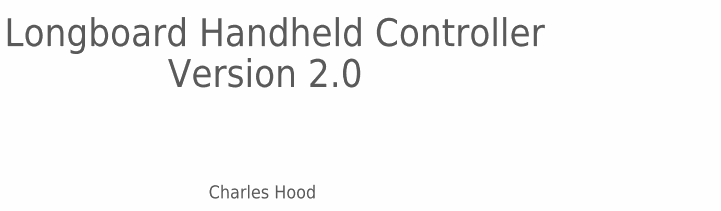
[picture p40: schematic Controllerv2.sch, sheet 1]

Notes on the sheet:
Longboard Handheld Controller
Version 2.0
Charles Hood

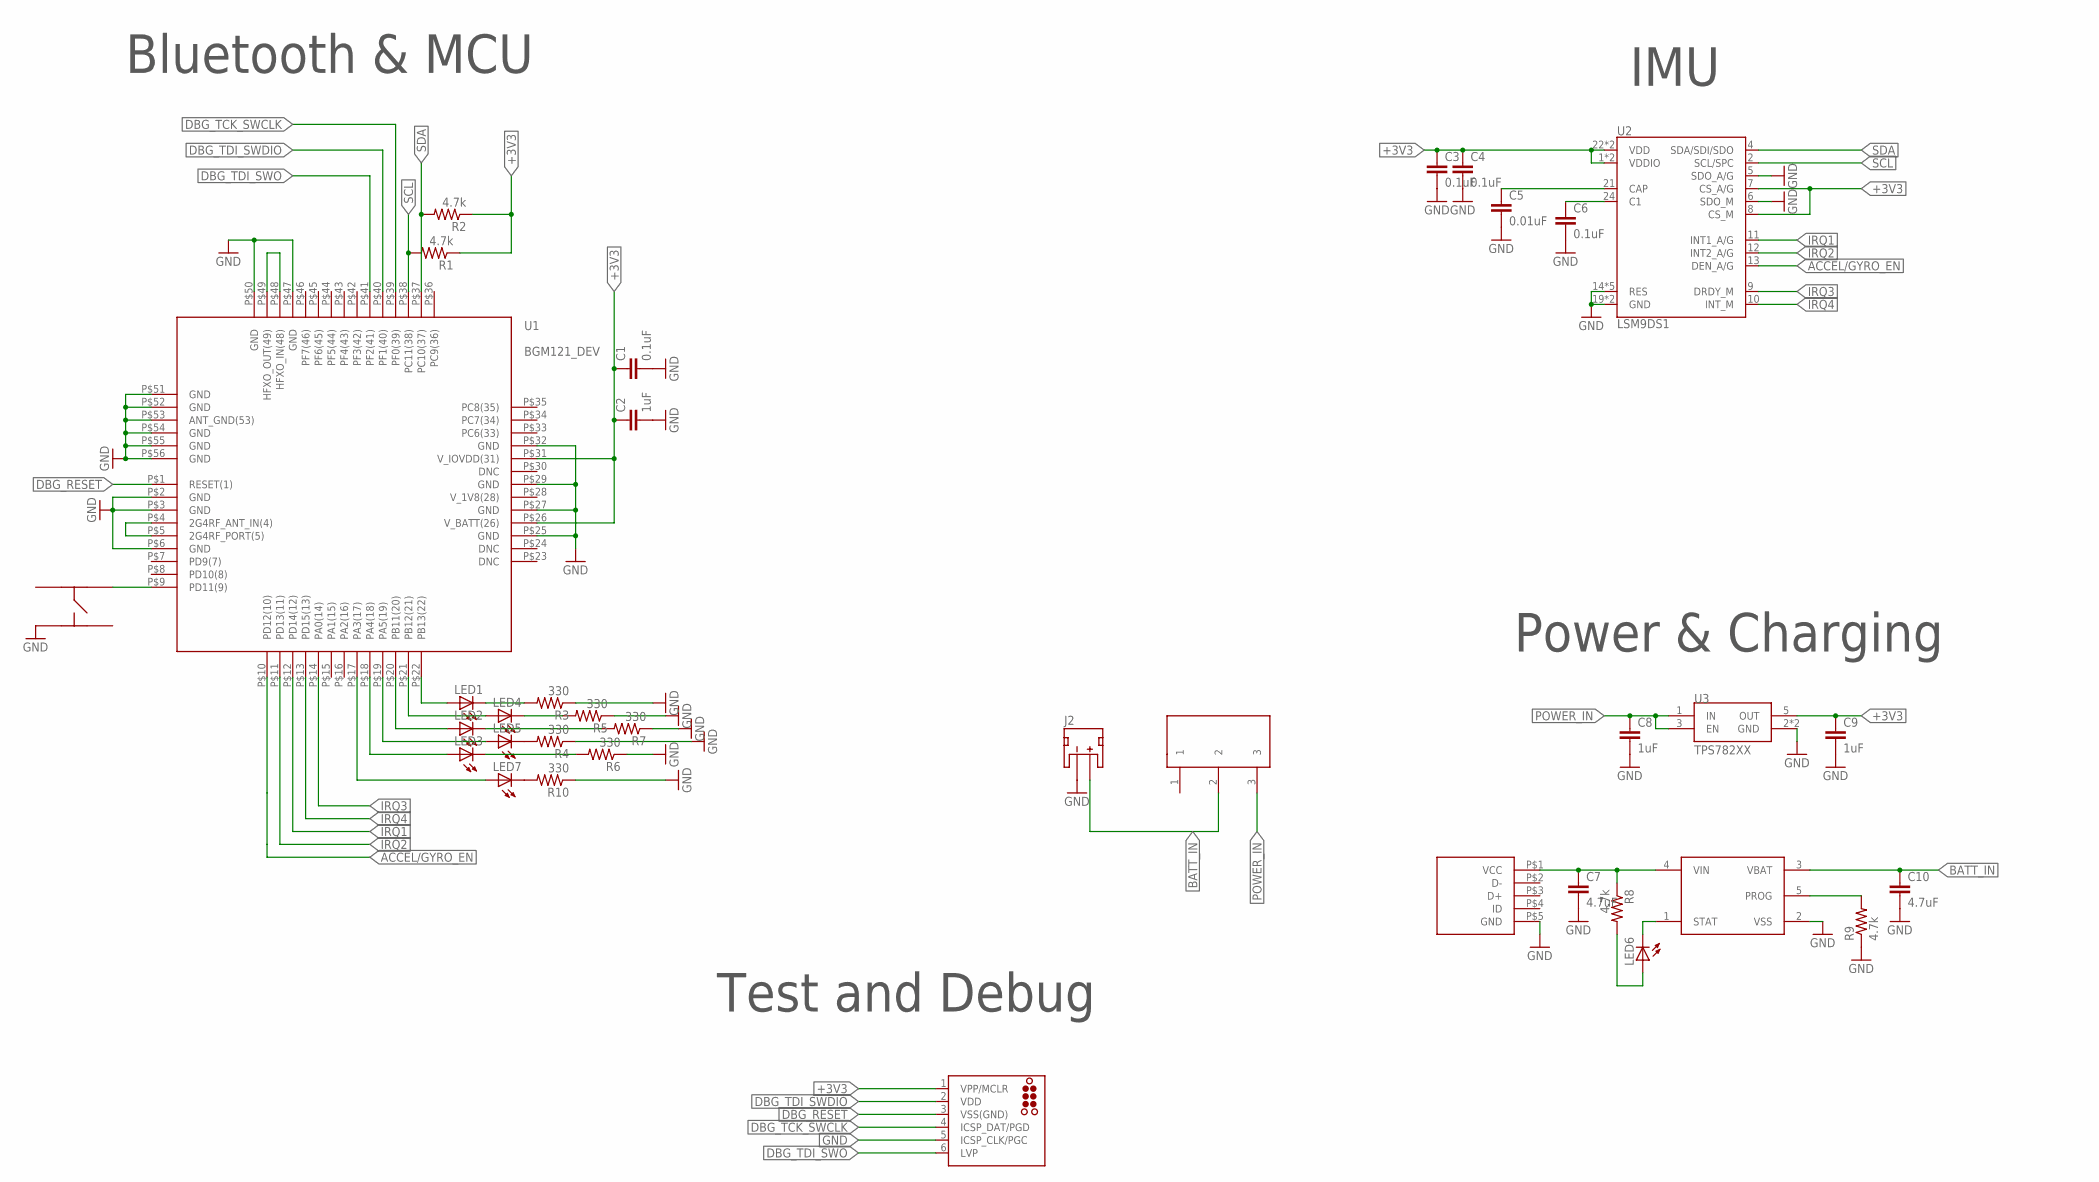
[picture p41: schematic Controllerv2.sch, sheet 2]

Parts:
C1, C3, C4, C6: 0.1uF; C0201
C2, C8, C9: 1uF; C0201
C5: 0.01uF; C0201
C7, C10: 4.7uF; C0402
J1: MICRO_USB; MOLEX_USB
J2: JST_2MM_MALE; JST-2-SMD
J3: TC2030-MCP-NL
LED1, LED2, LED3, LED4, LED5, LED6, LED7: LEDCHIP-LED0603; CHIP-LED0603
R1, R2, R8, R9: 4.7k; R0201
R3, R4, R5, R6, R7, R10: 330; R0201
S1: KMR731NG
U1: BGM121_DEV; BGM121_PAC
U2: LSM9DS1; LGA24-8X4
U3: TPS782XX; SOT23-5L
U4: MCP73831; SOT23-5L
U$1: SPDT_THRU

Connections:
+3V3: C1.1, C2.1, C3.1, C4.1, C9.1, J3.1 (VPP/MCLR), R1.1, R2.1, U1.P$26 (V_BATT(26)), U1.P$31 (V_IOVDD(31)), U2.1 (VDDIO), U2.3 (VDDIO), U2.7 (CS_A/G), U2.8 (CS_M), U2.22 (VDD), U2.23 (VDD), U3.5 (OUT)
ACCEL/GYRO_EN: U1.P$10 (PD12(10)), U2.13 (DEN_A/G)
BATT_IN: C10.1, J2.2 (+), U4.3 (VBAT), U$1.2
DBG_RESET: J3.3 (VSS(GND)), U1.P$1 (RESET(1))
DBG_TCK_SWCLK: J3.4 (ICSP_DAT/PGD), U1.P$39 (PF0(39))
DBG_TDI_SWDIO: J3.2 (VDD), U1.P$40 (PF1(40))
DBG_TDI_SWO: J3.6 (LVP), U1.P$41 (PF2(41))
GND: C1.2, C2.2, C3.2, C4.2, C5.2, C6.2, C7.2, C8.2, C9.2, C10.2, J1.P$5 (GND), J2.1 (-), J3.5 (ICSP_CLK/PGC), R3.1, R4.1, R5.1, R6.1, R7.1, R9.1, R10.1, S1.P$4, U1.P$2 (GND), U1.P$3 (GND), U1.P$6 (GND), U1.P$25 (GND), U1.P$27 (GND), U1.P$29 (GND), U1.P$32 (GND), U1.P$47 (GND), U1.P$50 (GND), U1.P$51 (GND), U1.P$52 (GND), U1.P$53 (ANT_GND(53)), U1.P$54 (GND), U1.P$55 (GND), U1.P$56 (GND), U2.5 (SDO_A/G), U2.6 (SDO_M), U2.14 (RES), U2.15 (RES), U2.16 (RES), U2.17 (RES), U2.18 (RES), U2.19 (GND), U2.20 (GND), U3.2 (GND), U3.4 (GND), U4.2 (VSS)
IRQ1: U1.P$12 (PD14(12)), U2.11 (INT1_A/G)
IRQ2: U1.P$11 (PD13(11)), U2.12 (INT2_A/G)
IRQ3: U1.P$14 (PA0(14)), U2.9 (DRDY_M)
IRQ4: U1.P$13 (PD15(13)), U2.10 (INT_M)
unnamed: LED1.A, U1.P$22 (PB13(22))
unnamed: LED4.A, U1.P$21 (PB12(21))
unnamed: LED2.A, U1.P$20 (PB11(20))
unnamed: LED5.A, U1.P$19 (PA5(19))
unnamed: LED3.C, R6.2
unnamed: LED3.A, U1.P$18 (PA4(18))
unnamed: C5.1, U2.21 (CAP)
unnamed: C6.1, U2.24 (C1)
unnamed: C7.1, J1.P$1 (VCC), R8.1, U4.4 (VIN)
unnamed: R9.2, U4.5 (PROG)
unnamed: LED6.A, R8.2
unnamed: LED6.C, U4.1 (STAT)
unnamed: S1.P$2, U1.P$9 (PD11(9))
unnamed: LED7.C, R10.2
unnamed: LED7.A, U1.P$17 (PA3(17))
unnamed: LED4.C, R5.2
unnamed: LED2.C, R7.2
unnamed: LED5.C, R4.2
unnamed: U1.P$4 (2G4RF_ANT_IN(4)), U1.P$5 (2G4RF_PORT(5))
unnamed: LED1.C, R3.2
unnamed: U1.P$48 (HFXO_IN(48)), U1.P$49 (HFXO_OUT(49))
POWER_IN: C8.1, U3.1 (IN), U3.3 (EN), U$1.3
SCL: R1.2, U1.P$38 (PC11(38)), U2.2 (SCL/SPC)
SDA: R2.2, U1.P$37 (PC10(37)), U2.4 (SDA/SDI/SDO)
V_1V8(28): U1.P$28 (V_1V8(28))

Notes on the sheet:
Bluetooth & MCU
IMU
Power & Charging
Test and Debug

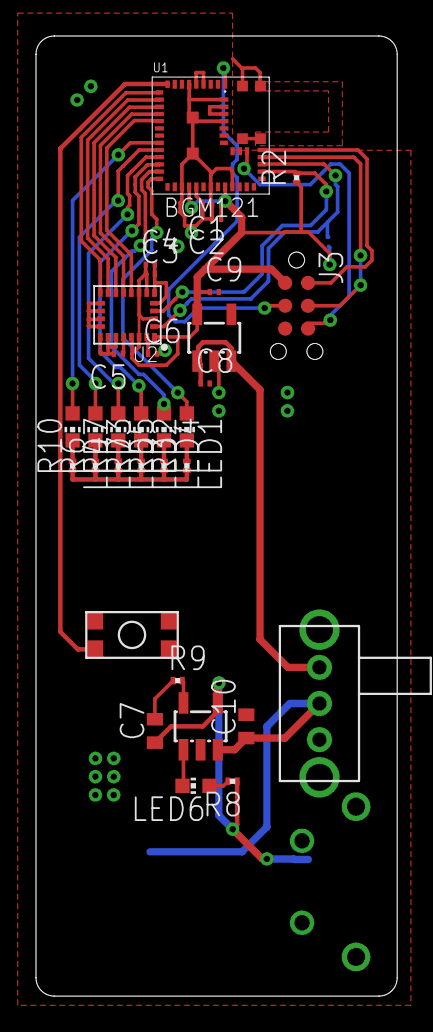
[picture p42: board Controllerv2.brd from above]

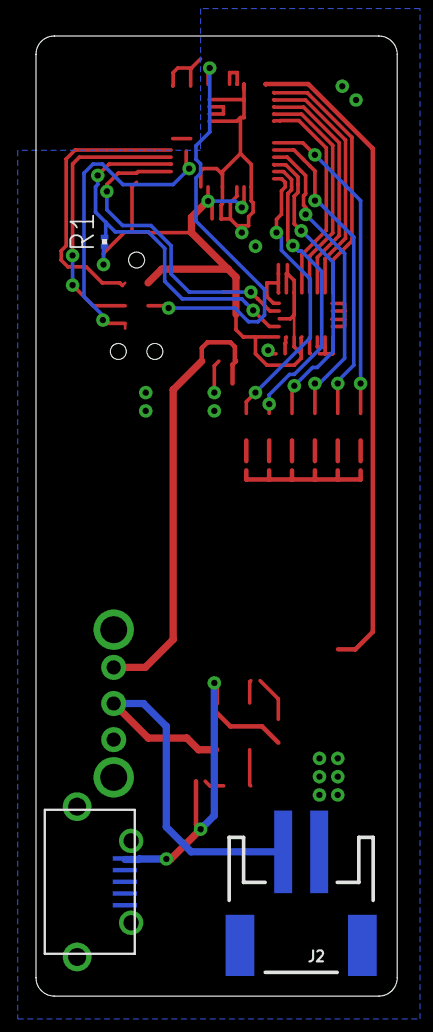
[picture p43: board Controllerv2.brd from below]

Board: 2 copper layers, 20.1 x 53.3 mm, 36 parts (3 on the bottom side), 36 nets.
