charlesh97/electric-longboard-bms/(notices)

Notices in the files:
parts and their libraries:
SparkFun-Connectors: Licensing: Creative Commons ShareAlike 4.0 International - https://creativecommons.org/licenses/by-sa/4.0
Tag-Connect-Footprints: ©2009 ROFA.cz - modified and updated by Robert Darlington ‹rdarlington@gmail.com›
